leike70/RoboSister_Group2/docs/HARDWARE_TOPOLOGY.md

# 硬件拓扑与待确认表

本表只记录能从工程、配置、规则文档直接确认的内容。空着的不是“已确认”，而是**待确认**；不要用推理补成实物接线。

| 项目 | 工程车 | 炮台车 | 当前状态 / 备注 |
| --- | --- | --- | --- |
| 主控 C 板 | 1 块 STM32F407IGH6 | 1 块 STM32F407IGH6 | 代码/`.ioc` 确认；实际板卡未核验 |
| 电池 | 1 块 TB47/48（按规则） | 1 块 TB47/48（按规则） | 具体电池、接口、配电待确认 |
| 电源管理 | 待确认 | 待确认 | 炮台车测速管理模块/裁判主控接线待核验 |
| 底盘 | 左右履带，2×M3508（配置） | 左右履带，2×M3508（配置） | 轮距/轮径/减速比/方向待测 |
| 抬升 | 前/后 2×GM6020（配置） | 前/后 2×GM6020（配置） | 行程、同步、支撑/制动待确认 |
| 机械臂 | 2×达妙 4310（Yaw/Shoulder）、2×M3508（Elbow/Wrist）、1×M2006（Gripper） | 无 | 连杆、零位、限位、夹爪待确认 |
| 云台/发射 | 无 | GM6020 Yaw、达妙 6006 Pitch、2×M3508 摩擦、1×M2006 拨弹 | 限位、零位、摩擦/拨弹参数待确认 |
| CAN | CAN1/CAN2 | CAN1/CAN2 | 总线分配、设备 ID、报文 ID 待确认；0x31 来源总线未确认 |
| 功率/能量反馈 | 裁判 0x31（候选） | 裁判 0x31（候选） | 标准帧 DLC=4；实际接 CAN1/CAN2、周期、超时待确认 |
| 遥控 | USART3 + DMA/IDLE，DR16/DT7 DBUS | 同左 | 电平/反相、帧周期、S1/S2 映射待上板核验 |
| IMU | SPI1 BMI088 | 同左 | 安装方向、轴向、采样时序待标定 |
| 加热 | PF6 / TIM10_CH1 | 同左 | 加热器功率、热惯性、目标温度/PID/保护阈值待测 |
| 调试/烧录 | DAP-Link，`daplink_f4.cfg` | 同左 | 本轮未连接硬件，未执行烧录 |
| 规则限制 | 底盘 50 W / 500 J | 底盘 40 W / 400 J | 规则值已写入配置；规则版本仍有疑点，最终以赛务为准 |

## 接线原则

- 两车各一块 C 板，各自独立供电和控制；公共逻辑分别保存并同步维护。
- 底盘动力与机身/上层供电按规则分开，具体端口以最终接线图为准。
- 裁判系统主控模块单独列出，不等同于第二块 C 板。
- 任何未确认的 CAN 总线、ID、方向、减速比、零位、限位和 PID 继续保持未配置。
