leike70/RoboSister_Group2/docs/RULES_REQUIREMENTS.md

# 比赛规则对两车开发的要求

[此部分内容由AI生成]

阅读日期：2026-11-10。来源为 `资料文件/RoboSister_2026_比赛规则手册.pdf`，共 33 页。已通读全文提取文字，并查看版本页、功率/规格/物资表和裁判系统接线图。页码均为 PDF 实际页码。本文区分手册要求与开发建议，最终解释以赛务为准。

## 1. 版本疑点

封面写 V1.1，版本历史却已有日期空白的 V1.2，涉及考核、功率和缓冲能量。先按这份文件正文登记，不宣称已确认最终版。第 11 页称能量低于 0 J 断电，第 12 页步骤 e 写 `Z <= 0`；软件规划应避免触及 0 J，最终判定需核实赛务与实际模块。两车配置现已登记 50 W/500 J 与 40 W/400 J，仍需确认最终规则版本。

## 2. 两车硬约束

来源：第 12–13 页第 2 章、第 16–17 页 3.3.3。

| 项目 | 工程车 | 炮台车 |
| --- | --- | --- |
| 初始位置 | 启动区 1 | 启动区 2 |
| 底盘功率上限 | 50 W | 40 W |
| 缓冲能量上限 | 500 J | 400 J |
| 最大重量 | 15 kg，含裁判系统、不含 TB47/48 电池 | 12.5 kg，含裁判系统、不含 TB47/48 电池及 17 mm 弹丸 |
| 初始尺寸 | 450×450×450 mm | 400×400×400 mm |
| 伸展尺寸 | 700×700×700 mm | 600×600×600 mm |
| 初始弹丸 | 不得携带 17 mm 弹丸 | 基础 30 发，考核名次有调整，实际额度需核实 |
| 发射机构 | 无 | 1 个 17 mm 发射机构，初速度不大于 25 m/s |
| 操作手 | 1 名 | 1 名 |

尺寸约束覆盖地面投影和最高点，需要检查整车抬升、机械臂/云台运动的完整包络，不能只约束末端坐标。手册建议预留 100 g、5 mm 余量。相同底盘设计仍可使用，但两车的功率配置与整车包络不同。

## 3. 功率与供电：从占位预算转到真实规则

来源：第 11–12 页 1.5、第 14 页 3.2.2、第 29 页 7.1、第 32 页接线图。

水平行进、转向动力计入底盘功率；抬升车体等功能性越障动作不计入，具体机构归属由组委会判定。按现有方案，左右履带计入底盘侧，抬升与上层机构按机身侧规划并核验。`App/Power/` 已解析 0x31 并计算底盘策略；旧的全车归一化预算只供非底盘路径作代理量，电机最终限流尚未接入，不能据此证明满足 50 W/40 W 限制。

手册机制：初始能量 Z 设为本车上限 Q；裁判每 1 ms 按 `Z = Z - (Pr - Pl) * 0.001` 计算，限制在 -10 J 到 Q；触及断电条件后底盘断电 5 秒，期间继续计算能量。软件估计不能代替裁判真值。

### 已明确的电源模块反馈

| 字段 | 手册定义 |
| --- | --- |
| 帧类型、ID | 标准 CAN，`0x31` |
| 波特率、DLC | 1 Mbps，4 字节 |
| 数据 0–1 | 小端有符号 int16，底盘功率，0.1 W/单位 |
| 数据 2–3 | 小端有符号 int16，缓冲能量，0.1 J/单位 |

解析例子：`F4 01 88 13` 对应 50 W、500 J；`90 01 A0 0F` 对应 40 W、400 J；能量字节 `F6 FF` 对应 -1 J。需要检查帧类型、ID、DLC、时间戳和有效性，不能套用只面向 8 字节电机帧的解析。

尚未确认：实际接本车 CAN1 还是 CAN2、反馈发送周期与失联阈值。1000 Hz 是裁判能量结算频率，不等于 CAN 报文频率。开发需处理底盘被断电、机身仍供电的状态，恢复后不得直接重发旧行进请求。

电池接电源管理模块，炮台车测速管理模块另有直接电池供电支路；其余电池供电设备经电源管理模块输出。行进动力接底盘端口，其他接机身端口；底盘供电板不得又接机身电源。每车最多一块 TB47/48 电池，电池输出电流不大于 27 A，电池负极到任意点电压不超过 30 V；机械电源开关应便于快速接触。

## 4. C 板与裁判主控模块必须区分

来源：第 26 页物资表、第 29–32 页模块图与接线图。

- C 型开发板共提供 2 块，本项目每车 1 块，用于本车程序。
- 裁判系统另有 1 个“主控模块”，炮台车搭载，通过 MainCtrl 航空口连接测速管理模块；它不是第二块可编写整车控制程序的 C 板。
- 炮台车还需测速管理模块与 17 mm 测速模块。裁判主控安装须满足第 16 页外侧、平放及直径 70 mm 上半球净空要求。

所以“一辆车只有一个 C 板”的工程约定不变，但物资、接线图和说明书必须单列裁判模块。这次查看的是规则手册内接线图，不等于已核对此前共享附件《走线.pdf》的实物接线。

## 5. 任务与比赛流程对现有计划的影响

来源：第 7–11 页 1.2–1.4，第 18–23 页第 4 章。

| 内容 | 规则依据与开发含义 |
| --- | --- |
| 弹药补给 | 弹药箱约 150×150×50 mm，每箱 30 发；直接撒到地面会受罚。夹持、搬运和倾倒需控制姿态并对准弹仓 |
| 飞镖 | 场上共 2 个；对同一基地首次有效造成 600 点、之后 800 点伤害。不能假设两枚一定都能取得 |
| 能量单元 | 蓝、粉各 1 个，可分别屏蔽上、下装甲伤害 5 分钟。之前计划遗漏，应增加抓取/放置任务候选 |
| 兑换框左右格 | 飞镖放左格对应上装甲、右格对应下装甲。对应装甲已屏蔽时，飞镖解除屏蔽而不造成伤害；目标位置不能只写一个统一兑换点 |
| 基地接触 | 自身结构不能直接接触基地，兑换处例外；违规可罚下。需检查连杆、夹爪包络与操作路径 |
| 发射与增益 | 初速不大于 25 m/s 是限制；建议不高于 5 发/秒是识别频率建议。启动区 200%、二级台阶 300%攻击增益，生效/失效延迟不超过 5 秒，不应由程序自行认定已经生效 |
| 人工操控 | 各车 1 名操作手；优先验收手动抓取、搬运、倾倒和射击，再投入自动任务串联 |
| 考核训练 | 工程挑战 10 分钟，弹丸每颗 1 分、飞镖/能量单元各 100 分；射击挑战 7 分钟，3/5/8/10 m 各射 20 发。考核训练与正赛结算应分开 |

正赛准备阶段 2 分钟、比赛 10 分钟，结束后立即断电；维修和技术暂停有阶段限制。物理开关映射、使能、故障和停机状态应让操作手清晰掌握。新增任务未自动修改任务枚举、逆解或动作算法。

## 6. 电机物资与现有方案核对

来源：第 26 页 6.1.2。以下是计划用量，不代表实物已清点。

| 型号 | 提供数 | 当前两车合计 | 余量 |
| --- | --- | --- | --- |
| M3508 + C620 | 8 | 8 | 0 |
| GM6020 | 5 | 5 | 0 |
| M2006 + C610 | 3 | 2 | 1 |
| J4310 2EC V1.2 | 2 | 2 | 0 |
| J6006 2EC | 1 | 1 | 0 |

现有方案与物资数量匹配。物资表 3508 标为 19:1，但机构总减速比还包含外部传动，不能据此把全部 gear_ratio 统一设成 19。

## 7. 通信、日程与材料要求

- 第 14–15 页允许官方 DT7/DR16 或符合规则的自定义控制器；自定义控制器不联网，不与己方机器人之外的设备通信。无线调试器上场前移除。
- 第 21 页列 11 月 11 日完整形态考核、11 月 14 日预检录/训练、11 月 15 日决赛。该日程仅来自本文件，仍需核实赛务最新通知。
- 第 22 页要求考核分析中的 AI 内容明显标注 `[此部分内容由AI生成]`，并由队伍整理，不能大篇幅直接照搬；提交现有 AI 辅助材料时检查标注与来源。

## 8. 后续开发建议

先确认最终规则版本、实际物资和两车接线/CAN 分配；DR16 DBUS、BMI088/EKF 和 0x31 解析/履带策略已有软件实现，下一步上板核对接收电平、通道方向、IMU 安装方向与 0x31 实际来源。随后接通真实电机适配与最终限流，逐模块验收方向、零位、限位、手动操控及收纳姿态；再按剩余时间安排道具兑换、补给和不同距离射击训练。自动逆解与任务串联需在基础控制可靠后投入。
