leike70/RoboSister_Group2/docs/REFERENCE_LIBRARY.md

# 资料库索引：开发前到哪里找依据

本索引对应仓库根目录的 `资料文件/`。它帮助接手工程车、炮台车的成员和 agent 找到原始资料，并区分“资料写了什么”“项目已经实现什么”“实车核验了什么”。资料库是参考输入，不参与两车固件编译；资料中的示例工程、旧设计和厂商默认值不能直接当作本车接线或控制参数。

修改代码前先读[项目需求](PROJECT_REQUIREMENTS.md)、对应车辆及模块 README；涉及下表的协议、器件、规则或机构时，再打开相应原始资料核对。若资料与用户明确需求、当前工程配置或实物测量不一致，记录冲突并保留待确认状态，不自行覆盖。

| 开发任务 | 原始资料在哪里 | 当前整理/代码入口 | 使用边界 |
| --- | --- | --- | --- |
| 比赛限制、裁判系统、底盘功率/缓冲能量 | [RoboSister_2026_比赛规则手册.pdf](../资料文件/RoboSister_2026_比赛规则手册.pdf) | [规则摘录与版本疑点](RULES_REQUIREMENTS.md)、[硬件拓扑](HARDWARE_TOPOLOGY.md)、两车 `App/Power/` | 本地手册封面与版本历史有疑点；50 W/500 J、40 W/400 J 是本地手册值，最终版本以赛务确认为准。规则中的 0x31 格式不证明实际接在 CAN1 或 CAN2。 |
| 遥控 DBUS 帧、通道/开关/键鼠解析 | [遥控器控制协议V1.4.pdf](../资料文件/遥控器/遥控器控制协议V1.4.pdf)、[DT7&DR16遥控系统用户手册_中文.pdf](../资料文件/遥控器/DT7&DR16遥控系统用户手册_中文.pdf) | [遥控与任务说明](PERIPHERALS_AND_TASKS.md)、两车 `User_Driver/Remote/`、`Bsp/remote_uart.*`、`App/Remote/` | 协议格式可用于核对解析；实际电平/反相、帧周期、S1/S2 与控制方向仍须上板确认。中/上/下档的项目语义以当前需求为准，不能从参考工程推断。 |
| 大疆 M3508/M2006/GM6020 与 C610/C620 电调 | [大疆电机资料目录](../资料文件/电机资料/大疆电机/)：各电机使用说明、3508 保养手册、C610/C620 电调说明 | 两车 `User_Driver/Motor_Driver/DJI_motor_driver.*`、`Bsp/CAN_bsp.*`、`Config/app_config.*`、[硬件拓扑](HARDWARE_TOPOLOGY.md) | 用手册核对电调协议、反馈 DLC、控制报文和额定范围；具体 CAN 总线、设备 ID、方向、零位、传动比、限位仍要按本车实物确认。 |
| 达妙 DM-J4310-2EC、DM-J6006-2EC | [达妙电机资料目录](../资料文件/电机资料/达妙电机/)：两份电机说明书及[调试助手/控制协议 V1.3](../资料文件/电机资料/达妙电机/调试助手使用说明书（达妙驱动控制协议）V1.3.pdf) | [项目需求中的机构分配](PROJECT_REQUIREMENTS.md)、各车 `Config/` 和将来的达妙适配层 | 工程车用 4310，炮台车 Pitch 用 6006；协议版本、控制模式、CAN ID 和量程须核实。当前车辆工程尚无可用的达妙电机适配层。 |
| BMI088、SPI、四元数 EKF、温控移植 | [陀螺仪移植文件/README.md](../资料文件/陀螺仪移植文件/README.md)、`Components/Devices/BMI088driver.*`、`Components/Algorithm/QuaternionEKF.*`、`Components/kalman_filter.*`、`Application/ins_task.*`、`Src/spi.c` | 两车 `Bsp/imu_bsp.*`、`Bsp/imu_heater.*`、`User_Driver/IMU/`、`Task/imu_task.*`、[当前 IMU/温控说明](PERIPHERALS_AND_TASKS.md) | 这是独立的 C 板参考工程，包含它自己的 HAL、FreeRTOS、构建和调试文件。查算法/寄存器/流程时参考，不把整个参考工程复制进两车。当前代码已移植但轴向、加热器和实时性未上板核验。 |
| 机构构型、空间约束和历史方案 | [期中设计思路](../资料文件/2组期中考核/文档/设计思路.docx)、[期中答辩](../资料文件/2组期中考核/文档/期中答辩.pptx)、[工程机器人总装](../资料文件/2组期中考核/工程机器人总装/)、[炮塔机器人总装](../资料文件/2组期中考核/炮塔机器人总装/) | [项目需求](PROJECT_REQUIREMENTS.md)、[硬件拓扑](HARDWARE_TOPOLOGY.md)、两车各自机构模块 | 期中方案和 CAD 可帮助找装配、干涉、尺寸线索；不能据文件名或历史模型认定最终实物尺寸、传动、零位、限位和线束。最终装配与测量优先。 |

## 资料库中的几个易混淆点

- `资料文件/陀螺仪移植文件/` 是**参考工程**，其中的 `Drivers/`、`Middlewares/`、`MDK-ARM/`、`.ioc` 和编译产物不属于当前两车固件源码；当前实现应在各自 `project file/` 内查找。
- `资料文件/2组期中考核/` 保存两车装配及阶段文档，不能替代本车最新的电机映射表和实测参数。
- 规则手册提到的裁判系统“主控模块”与两辆车各自的 C 板是不同设备；0x31 功率帧的**协议定义**、**接线来源**和**已上板验证**是三件事。[规则摘录](RULES_REQUIREMENTS.md)记录了已知值与疑点。
- 资料库目前没有可直接确认本车 CAN1/CAN2 设备分配、全部电机 ID、实车安装方向、机构零位/限位、IMU 加热器参数的最终接线/标定表。相关配置继续保持待确认；拿到经核验的数据后，先更新[硬件拓扑](HARDWARE_TOPOLOGY.md)和对应车辆配置。

本索引按文件目录、资料标题和已有项目文档建立；它不表示已逐页复核每份厂商手册，也不表示资料中的示例已在实车验证。新增或替换资料时，同步更新本表的入口、版本与核验状态。
