leike70/RoboSister_Group2/资料文件/2组期中考核/文档/期中答辩.pptx

## 期中答辩

## 场地分析：

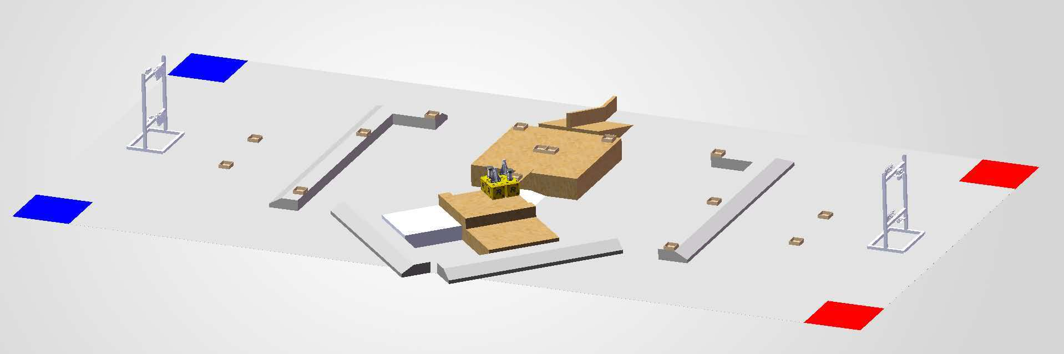
[picture p1: figure]
51cfad9a7a7458d218ad67e008c4f556

## 战术分析：

- 工程炮塔一起上台阶
- 工程拿飞镖去对面基地
- 炮塔吃300%增益

## 上台阶：

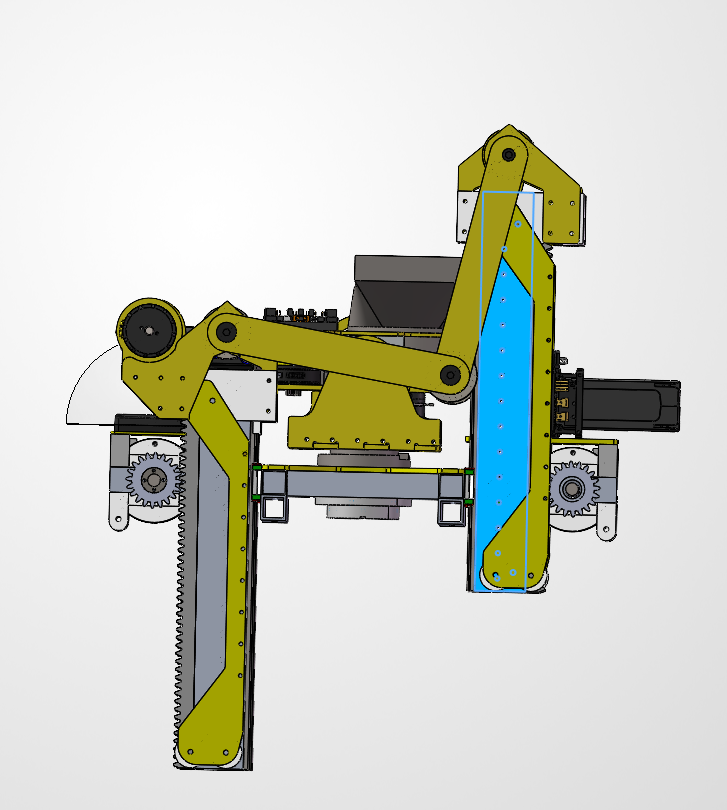
[picture p2: figure]
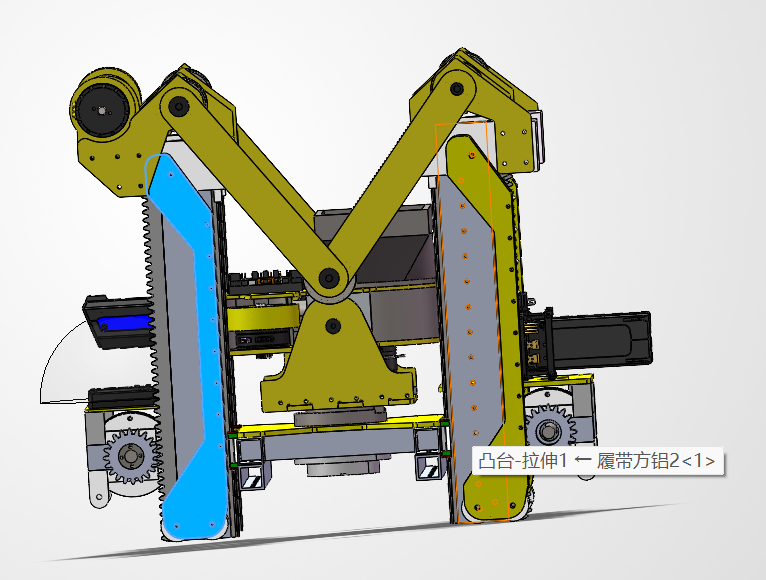
[picture p3: figure]
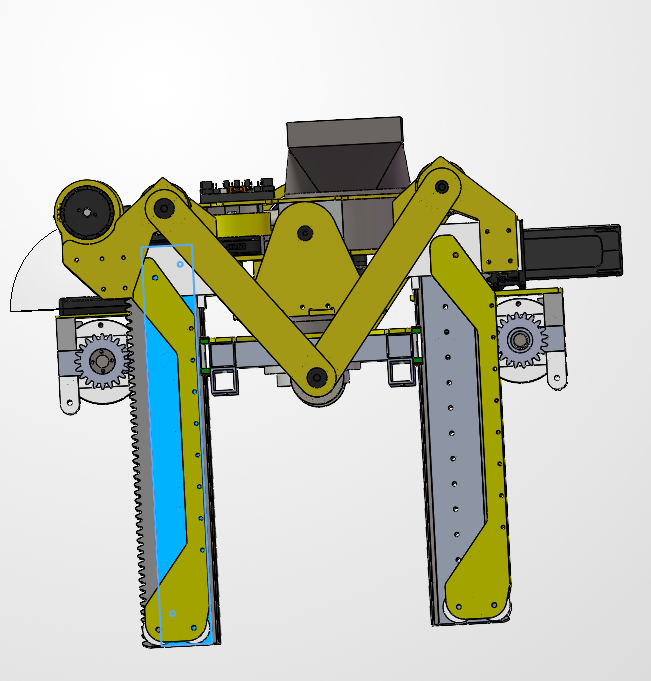
[picture p4: figure]

## 抓取：

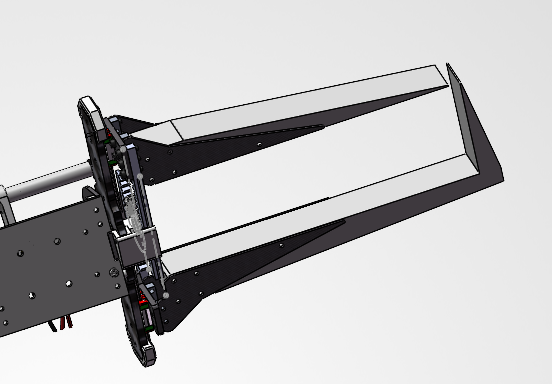
[picture p5: figure]

## 风险评估：

车架：稳定性（能否上台阶）
机械臂：重心问题
炮塔：视觉模块，瞄准

## Slide 7
