leike70/RoboSister_Group2/资料文件/2组期中考核/文档/设计思路.docx

轮组设计说明：

目标：旨在让工程和炮塔两台车都拥有上下台阶的能力

实现原理：大体思路参考杨瀚翔提出的设想，通过四个竖直放置可升降轮腿实现爬升。爬升动作：1四腿将整车抬起 2前进至辅助轮接触台阶 3上抬前轮组至辅助轮和台阶面高度 4前进至腹辅助轮接触台阶 5后轮组抬起至台阶面 6继续前进，已在台阶上

主要设计：首先，由于电机数量限制，最终分配到轮组的电机为每辆车两个3508，所以驱动模式参照坦克的同侧同转向实现基础移动功能。其次，因为单侧前后轮升降不同步，同一对应点之间距离存在变动，为了能在前后两个轮间传输动力，传统的同步带直连无法使用，参照初中学过的三角形，使用两段固定长度的同步带组合成两条边，以替代原来直连长度不可动的缺陷。最后，补齐基础功能所需架构，由6020驱动的升降结构和固定使用的滑轨滑块，其中滑轨放在内侧，车架受力更稳定。电机侧置，为尺寸限制留出更多空余。

腿型迭代：初版的腿方铝是直接在履带下的，这样会导致只有单根滑轨受力且履带有概率与方铝发生干磨，结合杨羡夫的方案，组成当前版本的方铝承压，玻纤板支撑履带带轮的结构。

小臂设计说明：

使用M3508作为roll小pitch的关节电机,扭力较大 小roll与爪部采用M5D10的铝柱连接,电机外包一个滚针轴承作为支撑,轴承用一个打印 件抱紧。 roll 和小臂通过玻纤板连接,板材之间采用榫卯+铝排的连接方式 小 pitch 通过M8的杯头螺栓限位,转角大概100度左右 小臂的两块板材使用铜柱支撑

小 pitch一端电机连接打印件,另一端通过打印件固定一个推力球轴承,轴承内圈用于固定 的打印件与大臂相连,靠两块大臂板材压紧。

大臂设计说明：

介于此次比赛采用的战术 工程车的任务是 1.在一级台阶下完成弹仓的拾取并将其举起抬升给在一级台阶上的炮塔车装弹 2.登上二级台阶并拾取飞镖道具 一个放入储存框一个夹持在手部 故全车轮组车架采用和炮塔车相同的履带可抬升版车架 且使用五轴机械臂完成动作

一 大yaw轴 电机采用DM 4310直驱 在底部打印件垫块与板材间做了限位使之可以完成180°转向并且不能转超过270°

炮塔设计说明：

炮塔采用上供弹，简便高效。采用3508作为摩擦轮，射速大。Pitch轴采用6020，扭矩大，适合大重量炮塔。Yaw轴采用J6006，扭矩极大，稳定性极强，便于精确快速瞄准。漏斗做的很大，便于倒弹。
