leike70/RoboSister_Group2/docs/archive/README.md

# 历史记录

这里保存已完成阶段的检查、提示词和交付记录。当前开发从 [文档目录](../README.md) 开始，接口与遥控状态以 [当前说明](../PERIPHERALS_AND_TASKS.md) 为准。

| 记录 | 用途 |
| --- | --- |
| [基础工程检查](BASELINE_REVIEW.md) | 原始工程基线、驱动问题及最初构建结果 |
| [首轮框架提示词](DEEPSEEK_PROMPT.md) | 当时交给DeepSeek的任务原文，仅作历史留存 |
| [首轮框架交付](FRAMEWORK.md) | 首轮模块、启动与调度、构建和待办 |
| [首轮框架复核](FRAMEWORK_REVIEW.md) | 当时发现的四项逻辑问题 |
| [四项修复与验证](FRAMEWORK_FIXES.md) | 模式隔离、故障恢复、快照与姿态有效性修复 |
| [后续交付与遥控整改](DEEPSEEK_HANDOFF_RESULT.md) | 三档整理、接收接入、到达时间与原始快照修复记录 |

文中代码位置和构建目录通常从项目根起算；提到的旧模式、未接入状态、内存占用和测试范围应结合当时阶段理解。“根README第几节”的旧结构已移入 [项目约定](../PROJECT_REQUIREMENTS.md)。
