leike70/RoboSister_Group2/资料文件/2组期中考核/工程机器人总装/联轴打印.SLDPRT

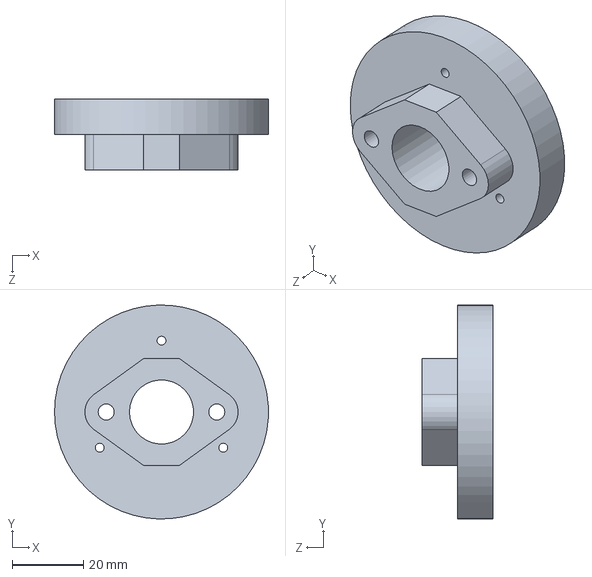
[picture p15: CAD file, 2026-11-10]
资料文件/2组期中考核/工程机器人总装/联轴打印.SLDPRT
60.0 x 60.0 x 20.0 mm
