leike70/RoboSister_Group2/资料文件/2组期中考核/炮塔机器人总装/同步带连接臂_外.SLDPRT

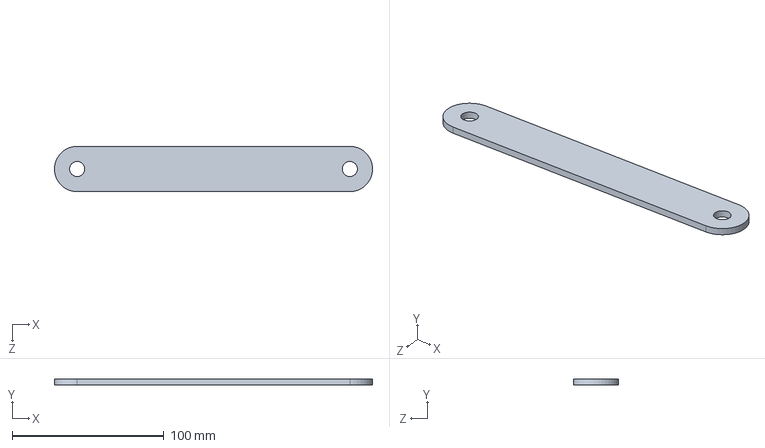
[picture p16: CAD file, 2026-11-10]
资料文件/2组期中考核/炮塔机器人总装/同步带连接臂_外.SLDPRT
209.9 x 4.00 x 30.0 mm
