leike70/RoboSister_Group2/资料文件/2组期中考核/工程机器人总装/推力球轴承45-65-14.SLDPRT

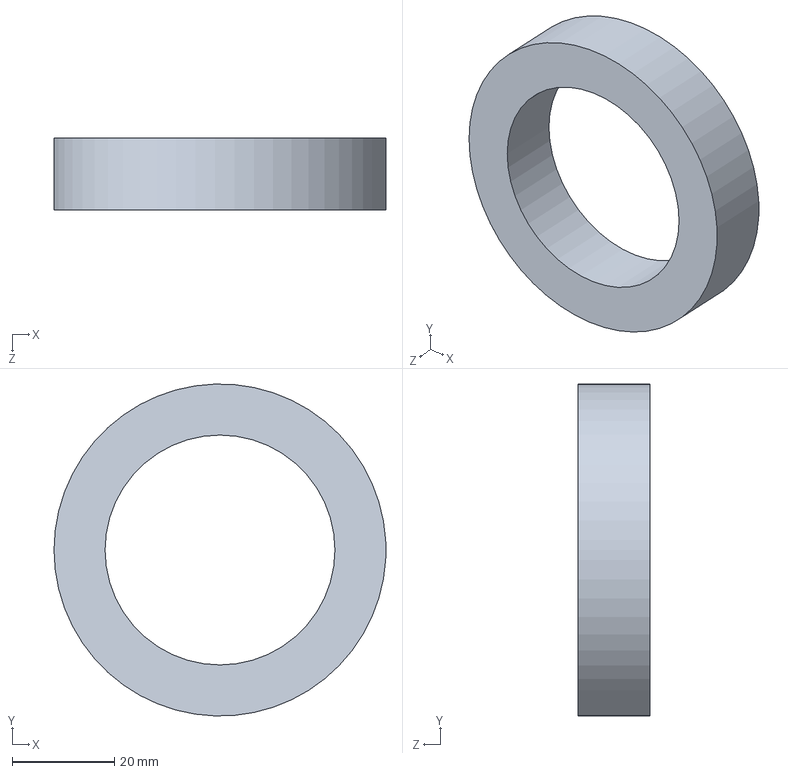
[picture p17: CAD file, 2026-11-10]
资料文件/2组期中考核/工程机器人总装/推力球轴承45-65-14.SLDPRT
65.0 x 65.0 x 14.0 mm
