leike70/RoboSister_Group2/资料文件/2组期中考核/炮塔机器人总装/法兰轴承10-19-7-21-1.SLDPRT

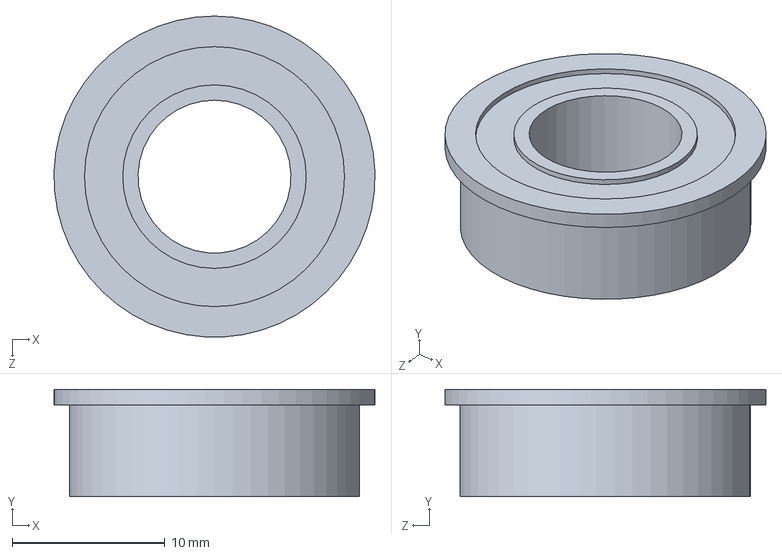
[picture p19: CAD file, 2026-11-10]
资料文件/2组期中考核/炮塔机器人总装/法兰轴承10-19-7-21-1.SLDPRT
21.0 x 7.00 x 21.0 mm
