leike70/RoboSister_Group2/资料文件/2组期中考核/工程机器人总装/同步带同步轮-关节.SLDPRT

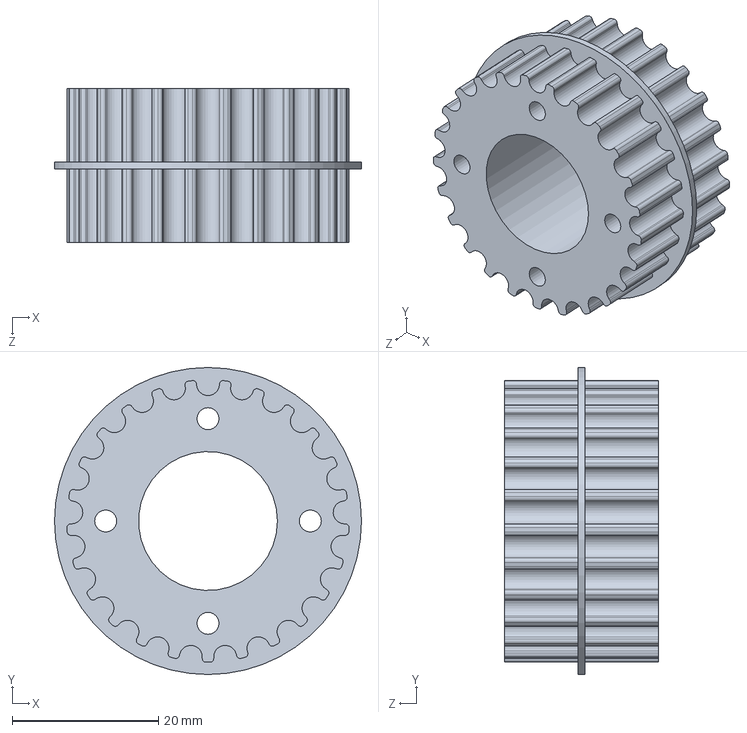
[picture p20: CAD file, 2026-11-10]
资料文件/2组期中考核/工程机器人总装/同步带同步轮-关节.SLDPRT
42.0 x 42.0 x 21.0 mm
