leike70/RoboSister_Group2/资料文件/2组期中考核/炮塔机器人总装/M3508直流无刷减速电机.SLDPRT

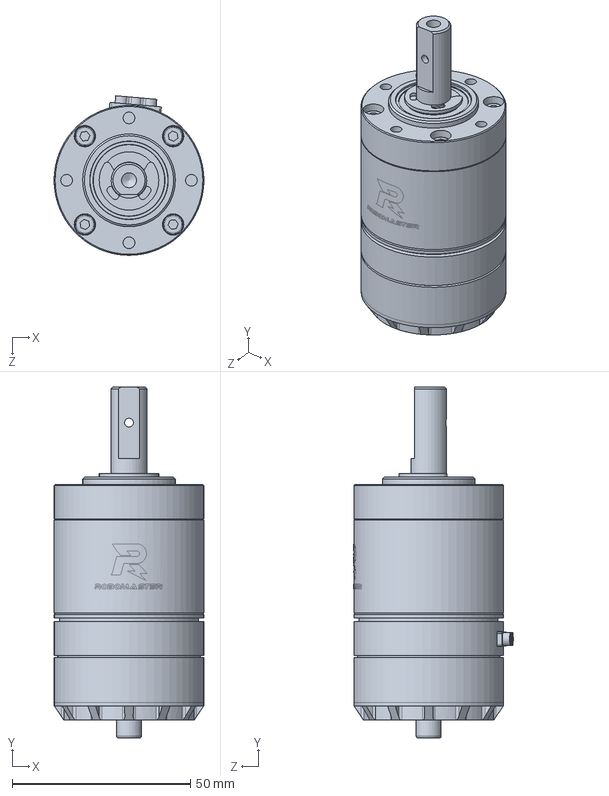
[picture p21: CAD file, 2026-11-10]
资料文件/2组期中考核/炮塔机器人总装/M3508直流无刷减速电机.SLDPRT
42.0 x 98.4 x 44.7 mm
