leike70/RoboSister_Group2/资料文件/2组期中考核/炮塔机器人总装/垫片M10-14-1.SLDPRT

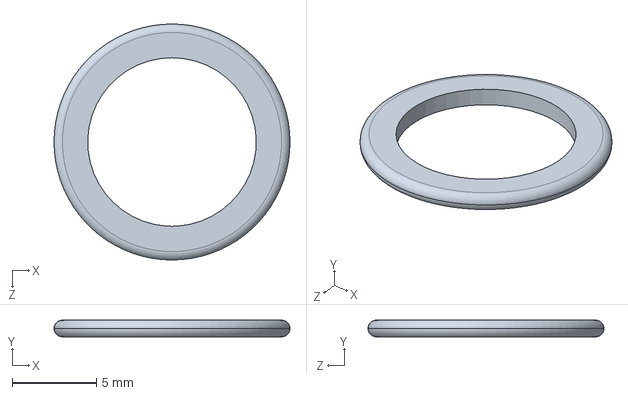
[picture p22: CAD file, 2026-11-10]
资料文件/2组期中考核/炮塔机器人总装/垫片M10-14-1.SLDPRT
14.0 x 1.00 x 14.0 mm
