leike70/RoboSister_Group2/资料文件/2组期中考核/炮塔机器人总装/履带碳板.SLDPRT

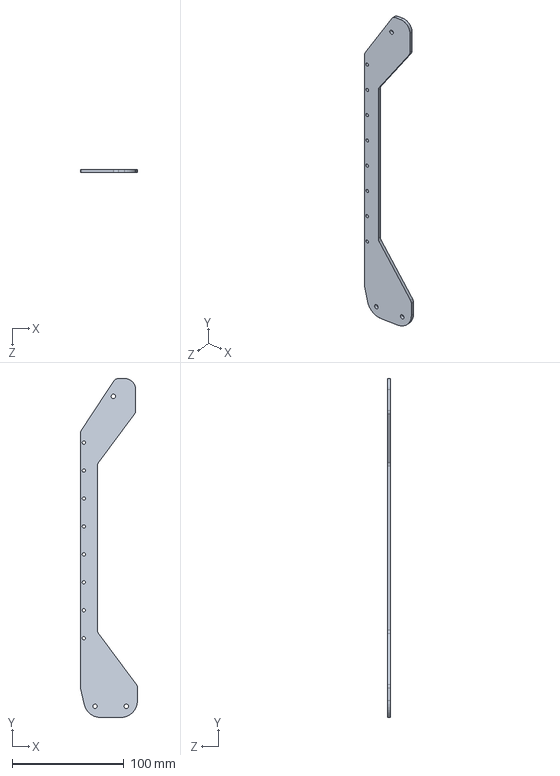
[picture p23: CAD file, 2026-11-10]
资料文件/2组期中考核/炮塔机器人总装/履带碳板.SLDPRT
51.0 x 303.4 x 3.00 mm
