leike70/RoboSister_Group2/资料文件/2组期中考核/工程机器人总装/同步带履带同步轮组合-从动轮盖片.SLDPRT

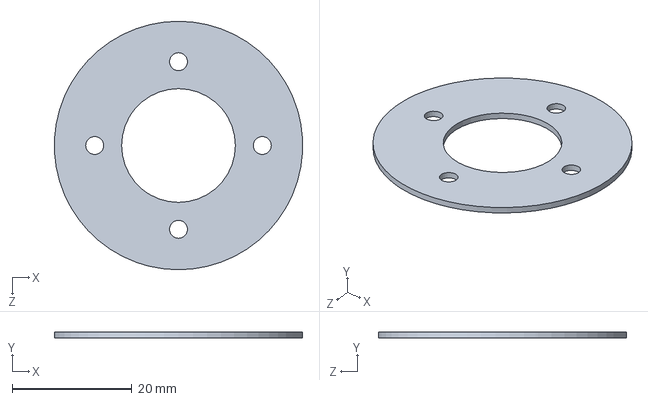
[picture p24: CAD file, 2026-11-10]
资料文件/2组期中考核/工程机器人总装/同步带履带同步轮组合-从动轮盖片.SLDPRT
41.4 x 1.00 x 41.5 mm
