leike70/RoboSister_Group2/资料文件/2组期中考核/炮塔机器人总装/M2006 P36直流无刷减速电机.SLDPRT

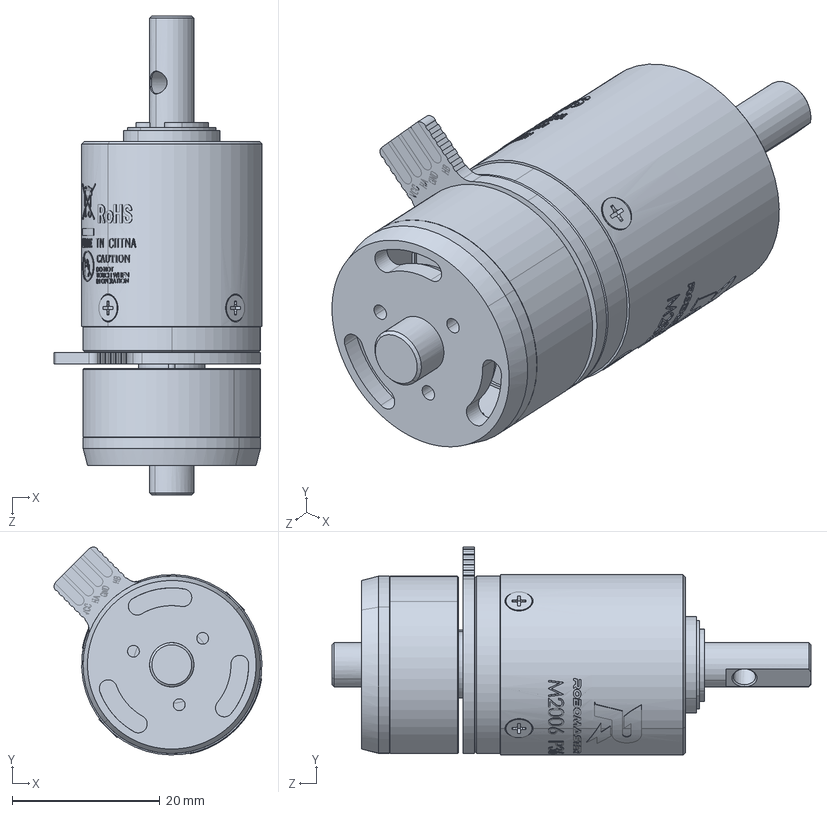
[picture p25: CAD file, 2026-11-10]
资料文件/2组期中考核/炮塔机器人总装/M2006 P36直流无刷减速电机.SLDPRT
28.1 x 28.1 x 64.8 mm
