leike70/RoboSister_Group2/资料文件/2组期中考核/工程机器人总装/台湾上银MGN9C滑块.SLDPRT

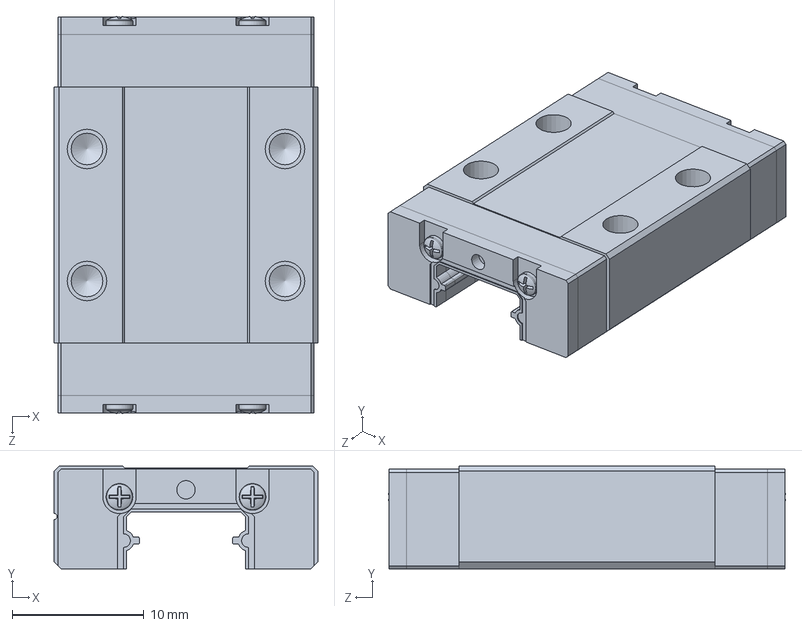
[picture p26: CAD file, 2026-11-10]
资料文件/2组期中考核/工程机器人总装/台湾上银MGN9C滑块.SLDPRT
20.0 x 7.80 x 30.1 mm
