leike70/RoboSister_Group2/资料文件/2组期中考核/炮塔机器人总装/天轮打印1号.SLDPRT

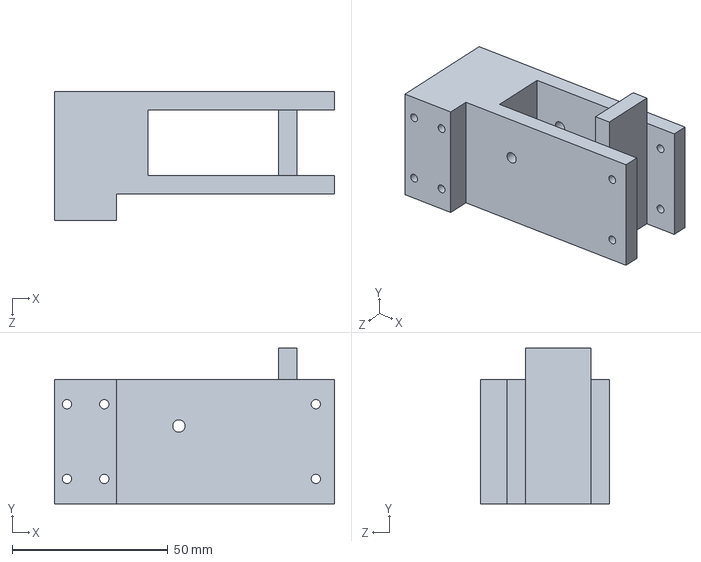
[picture p27: CAD file, 2026-11-10]
资料文件/2组期中考核/炮塔机器人总装/天轮打印1号.SLDPRT
90.0 x 50.0 x 41.5 mm
