leike70/RoboSister_Group2/资料文件/2组期中考核/工程机器人总装/天轮支撑板_C.SLDPRT

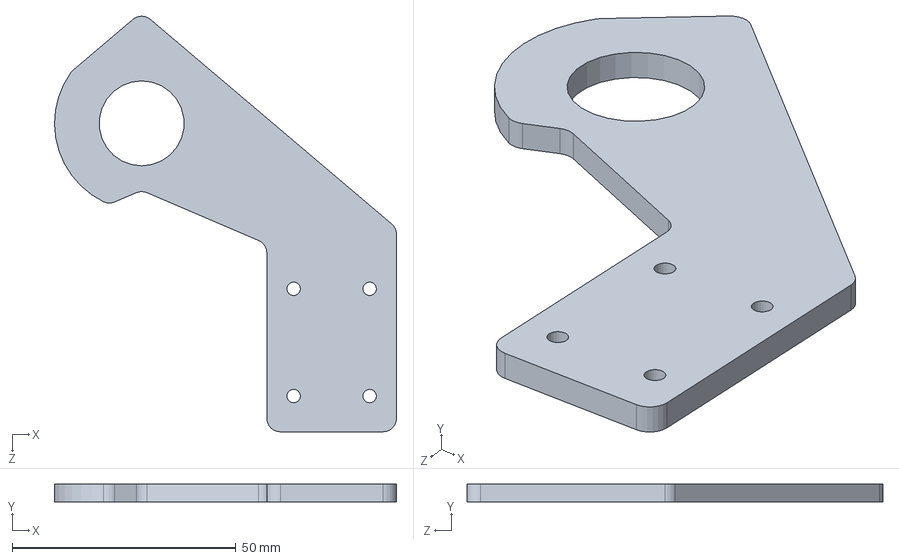
[picture p28: CAD file, 2026-11-10]
资料文件/2组期中考核/工程机器人总装/天轮支撑板_C.SLDPRT
76.5 x 4.00 x 93.0 mm
