leike70/RoboSister_Group2/资料文件/2组期中考核/炮塔机器人总装/支撑板1.SLDPRT

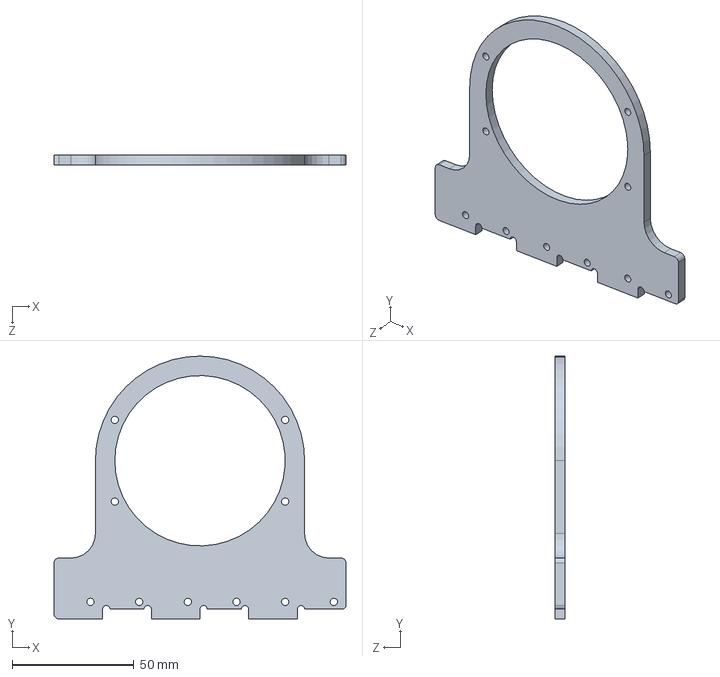
[picture p29: CAD file, 2026-11-10]
资料文件/2组期中考核/炮塔机器人总装/支撑板1.SLDPRT
120.0 x 108.0 x 4.00 mm
