leike70/RoboSister_Group2/资料文件/2组期中考核/工程机器人总装/齿条固定件.SLDPRT

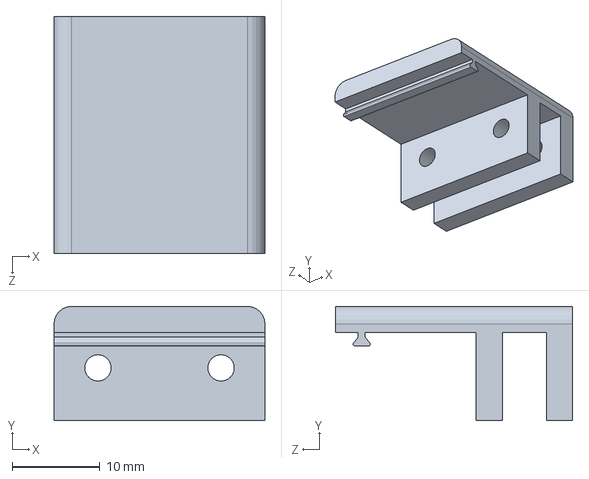
[picture p30: CAD file, 2026-11-10]
资料文件/2组期中考核/工程机器人总装/齿条固定件.SLDPRT
24.0 x 13.0 x 27.0 mm
