leike70/RoboSister_Group2/资料文件/2组期中考核/炮塔机器人总装/RoboMaster GM6020.SLDPRT

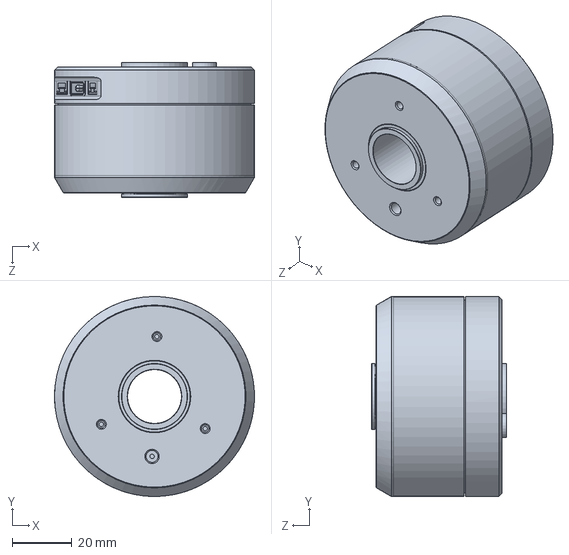
[picture p31: CAD file, 2026-11-10]
资料文件/2组期中考核/炮塔机器人总装/RoboMaster GM6020.SLDPRT
66.7 x 66.7 x 45.0 mm
