leike70/RoboSister_Group2/资料文件/2组期中考核/工程机器人总装/机械臂连接处轴承内圈上.SLDPRT

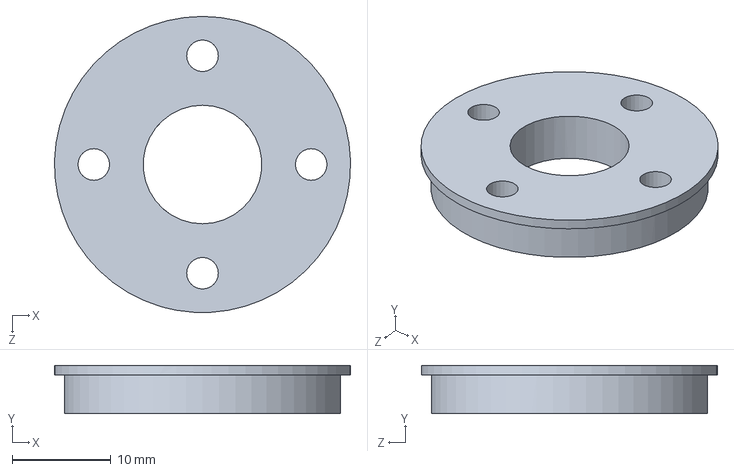
[picture p32: CAD file, 2026-11-10]
资料文件/2组期中考核/工程机器人总装/机械臂连接处轴承内圈上.SLDPRT
29.9 x 4.90 x 30.0 mm
