leike70/RoboSister_Group2/资料文件/2组期中考核/炮塔机器人总装/轴铝方管.SLDPRT

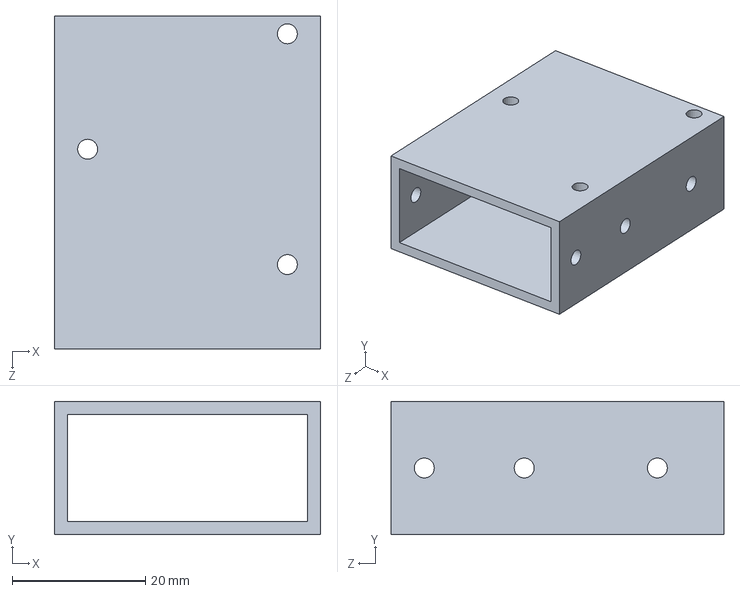
[picture p33: CAD file, 2026-11-10]
资料文件/2组期中考核/炮塔机器人总装/轴铝方管.SLDPRT
40.0 x 20.0 x 50.0 mm
