leike70/RoboSister_Group2/资料文件/2组期中考核/工程机器人总装/防松螺母M8.SLDPRT

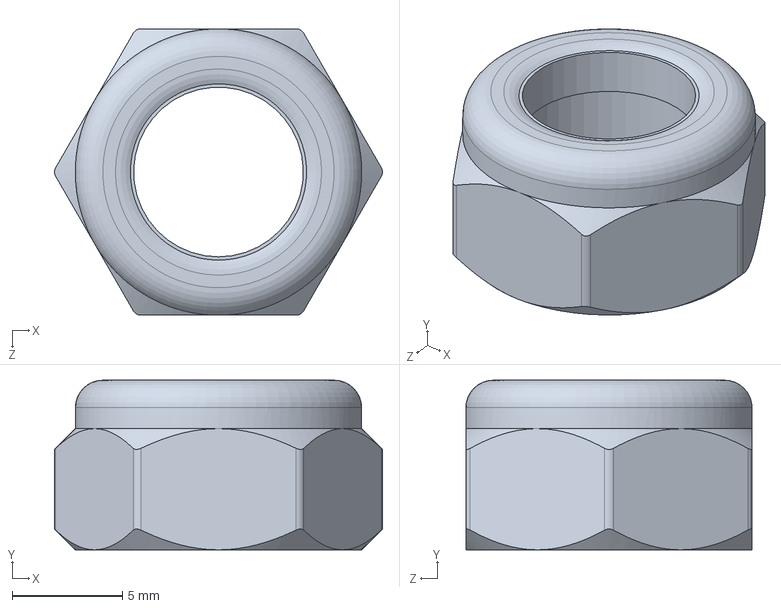
[picture p34: CAD file, 2026-11-10]
资料文件/2组期中考核/工程机器人总装/防松螺母M8.SLDPRT
14.9 x 7.70 x 13.0 mm
