leike70/RoboSister_Group2/资料文件/2组期中考核/炮塔机器人总装/主控支持打印件.SLDPRT

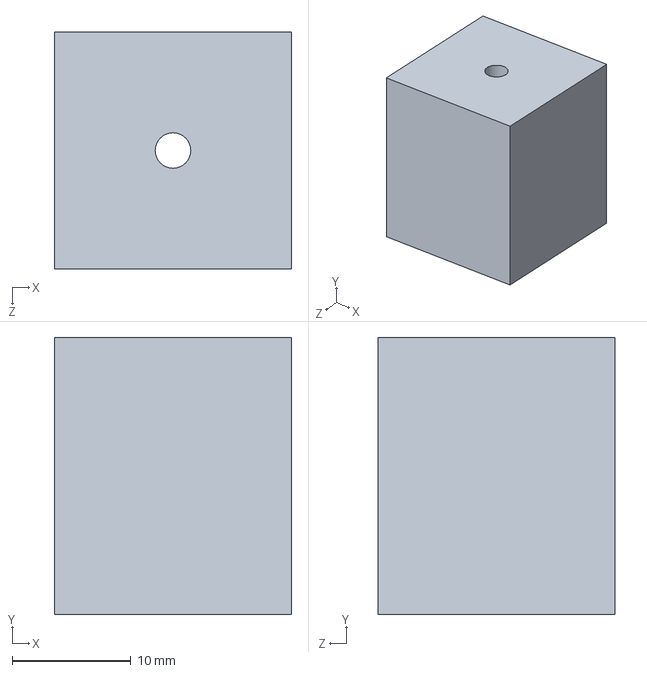
[picture p35: CAD file, 2026-11-10]
资料文件/2组期中考核/炮塔机器人总装/主控支持打印件.SLDPRT
20.0 x 23.4 x 20.0 mm
