leike70/RoboSister_Group2/资料文件/2组期中考核/工程机器人总装/杯头螺栓M8-12.SLDPRT

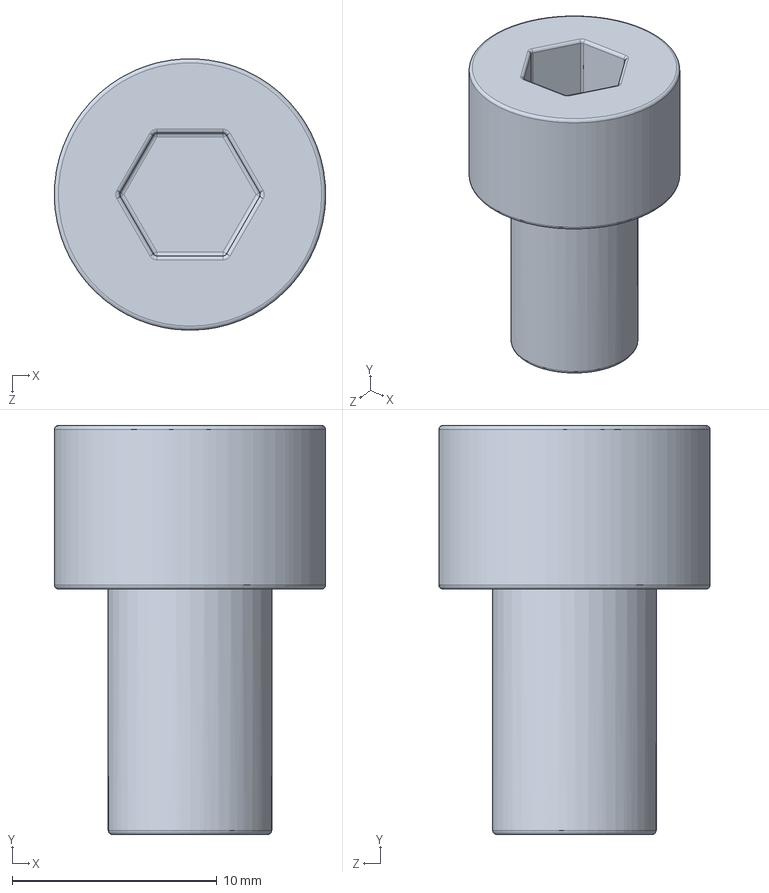
[picture p36: CAD file, 2026-11-10]
资料文件/2组期中考核/工程机器人总装/杯头螺栓M8-12.SLDPRT
13.3 x 20.0 x 13.3 mm
