leike70/RoboSister_Group2/资料文件/2组期中考核/炮塔机器人总装/同步带同步轮-电机.SLDPRT

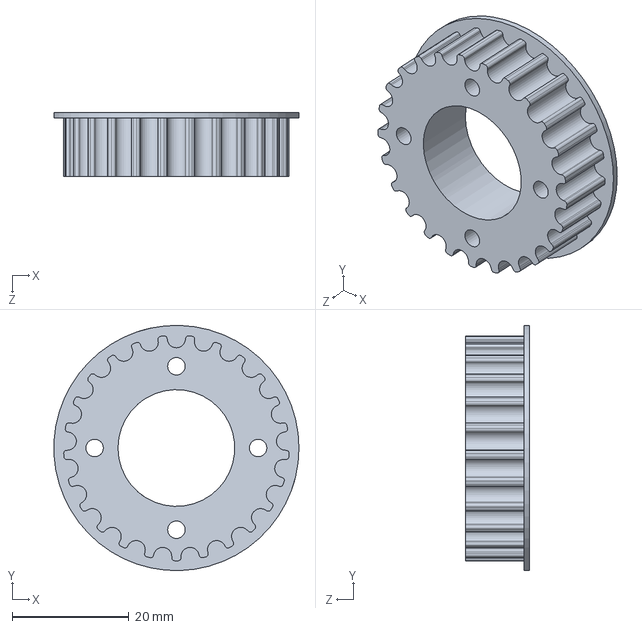
[picture p37: CAD file, 2026-11-10]
资料文件/2组期中考核/炮塔机器人总装/同步带同步轮-电机.SLDPRT
42.0 x 42.0 x 11.0 mm
