leike70/RoboSister_Group2/资料文件/2组期中考核/炮塔机器人总装/pitch轴固定铝柱.SLDPRT

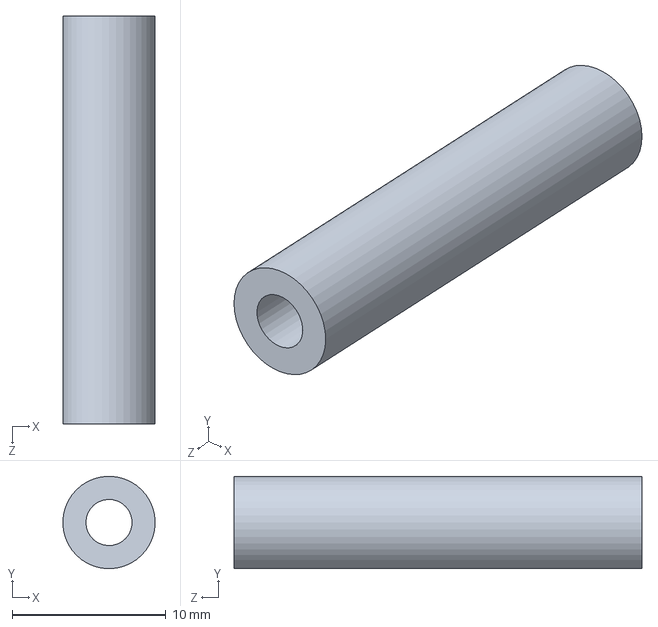
[picture p38: CAD file, 2026-11-10]
资料文件/2组期中考核/炮塔机器人总装/pitch轴固定铝柱.SLDPRT
6.00 x 6.00 x 26.5 mm
