leike70/RoboSister_Group2/资料文件/2组期中考核/炮塔机器人总装/天轮打印2号.SLDPRT

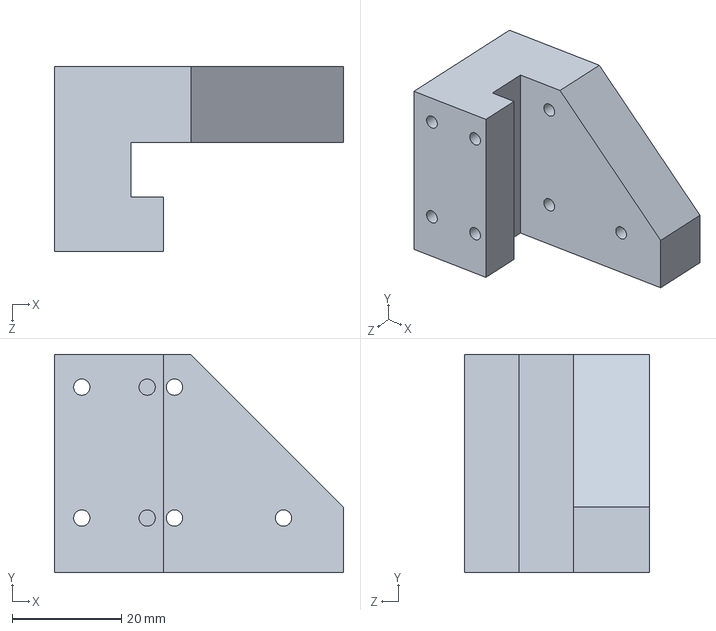
[picture p40: CAD file, 2026-11-10]
资料文件/2组期中考核/炮塔机器人总装/天轮打印2号.SLDPRT
53.0 x 40.0 x 34.0 mm
