leike70/RoboSister_Group2/资料文件/2组期中考核/工程机器人总装/深沟球轴承外圈.SLDPRT

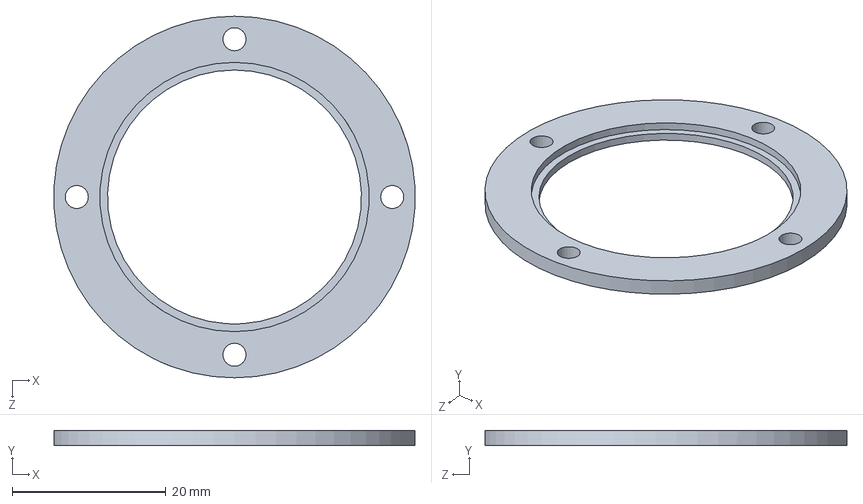
[picture p41: CAD file, 2026-11-10]
资料文件/2组期中考核/工程机器人总装/深沟球轴承外圈.SLDPRT
46.9 x 2.00 x 47.0 mm
