leike70/RoboSister_Group2/资料文件/2组期中考核/炮塔机器人总装/pitch轴小轴承.SLDPRT

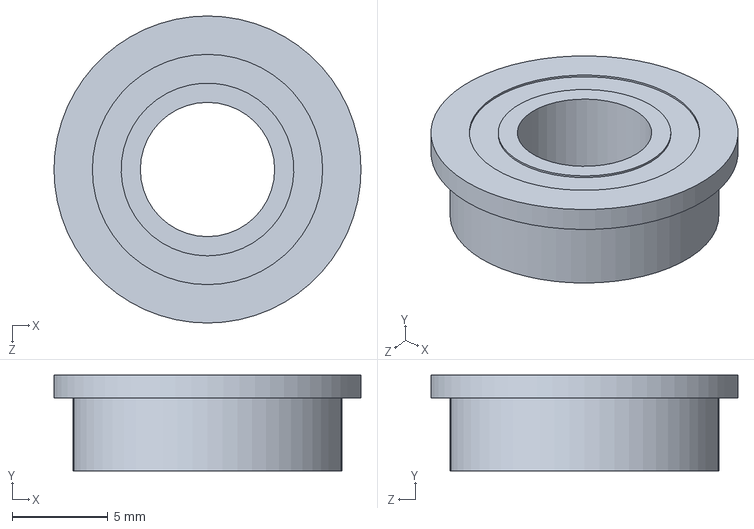
[picture p42: CAD file, 2026-11-10]
资料文件/2组期中考核/炮塔机器人总装/pitch轴小轴承.SLDPRT
16.0 x 5.00 x 16.0 mm
