leike70/RoboSister_Group2/资料文件/2组期中考核/工程机器人总装/滑轨保护件.SLDPRT

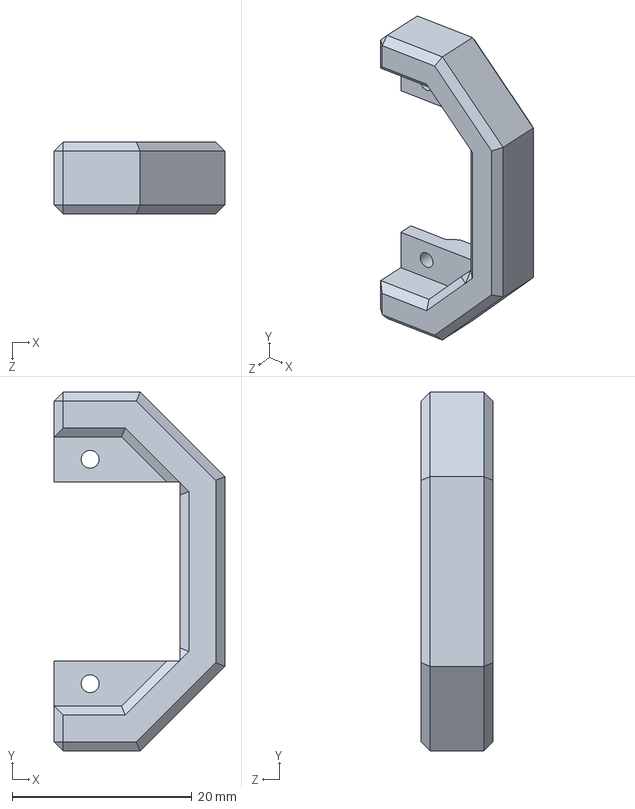
[picture p43: CAD file, 2026-11-10]
资料文件/2组期中考核/工程机器人总装/滑轨保护件.SLDPRT
19.0 x 40.0 x 8.00 mm
