leike70/RoboSister_Group2/资料文件/2组期中考核/炮塔机器人总装/官方元件-RoboMaster 主控板A板_奇点李想.SLDPRT

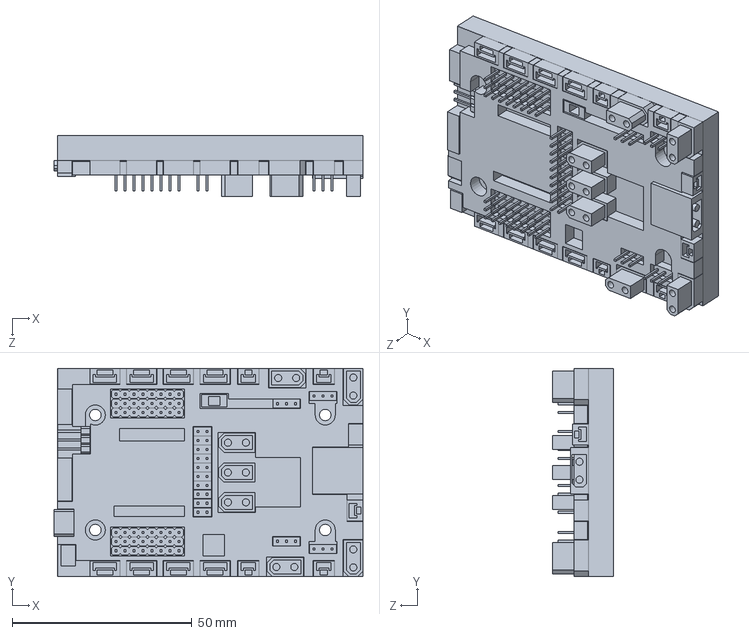
[picture p44: CAD file, 2026-11-10]
资料文件/2组期中考核/炮塔机器人总装/官方元件-RoboMaster 主控板A板_奇点李想.SLDPRT
86.0 x 58.0 x 17.0 mm
