leike70/RoboSister_Group2/资料文件/2组期中考核/工程机器人总装/塞打螺栓10-M8-100.SLDPRT

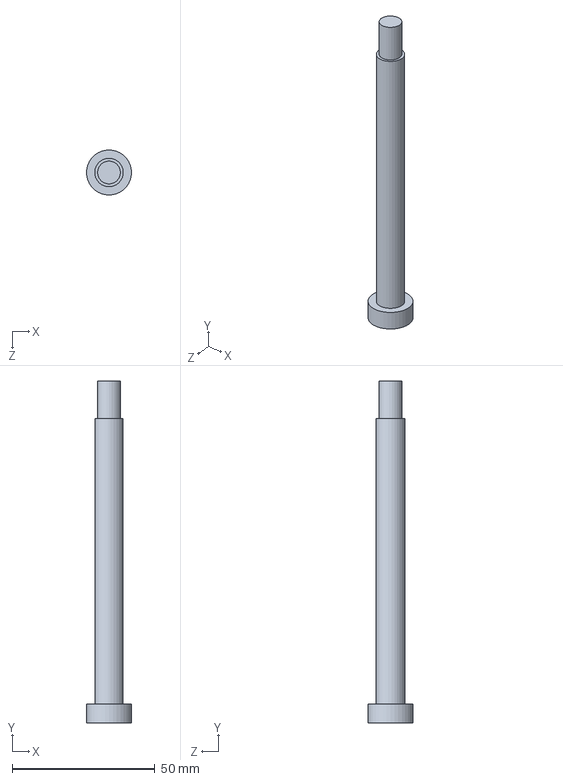
[picture p45: CAD file, 2026-11-10]
资料文件/2组期中考核/工程机器人总装/塞打螺栓10-M8-100.SLDPRT
15.8 x 119.9 x 15.8 mm
