leike70/RoboSister_Group2/资料文件/2组期中考核/炮塔机器人总装/支撑轮打印.SLDPRT

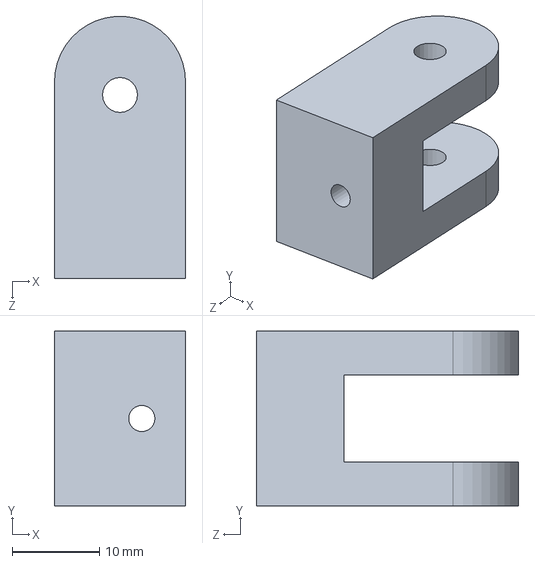
[picture p46: CAD file, 2026-11-10]
资料文件/2组期中考核/炮塔机器人总装/支撑轮打印.SLDPRT
15.0 x 20.0 x 30.0 mm
