leike70/RoboSister_Group2/资料文件/2组期中考核/工程机器人总装/大pitch底座电机固定板1.SLDPRT

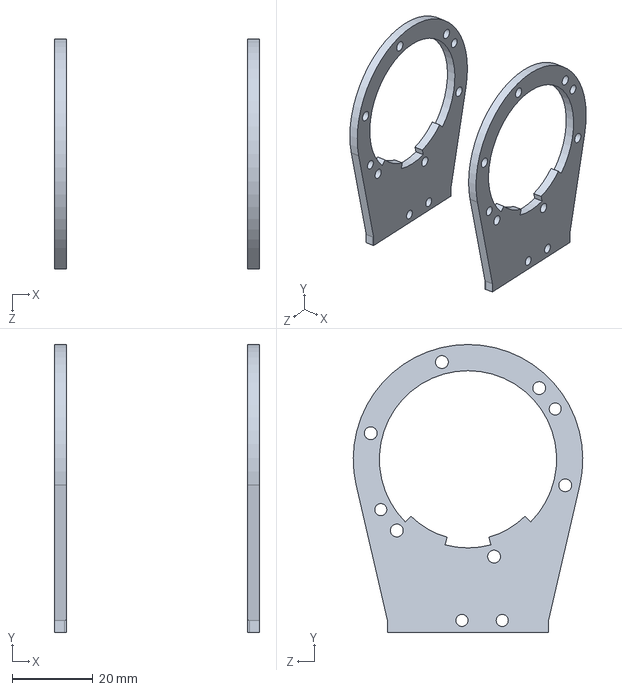
[picture p47: CAD file, 2026-11-10]
资料文件/2组期中考核/工程机器人总装/大pitch底座电机固定板1.SLDPRT
51.0 x 71.5 x 57.0 mm
