leike70/RoboSister_Group2/资料文件/2组期中考核/炮塔机器人总装/摩擦轮.SLDPRT

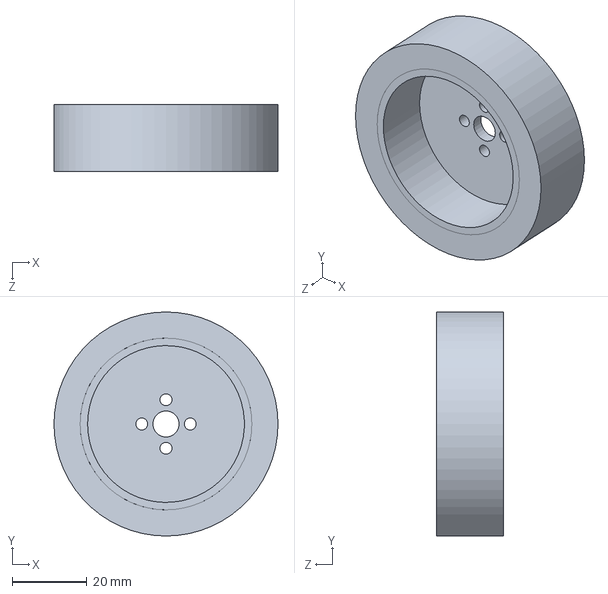
[picture p48: CAD file, 2026-11-10]
资料文件/2组期中考核/炮塔机器人总装/摩擦轮.SLDPRT
60.0 x 60.0 x 18.0 mm
