leike70/RoboSister_Group2/资料文件/2组期中考核/工程机器人总装/TB47S电池模组prt.SLDPRT

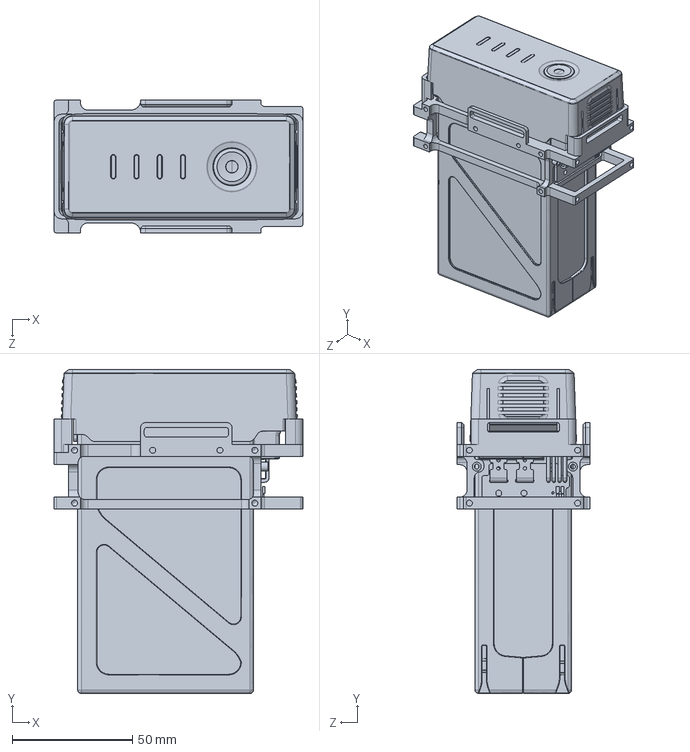
[picture p49: CAD file, 2026-11-10]
资料文件/2组期中考核/工程机器人总装/TB47S电池模组prt.SLDPRT
103.5 x 134.8 x 55.4 mm
