leike70/RoboSister_Group2/资料文件/2组期中考核/炮塔机器人总装/杯头螺栓M3-65.SLDPRT

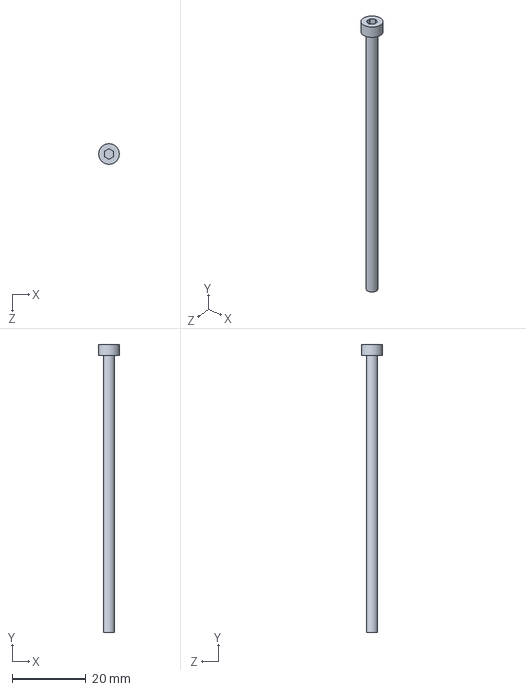
[picture p50: CAD file, 2026-11-10]
资料文件/2组期中考核/炮塔机器人总装/杯头螺栓M3-65.SLDPRT
5.60 x 78.0 x 5.60 mm
