leike70/RoboSister_Group2/资料文件/2组期中考核/工程机器人总装/台湾上银MGN7C线性滑轨.SLDPRT

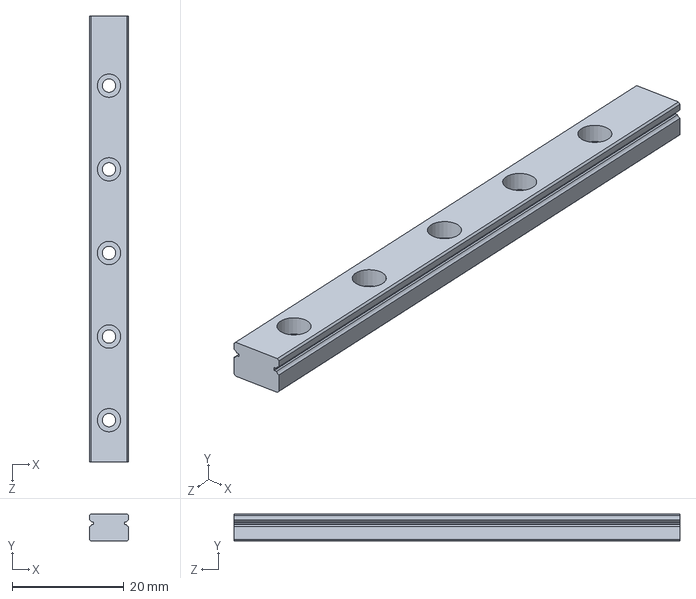
[picture p51: CAD file, 2026-11-10]
资料文件/2组期中考核/工程机器人总装/台湾上银MGN7C线性滑轨.SLDPRT
7.00 x 4.80 x 80.0 mm
