leike70/RoboSister_Group2/资料文件/2组期中考核/工程机器人总装/yaw电机固定板4310直驱版.SLDPRT

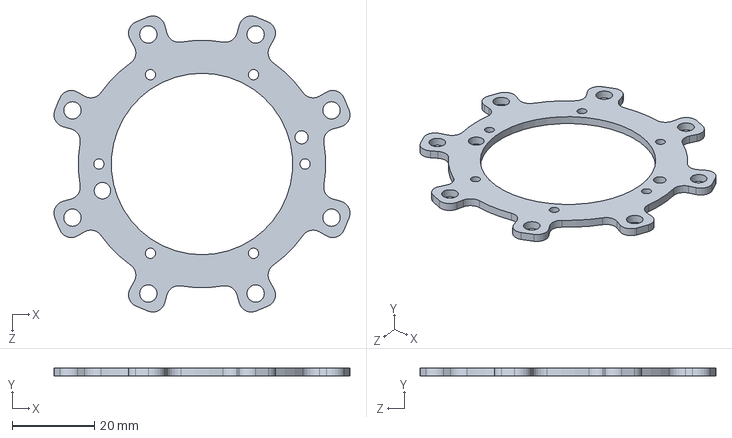
[picture p52: CAD file, 2026-11-10]
资料文件/2组期中考核/工程机器人总装/yaw电机固定板4310直驱版.SLDPRT
71.8 x 2.00 x 71.8 mm
