leike70/RoboSister_Group2/资料文件/2组期中考核/炮塔机器人总装/炮塔与底座过渡板.SLDPRT

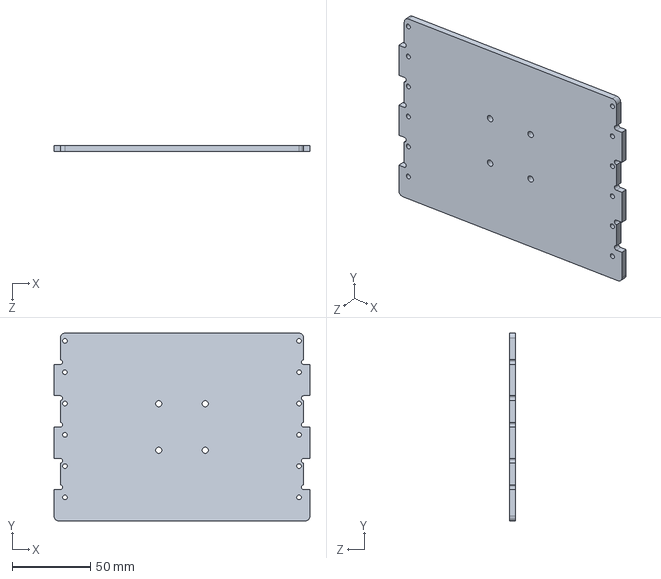
[picture p53: CAD file, 2026-11-10]
资料文件/2组期中考核/炮塔机器人总装/炮塔与底座过渡板.SLDPRT
163.6 x 120.0 x 4.00 mm
