leike70/RoboSister_Group2/资料文件/2组期中考核/工程机器人总装/主控支持打印件 小.SLDPRT

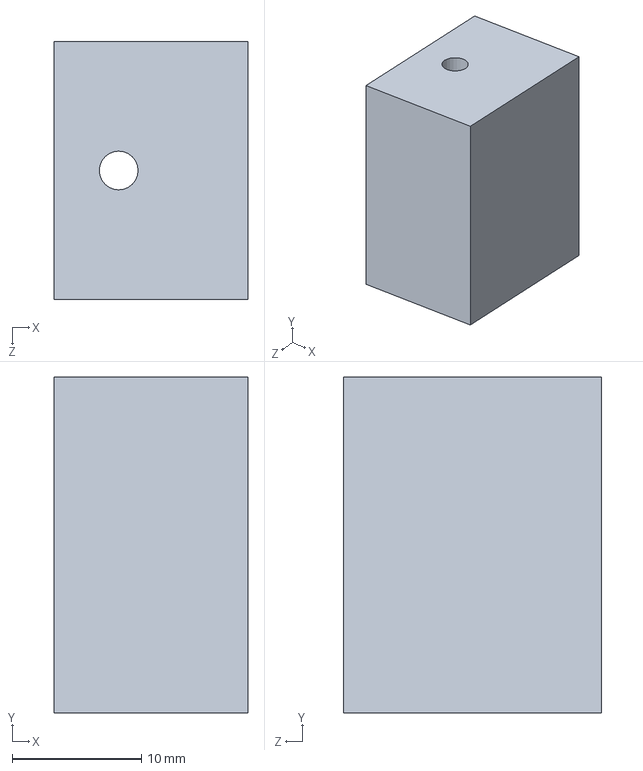
[picture p54: CAD file, 2026-11-10]
资料文件/2组期中考核/工程机器人总装/主控支持打印件 小.SLDPRT
15.0 x 26.0 x 20.0 mm
