leike70/RoboSister_Group2/资料文件/2组期中考核/炮塔机器人总装/辅助轮固定板.SLDPRT

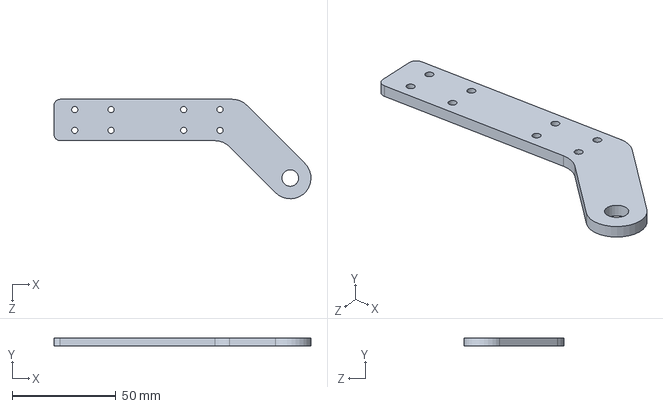
[picture p55: CAD file, 2026-11-10]
资料文件/2组期中考核/炮塔机器人总装/辅助轮固定板.SLDPRT
123.8 x 4.00 x 48.0 mm
