leike70/RoboSister_Group2/资料文件/2组期中考核/工程机器人总装/爪部电机固定件.SLDPRT

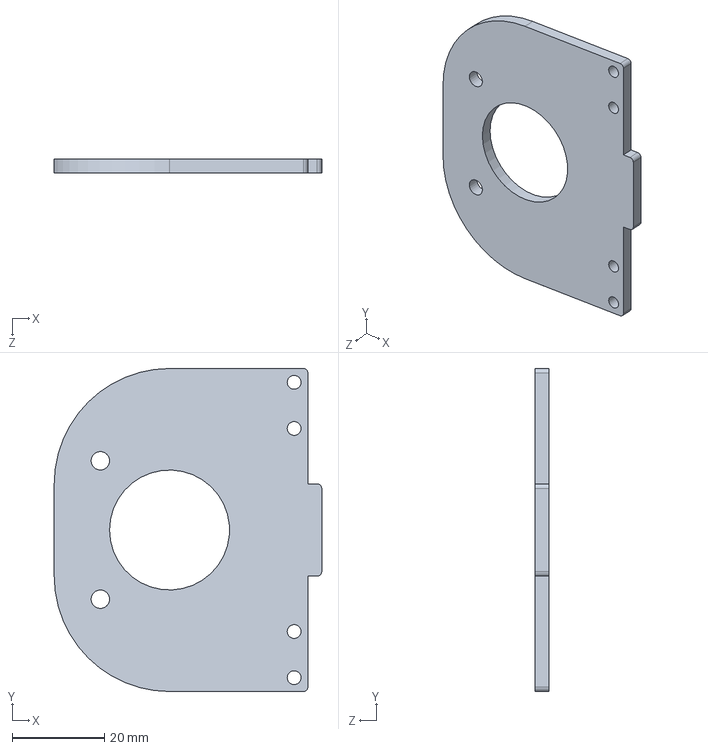
[picture p56: CAD file, 2026-11-10]
资料文件/2组期中考核/工程机器人总装/爪部电机固定件.SLDPRT
58.0 x 70.0 x 3.00 mm
