leike70/RoboSister_Group2/资料文件/2组期中考核/工程机器人总装/roll传动杆1.SLDPRT

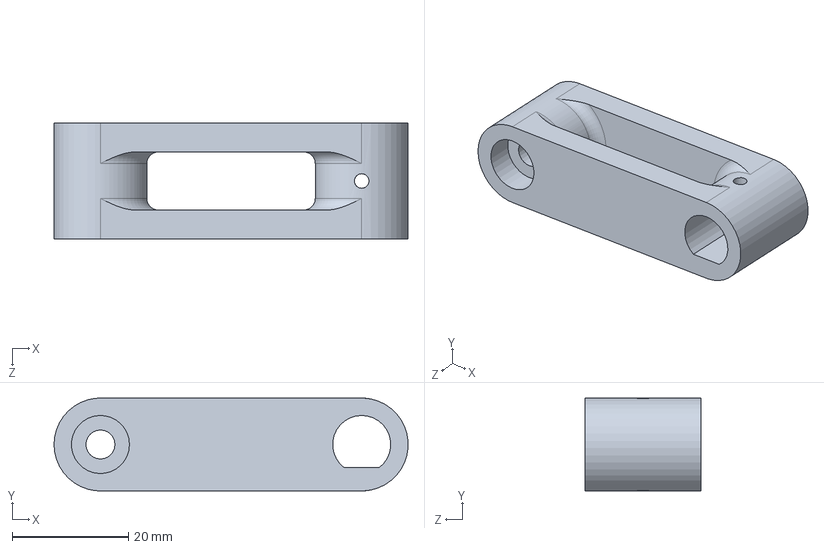
[picture p57: CAD file, 2026-11-10]
资料文件/2组期中考核/工程机器人总装/roll传动杆1.SLDPRT
61.0 x 16.0 x 20.0 mm
