leike70/RoboSister_Group2/资料文件/2组期中考核/炮塔机器人总装/yaw轴深沟球轴承.SLDPRT

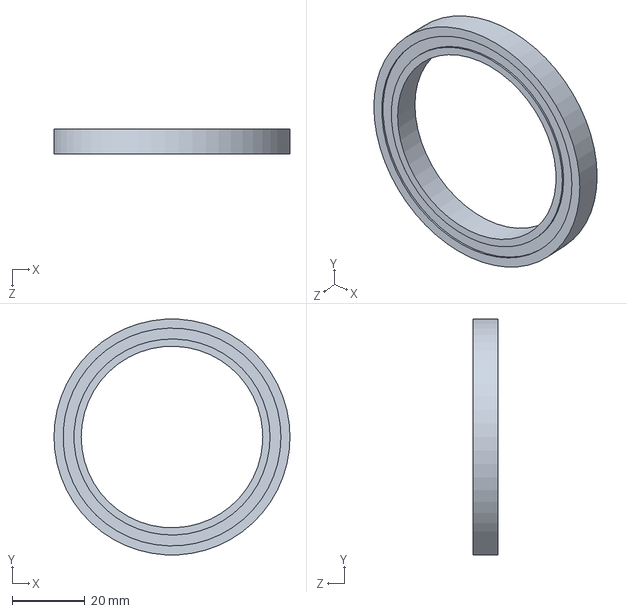
[picture p58: CAD file, 2026-11-10]
资料文件/2组期中考核/炮塔机器人总装/yaw轴深沟球轴承.SLDPRT
65.0 x 64.9 x 7.00 mm
