leike70/RoboSister_Group2/资料文件/2组期中考核/工程机器人总装/胀紧套Z21.SLDPRT

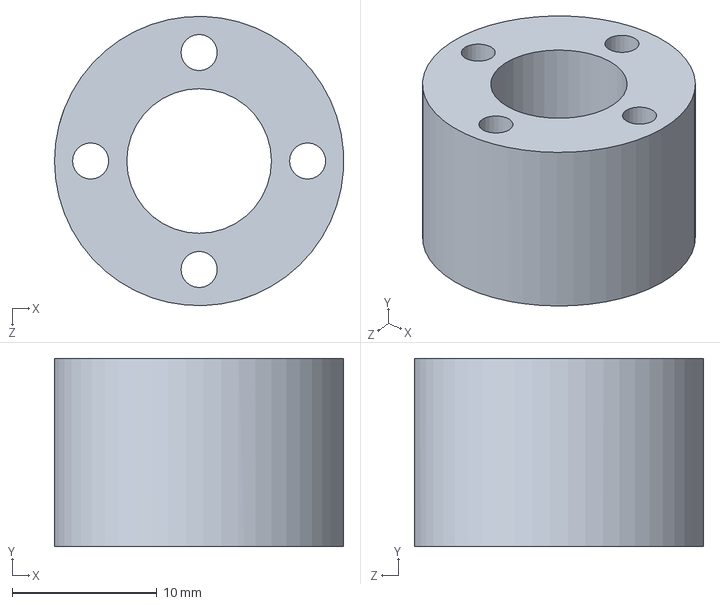
[picture p59: CAD file, 2026-11-10]
资料文件/2组期中考核/工程机器人总装/胀紧套Z21.SLDPRT
20.0 x 13.0 x 20.0 mm
