leike70/RoboSister_Group2/资料文件/2组期中考核/炮塔机器人总装/方铝-滑块固定.SLDPRT

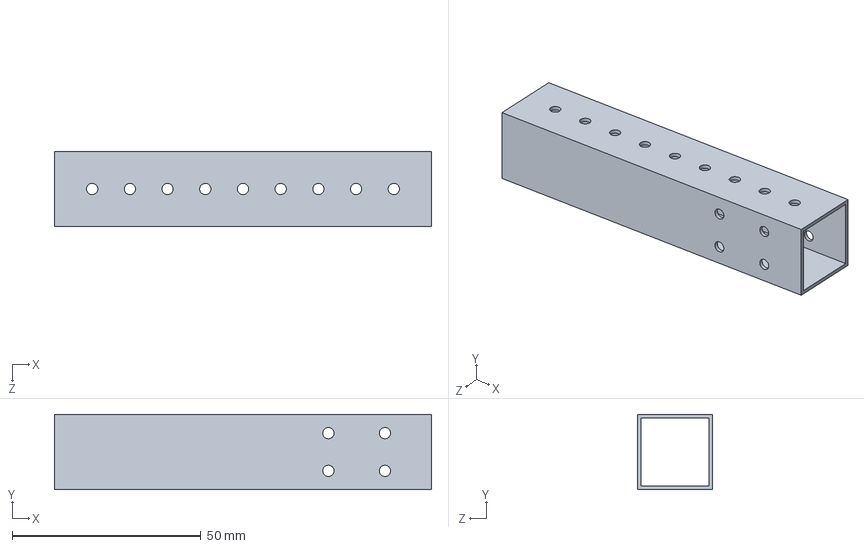
[picture p60: CAD file, 2026-11-10]
资料文件/2组期中考核/炮塔机器人总装/方铝-滑块固定.SLDPRT
100.0 x 20.0 x 20.0 mm
