leike70/RoboSister_Group2/资料文件/2组期中考核/炮塔机器人总装/上板.SLDPRT

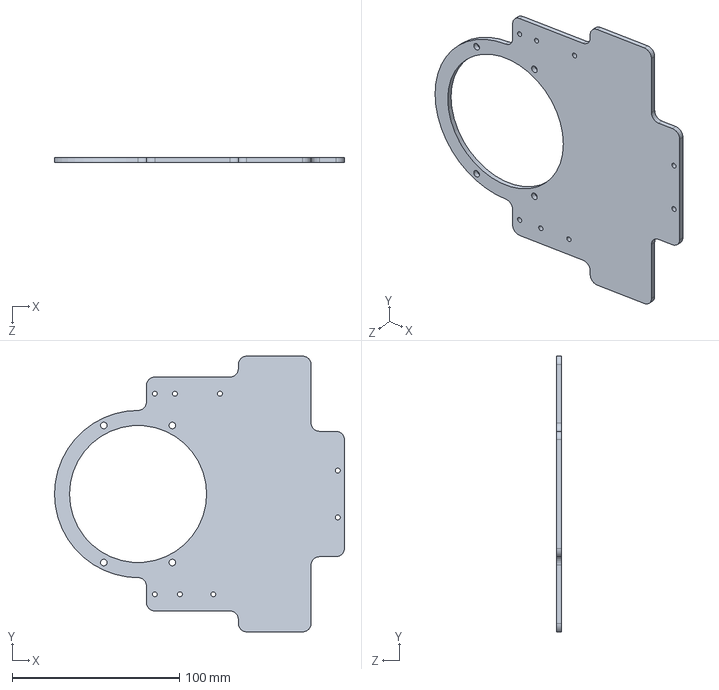
[picture p61: CAD file, 2026-11-10]
资料文件/2组期中考核/炮塔机器人总装/上板.SLDPRT
173.5 x 165.0 x 3.00 mm
