leike70/RoboSister_Group2/资料文件/2组期中考核/工程机器人总装/DM-J4310-2EC.SLDPRT

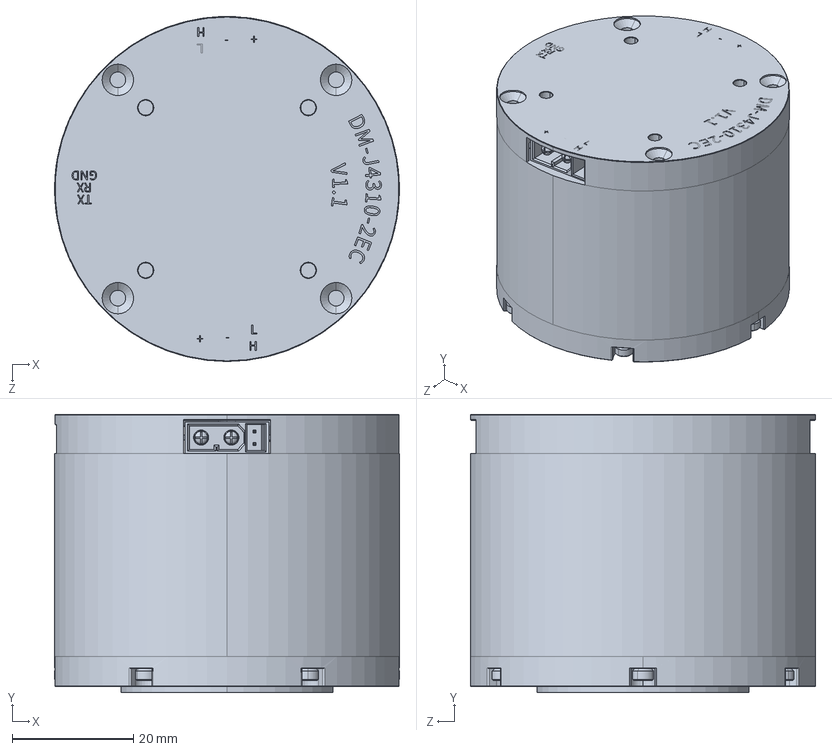
[picture p62: CAD file, 2026-11-10]
资料文件/2组期中考核/工程机器人总装/DM-J4310-2EC.SLDPRT
57.0 x 46.0 x 57.0 mm
