leike70/RoboSister_Group2/资料文件/2组期中考核/炮塔机器人总装/传送.SLDPRT

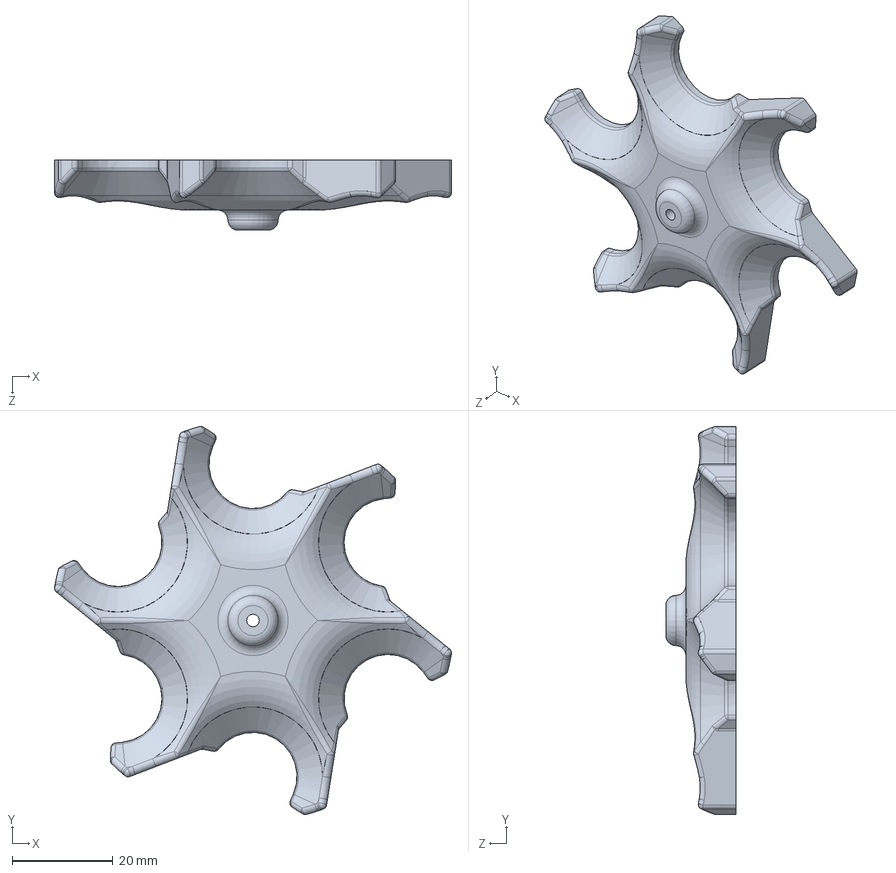
[picture p63: CAD file, 2026-11-10]
资料文件/2组期中考核/炮塔机器人总装/传送.SLDPRT
78.9 x 77.2 x 14.0 mm
