leike70/RoboSister_Group2/资料文件/2组期中考核/炮塔机器人总装/GB-平垫圈-SJTU.SLDPRT

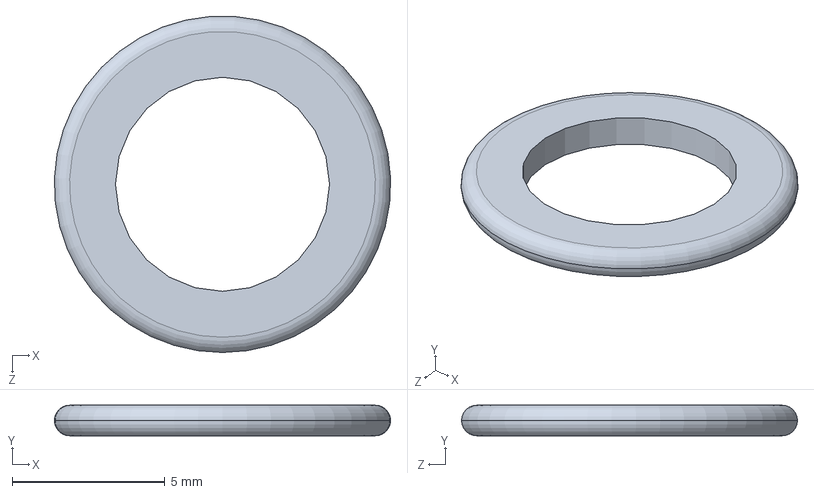
[picture p64: CAD file, 2026-11-10]
资料文件/2组期中考核/炮塔机器人总装/GB-平垫圈-SJTU.SLDPRT
11.0 x 1.00 x 11.0 mm
