leike70/RoboSister_Group2/资料文件/2组期中考核/工程机器人总装/圆柱齿轮25×1.5.SLDPRT

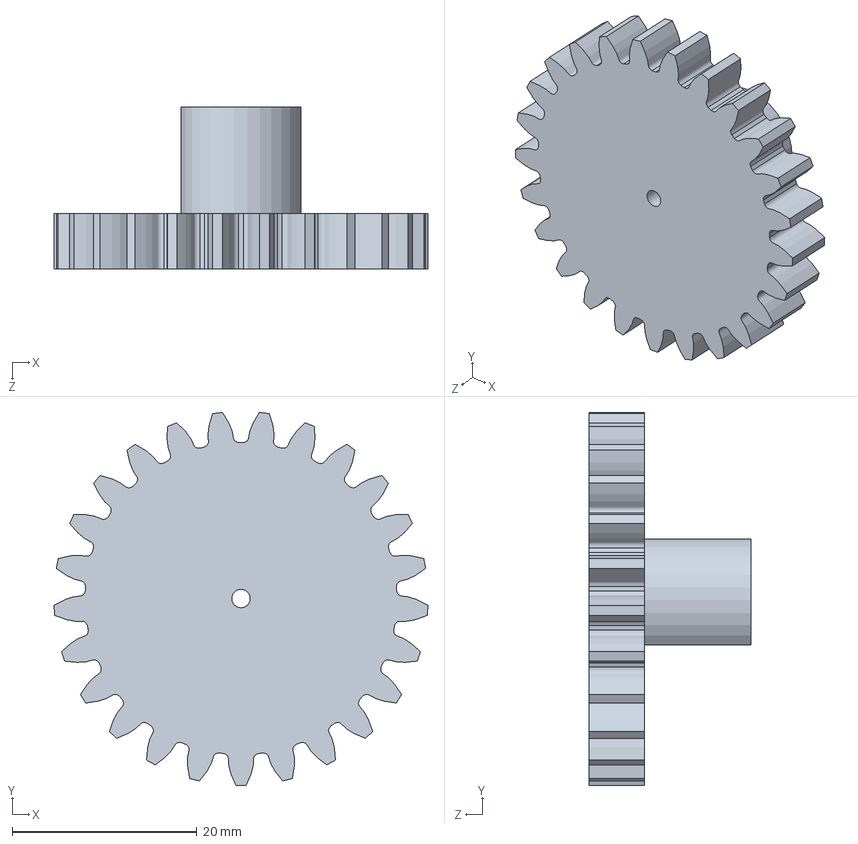
[picture p65: CAD file, 2026-11-10]
资料文件/2组期中考核/工程机器人总装/圆柱齿轮25×1.5.SLDPRT
40.5 x 40.4 x 17.5 mm
