leike70/RoboSister_Group2/资料文件/2组期中考核/炮塔机器人总装/履带方铝2.SLDPRT

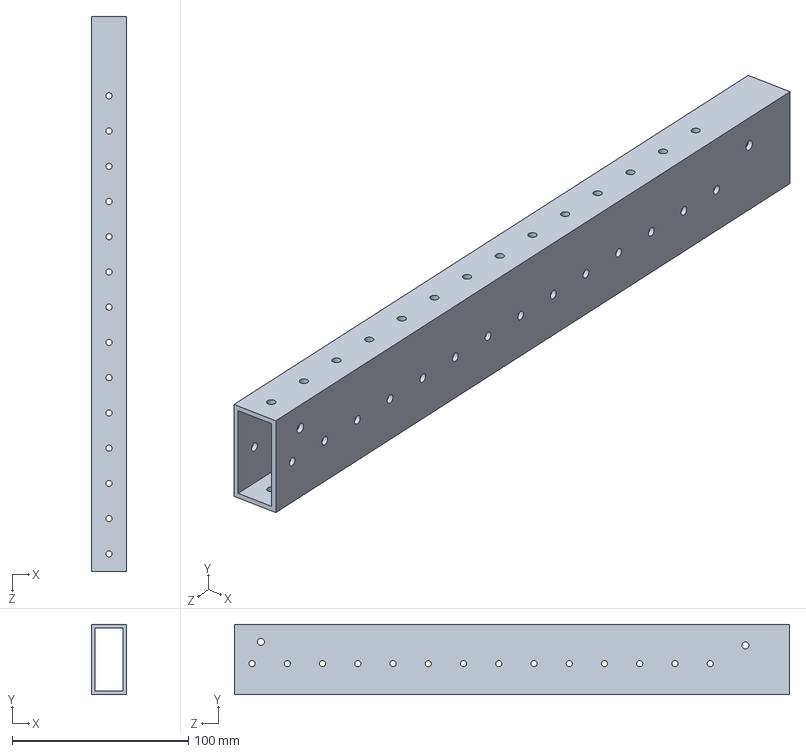
[picture p66: CAD file, 2026-11-10]
资料文件/2组期中考核/炮塔机器人总装/履带方铝2.SLDPRT
20.0 x 40.0 x 315.0 mm
