leike70/RoboSister_Group2/资料文件/2组期中考核/工程机器人总装/履带地轮.SLDPRT

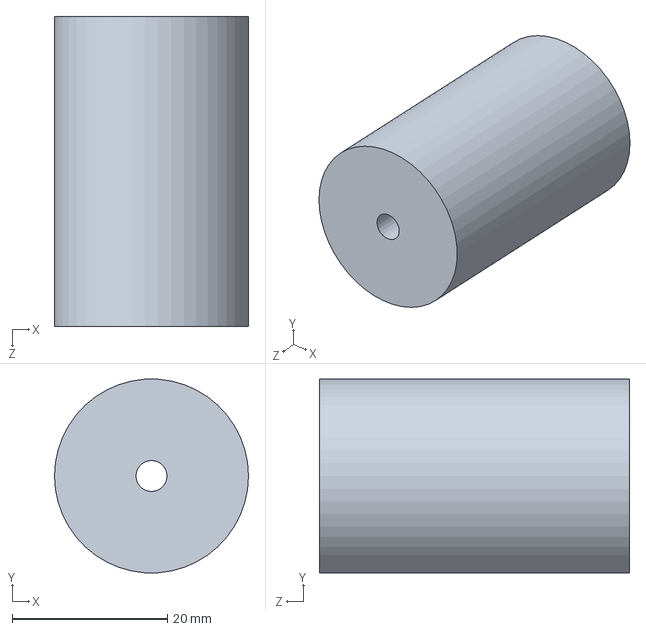
[picture p67: CAD file, 2026-11-10]
资料文件/2组期中考核/工程机器人总装/履带地轮.SLDPRT
25.0 x 24.9 x 40.0 mm
