leike70/RoboSister_Group2/资料文件/2组期中考核/工程机器人总装/铝排2.SLDPRT

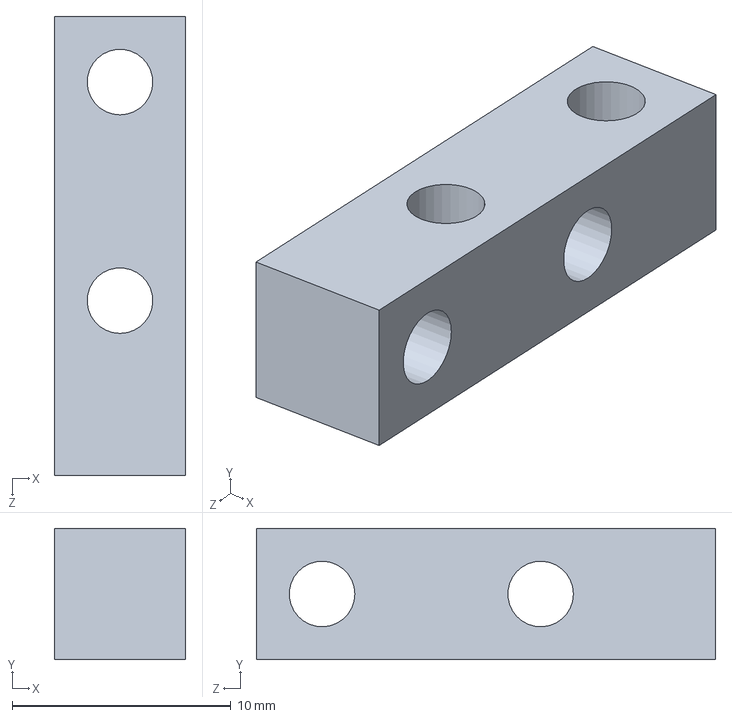
[picture p68: CAD file, 2026-11-10]
资料文件/2组期中考核/工程机器人总装/铝排2.SLDPRT
6.00 x 6.00 x 21.0 mm
