leike70/RoboSister_Group2/资料文件/2组期中考核/炮塔机器人总装/主控底板.SLDPRT

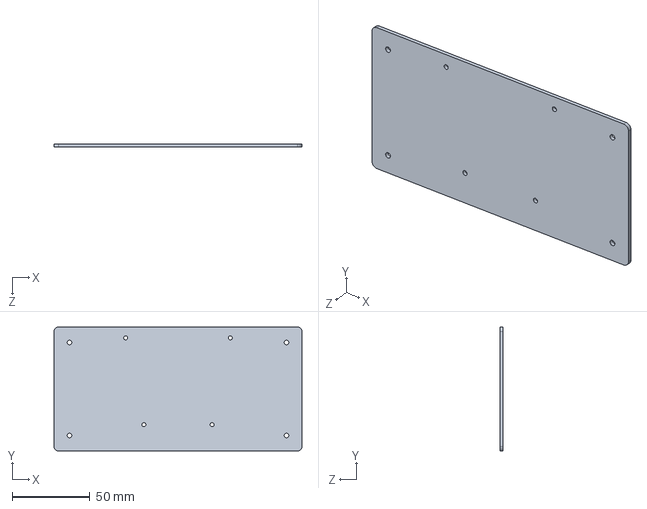
[picture p69: CAD file, 2026-11-10]
资料文件/2组期中考核/炮塔机器人总装/主控底板.SLDPRT
160.0 x 80.0 x 2.00 mm
