leike70/RoboSister_Group2/资料文件/2组期中考核/炮塔机器人总装/同步带同步轮-电机盖片.SLDPRT

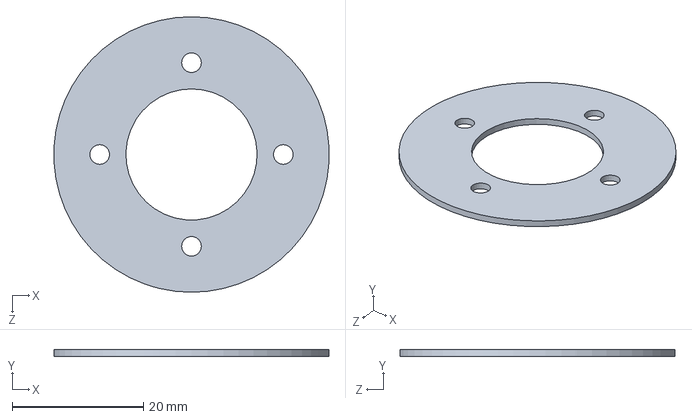
[picture p70: CAD file, 2026-11-10]
资料文件/2组期中考核/炮塔机器人总装/同步带同步轮-电机盖片.SLDPRT
41.9 x 1.00 x 42.0 mm
