leike70/RoboSister_Group2/资料文件/2组期中考核/炮塔机器人总装/yaw轴过渡板.SLDPRT

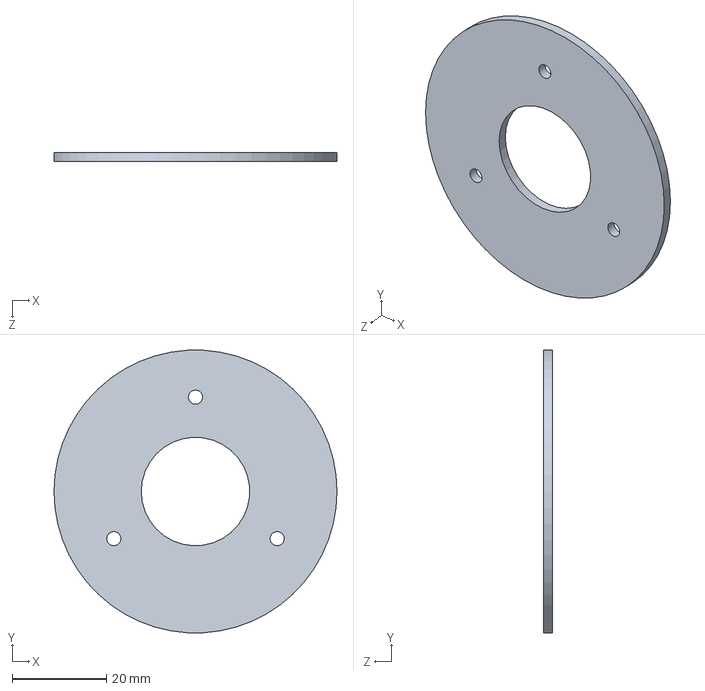
[picture p71: CAD file, 2026-11-10]
资料文件/2组期中考核/炮塔机器人总装/yaw轴过渡板.SLDPRT
60.0 x 59.9 x 2.00 mm
