leike70/RoboSister_Group2/资料文件/2组期中考核/工程机器人总装/六角铜柱M5-60.SLDPRT

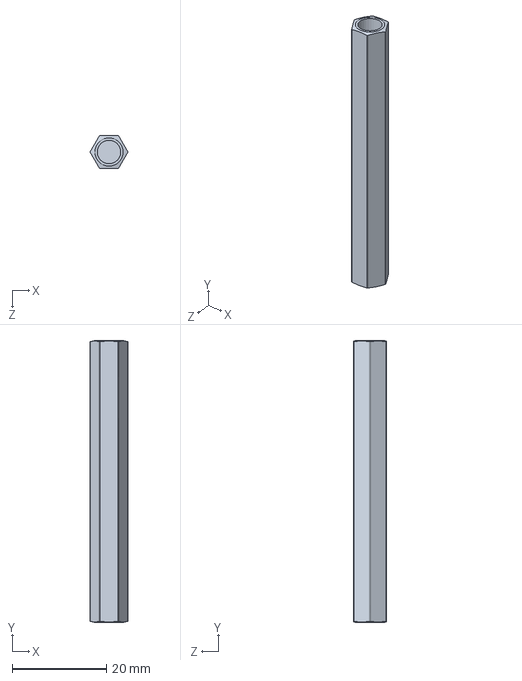
[picture p72: CAD file, 2026-11-10]
资料文件/2组期中考核/工程机器人总装/六角铜柱M5-60.SLDPRT
8.02 x 60.0 x 7.00 mm
