leike70/RoboSister_Group2/资料文件/2组期中考核/炮塔机器人总装/台湾上银MGN9C线性滑轨.SLDPRT

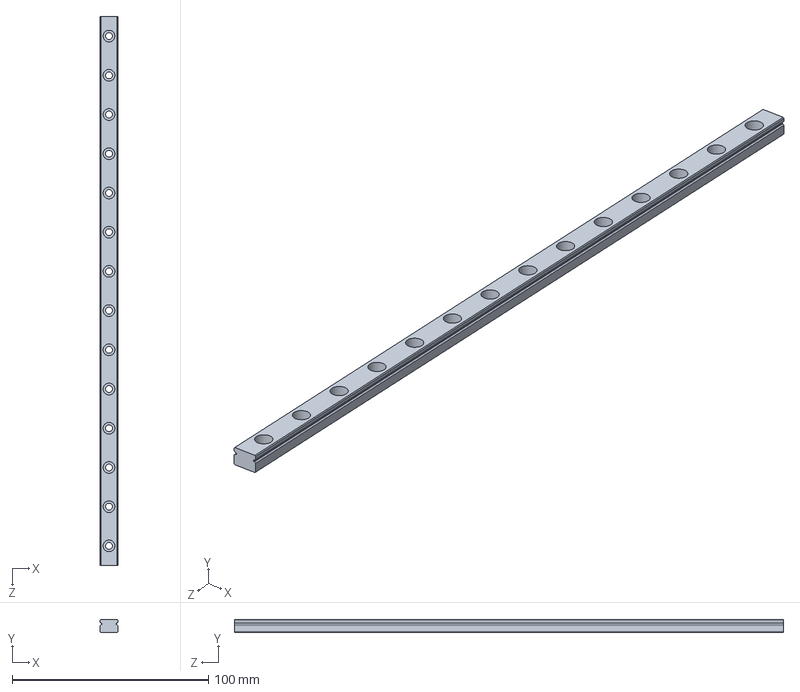
[picture p73: CAD file, 2026-11-10]
资料文件/2组期中考核/炮塔机器人总装/台湾上银MGN9C线性滑轨.SLDPRT
9.00 x 6.50 x 280.0 mm
