leike70/RoboSister_Group2/资料文件/2组期中考核/炮塔机器人总装/pitch轴电机固定板.SLDPRT

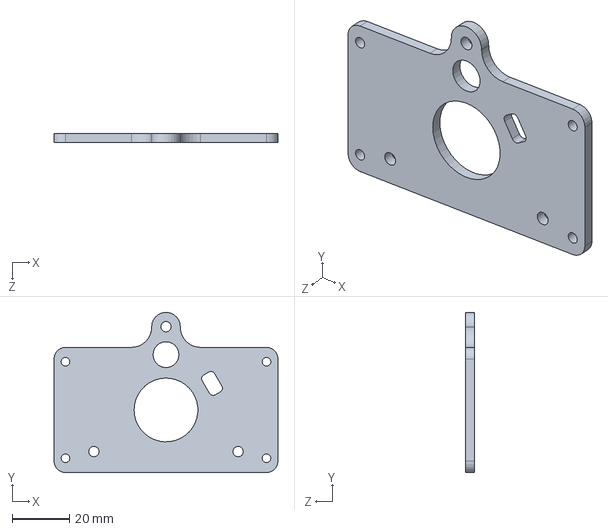
[picture p74: CAD file, 2026-11-10]
资料文件/2组期中考核/炮塔机器人总装/pitch轴电机固定板.SLDPRT
78.0 x 55.8 x 3.00 mm
