leike70/RoboSister_Group2/资料文件/2组期中考核/工程机器人总装/机械臂连接处轴承内圈下.SLDPRT

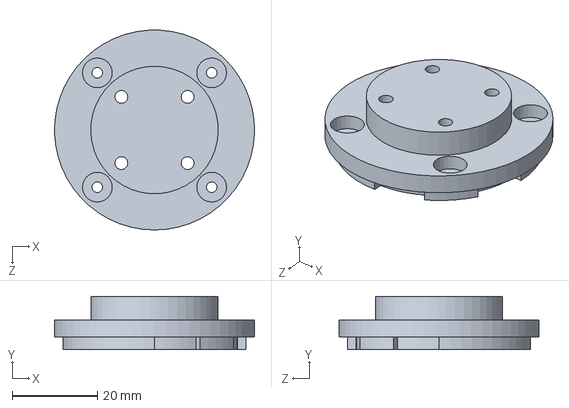
[picture p75: CAD file, 2026-11-10]
资料文件/2组期中考核/工程机器人总装/机械臂连接处轴承内圈下.SLDPRT
47.0 x 12.5 x 47.0 mm
