leike70/RoboSister_Group2/资料文件/2组期中考核/炮塔机器人总装/发射器.SLDPRT

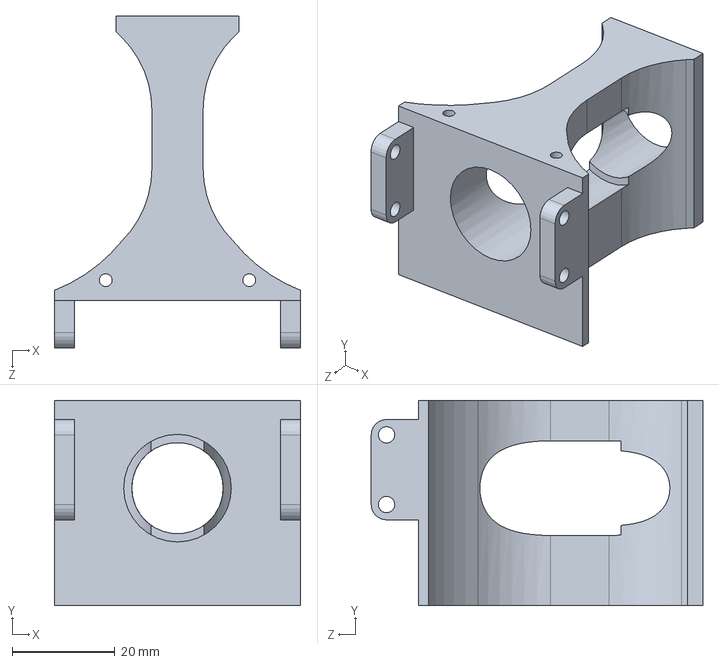
[picture p76: CAD file, 2026-11-10]
资料文件/2组期中考核/炮塔机器人总装/发射器.SLDPRT
48.0 x 40.0 x 64.7 mm
