leike70/RoboSister_Group2/资料文件/2组期中考核/炮塔机器人总装/天轮电机支撑板_A.SLDPRT

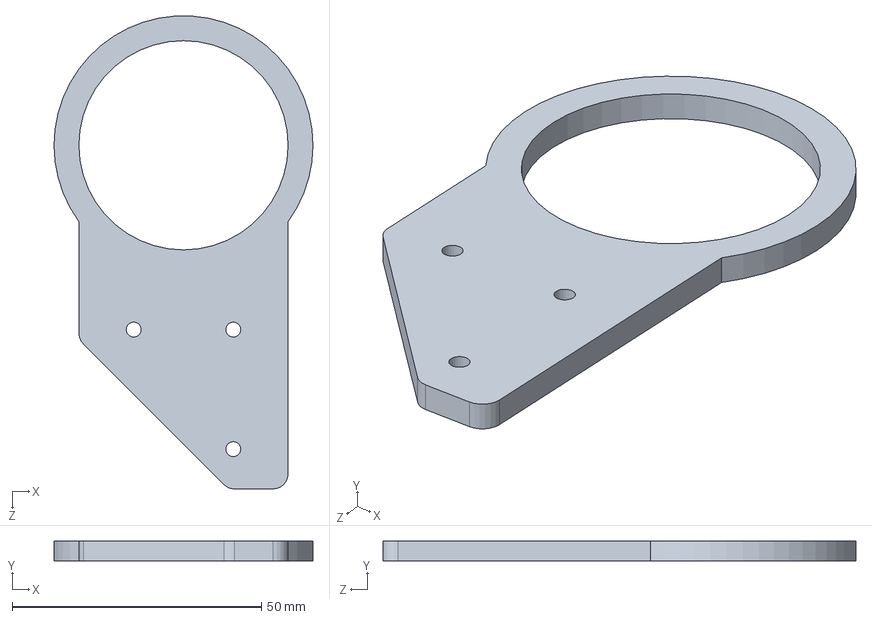
[picture p77: CAD file, 2026-11-10]
资料文件/2组期中考核/炮塔机器人总装/天轮电机支撑板_A.SLDPRT
52.0 x 4.00 x 94.9 mm
