leike70/RoboSister_Group2/资料文件/2组期中考核/工程机器人总装/小pitch连接件1.SLDPRT

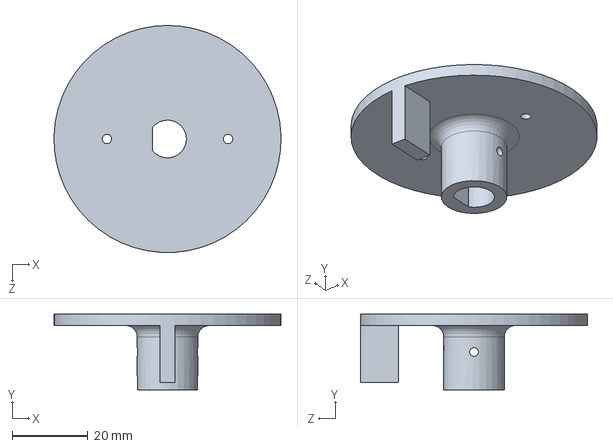
[picture p78: CAD file, 2026-11-10]
资料文件/2组期中考核/工程机器人总装/小pitch连接件1.SLDPRT
60.0 x 20.0 x 60.0 mm
