leike70/RoboSister_Group2/资料文件/2组期中考核/炮塔机器人总装/GB-杯头塞打螺栓-SJTU.SLDPRT

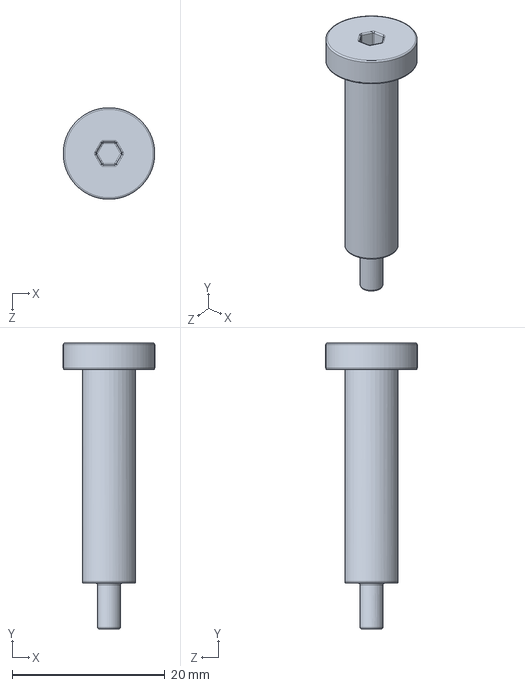
[picture p79: CAD file, 2026-11-10]
资料文件/2组期中考核/炮塔机器人总装/GB-杯头塞打螺栓-SJTU.SLDPRT
12.0 x 37.5 x 12.0 mm
