leike70/RoboSister_Group2/资料文件/2组期中考核/工程机器人总装/GB-六角铜柱-双内螺纹-SJTU.SLDPRT

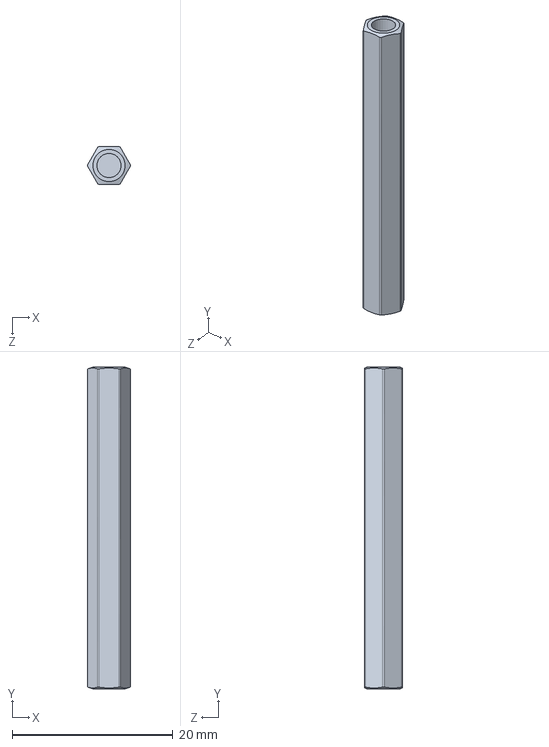
[picture p80: CAD file, 2026-11-10]
资料文件/2组期中考核/工程机器人总装/GB-六角铜柱-双内螺纹-SJTU.SLDPRT
5.37 x 40.0 x 4.70 mm
