leike70/RoboSister_Group2/资料文件/2组期中考核/炮塔机器人总装/天轮支撑板.SLDPRT

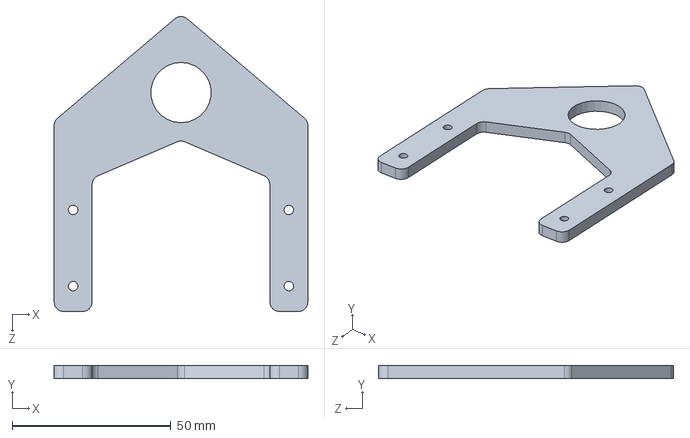
[picture p81: CAD file, 2026-11-10]
资料文件/2组期中考核/炮塔机器人总装/天轮支撑板.SLDPRT
80.0 x 4.00 x 93.0 mm
