leike70/RoboSister_Group2/资料文件/2组期中考核/工程机器人总装/RM2019裁判系统主控模块MC02.SLDPRT

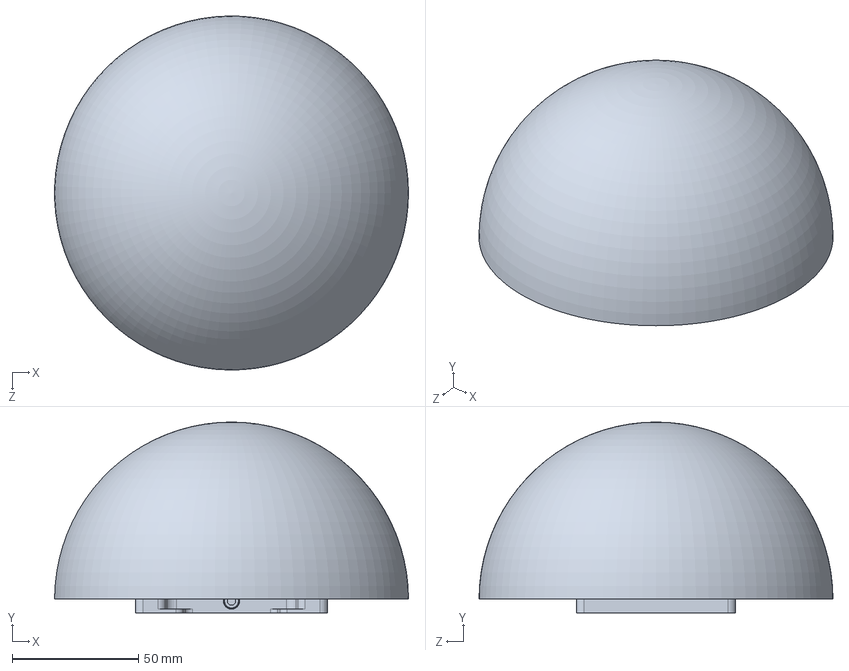
[picture p82: CAD file, 2026-11-10]
资料文件/2组期中考核/工程机器人总装/RM2019裁判系统主控模块MC02.SLDPRT
140.0 x 75.5 x 140.0 mm
