leike70/RoboSister_Group2/资料文件/2组期中考核/炮塔机器人总装/yaw轴轴承底座.SLDPRT

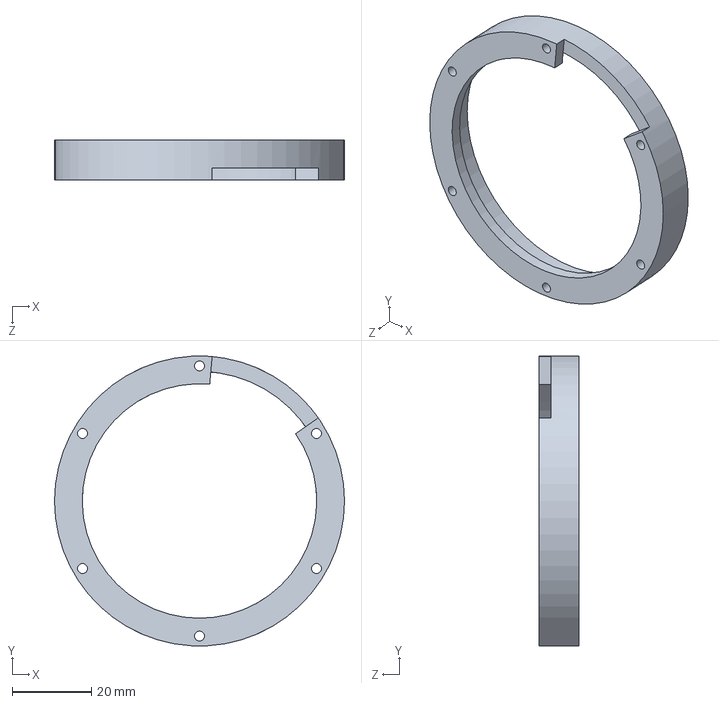
[picture p83: CAD file, 2026-11-10]
资料文件/2组期中考核/炮塔机器人总装/yaw轴轴承底座.SLDPRT
73.0 x 72.9 x 10.0 mm
