leike70/RoboSister_Group2/资料文件/2组期中考核/工程机器人总装/加长爪1.SLDPRT

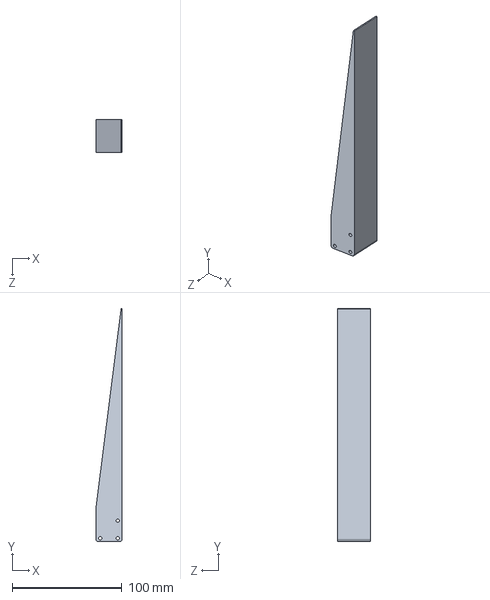
[picture p84: CAD file, 2026-11-10]
资料文件/2组期中考核/工程机器人总装/加长爪1.SLDPRT
24.0 x 212.6 x 30.0 mm
