leike70/RoboSister_Group2/资料文件/2组期中考核/炮塔机器人总装/天轮打印3号.SLDPRT

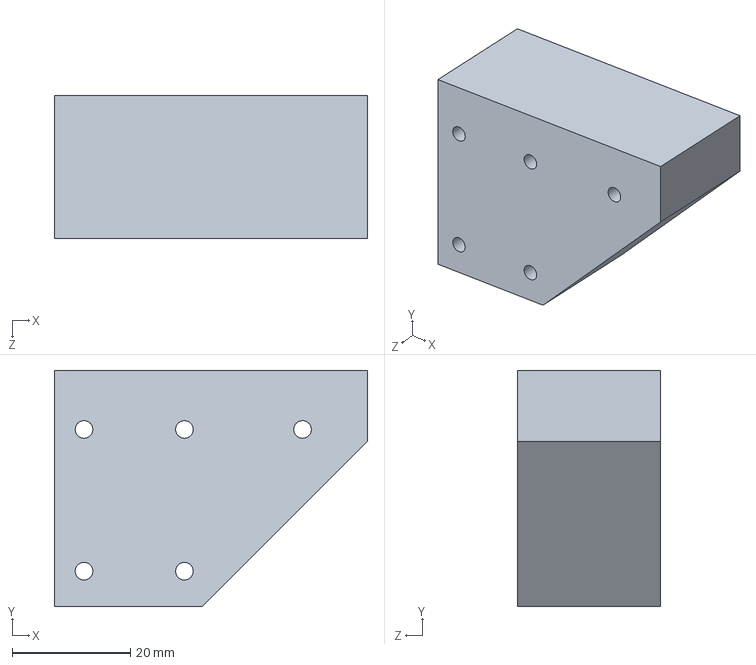
[picture p85: CAD file, 2026-11-10]
资料文件/2组期中考核/炮塔机器人总装/天轮打印3号.SLDPRT
53.0 x 40.0 x 24.2 mm
