leike70/RoboSister_Group2/资料文件/2组期中考核/工程机器人总装/roll固定板材1.SLDPRT

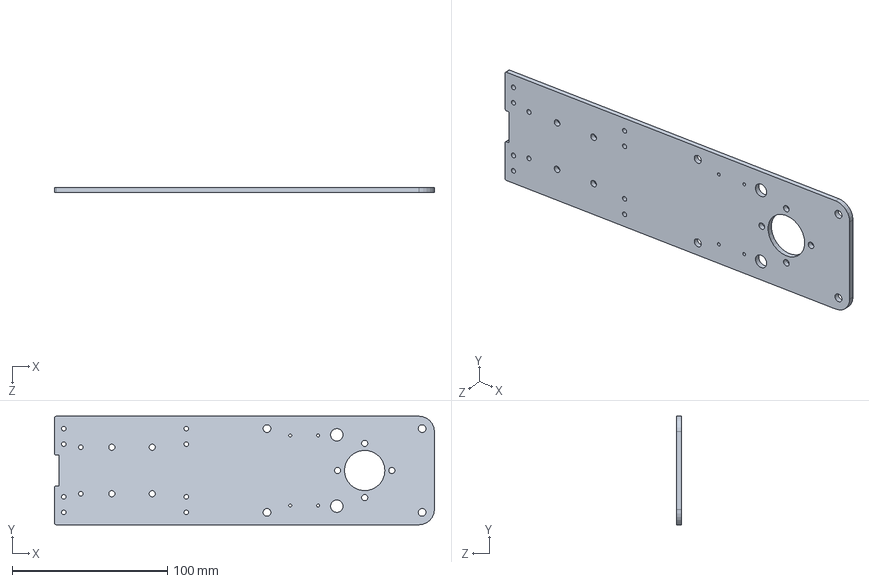
[picture p87: CAD file, 2026-11-10]
资料文件/2组期中考核/工程机器人总装/roll固定板材1.SLDPRT
245.0 x 70.0 x 3.00 mm
