leike70/RoboSister_Group2/资料文件/2组期中考核/炮塔机器人总装/弹仓.SLDPRT

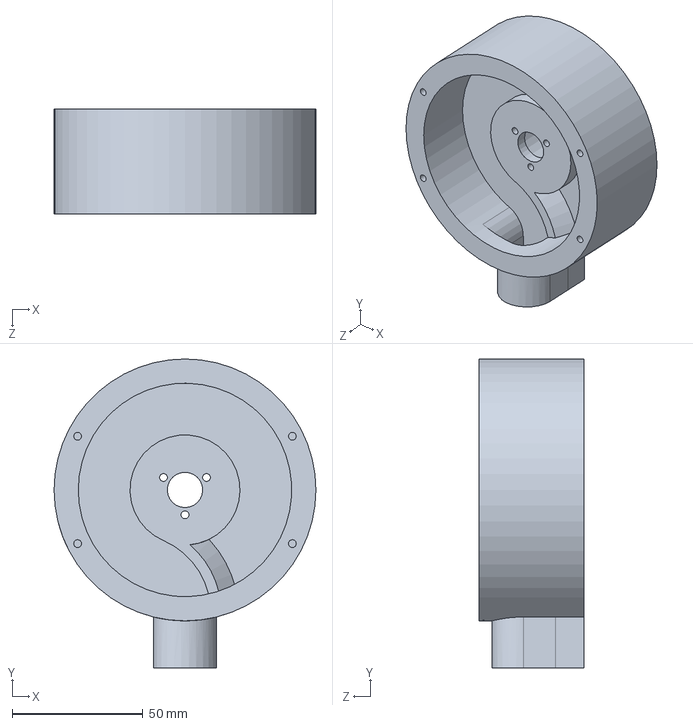
[picture p88: CAD file, 2026-11-10]
资料文件/2组期中考核/炮塔机器人总装/弹仓.SLDPRT
100.0 x 118.0 x 40.0 mm
