leike70/RoboSister_Group2/资料文件/2组期中考核/工程机器人总装/铝柱M5D10-60.SLDPRT

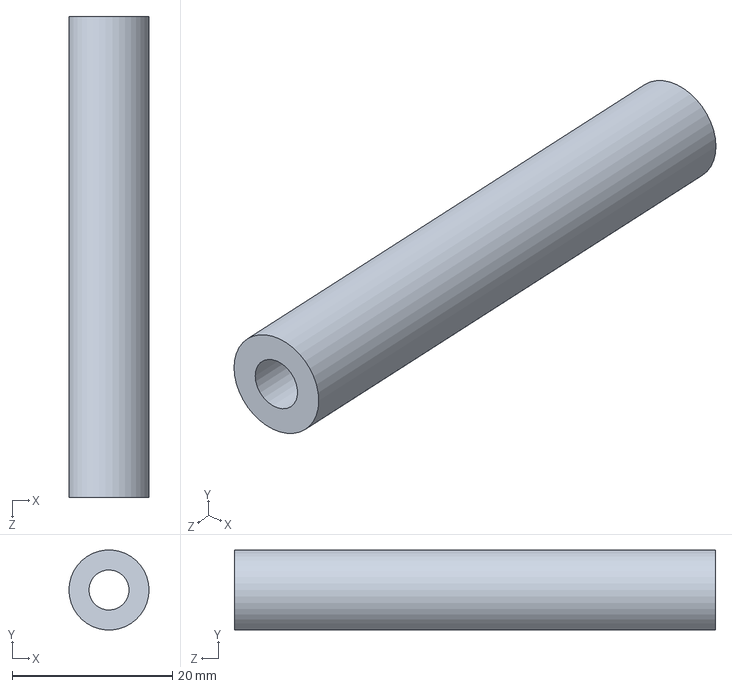
[picture p89: CAD file, 2026-11-10]
资料文件/2组期中考核/工程机器人总装/铝柱M5D10-60.SLDPRT
10.0 x 9.97 x 60.0 mm
