leike70/RoboSister_Group2/资料文件/2组期中考核/炮塔机器人总装/深沟球轴承10-19-7.SLDPRT

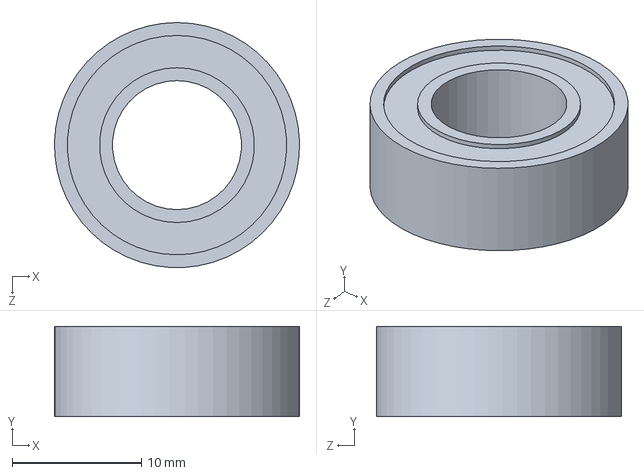
[picture p90: CAD file, 2026-11-10]
资料文件/2组期中考核/炮塔机器人总装/深沟球轴承10-19-7.SLDPRT
19.0 x 7.00 x 19.0 mm
