leike70/RoboSister_Group2/资料文件/2组期中考核/工程机器人总装/同步带履带同步轮组合-主动轮.SLDPRT

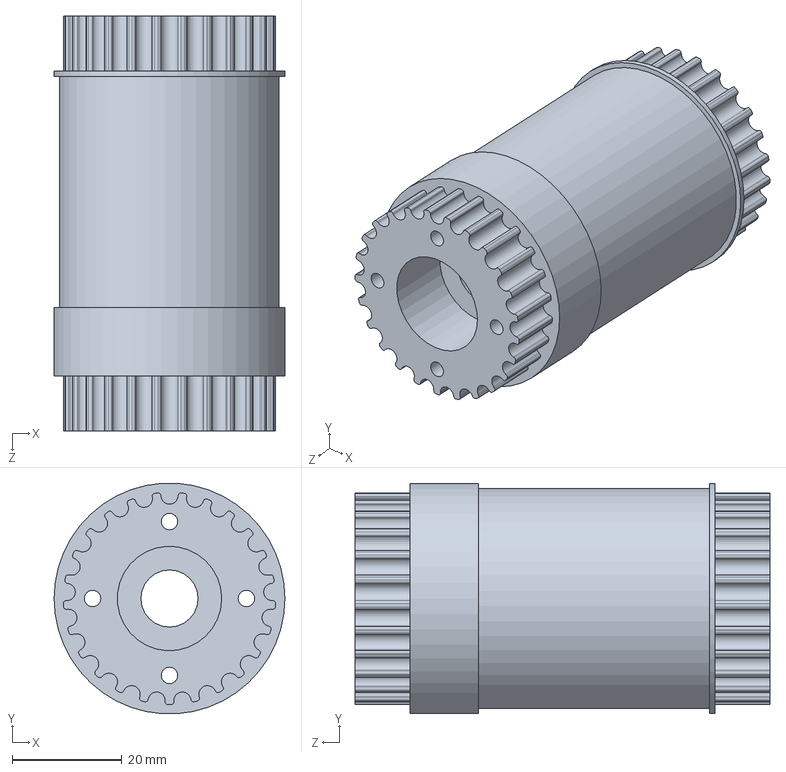
[picture p91: CAD file, 2026-11-10]
资料文件/2组期中考核/工程机器人总装/同步带履带同步轮组合-主动轮.SLDPRT
42.0 x 41.9 x 75.5 mm
