leike70/RoboSister_Group2/资料文件/2组期中考核/炮塔机器人总装/yaw轴尼龙尼龙垫柱.SLDPRT

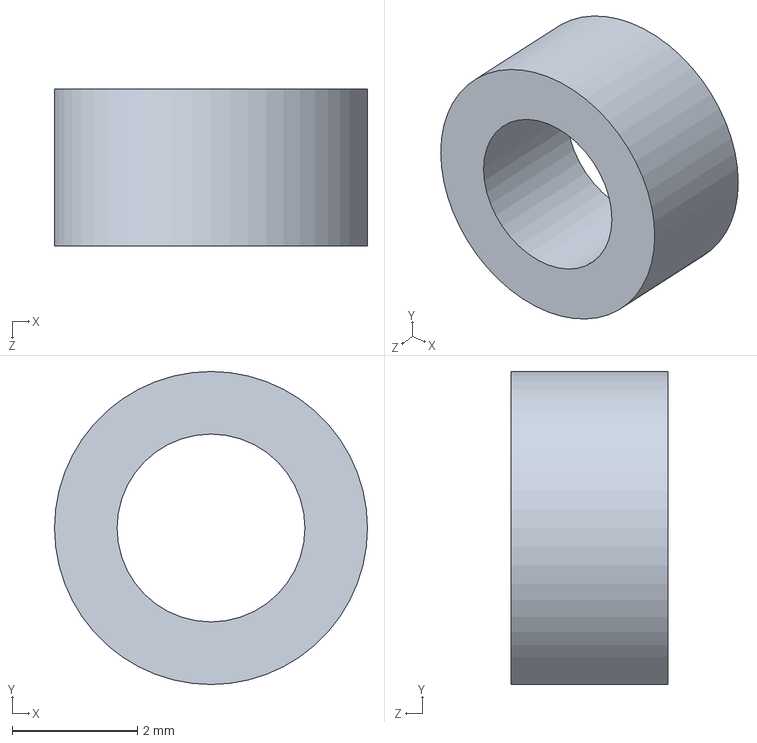
[picture p92: CAD file, 2026-11-10]
资料文件/2组期中考核/炮塔机器人总装/yaw轴尼龙尼龙垫柱.SLDPRT
5.00 x 5.00 x 2.50 mm
