leike70/RoboSister_Group2/资料文件/2组期中考核/炮塔机器人总装/装弹漏斗.SLDPRT

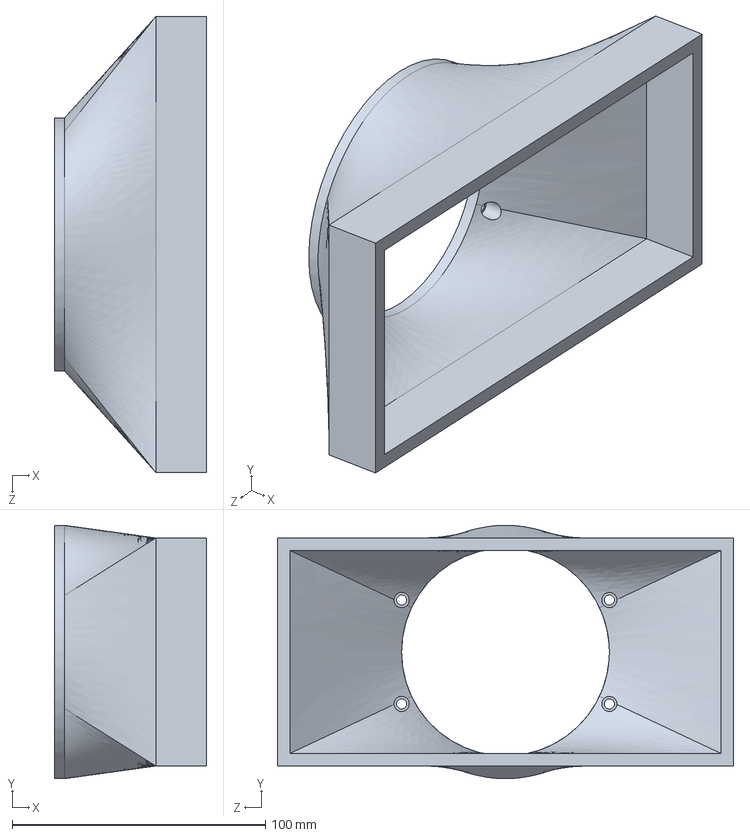
[picture p93: CAD file, 2026-11-10]
资料文件/2组期中考核/炮塔机器人总装/装弹漏斗.SLDPRT
60.0 x 100.0 x 180.0 mm
