leike70/RoboSister_Group2/资料文件/2组期中考核/工程机器人总装/尼龙垫柱10-16-4.SLDPRT

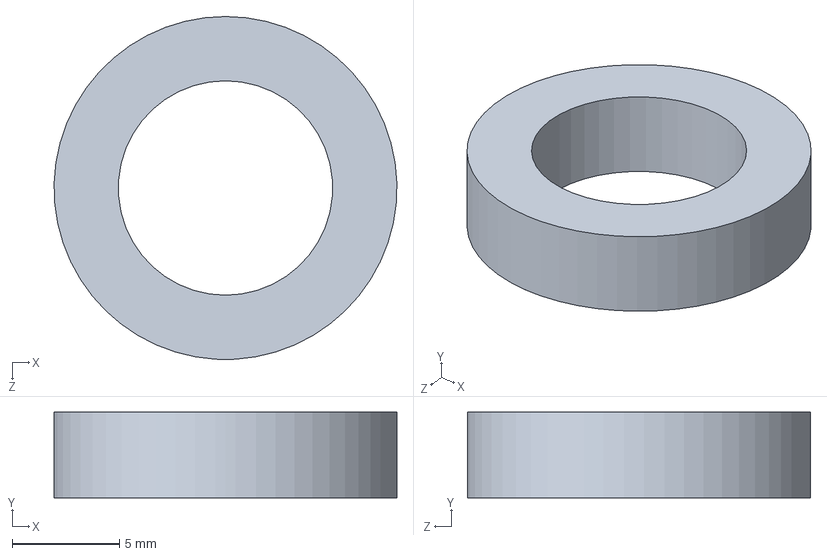
[picture p94: CAD file, 2026-11-10]
资料文件/2组期中考核/工程机器人总装/尼龙垫柱10-16-4.SLDPRT
16.0 x 4.00 x 16.0 mm
