leike70/RoboSister_Group2/资料文件/2组期中考核/工程机器人总装/铝排.SLDPRT

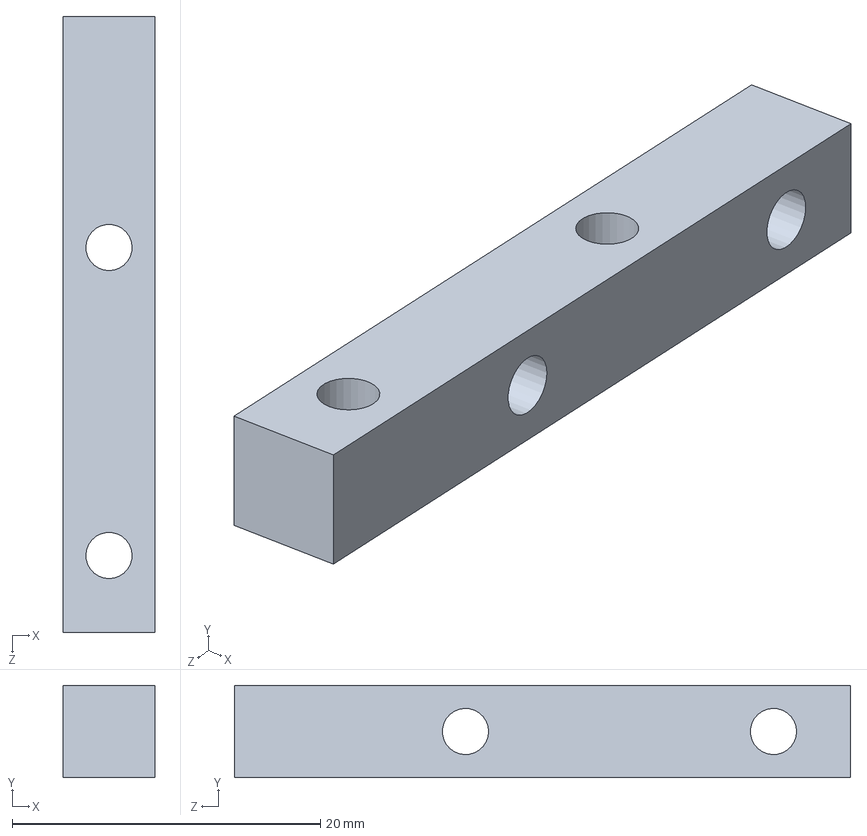
[picture p95: CAD file, 2026-11-10]
资料文件/2组期中考核/工程机器人总装/铝排.SLDPRT
6.00 x 6.00 x 40.0 mm
