leike70/RoboSister_Group2/资料文件/2组期中考核/工程机器人总装/深沟球轴承1.SLDPRT

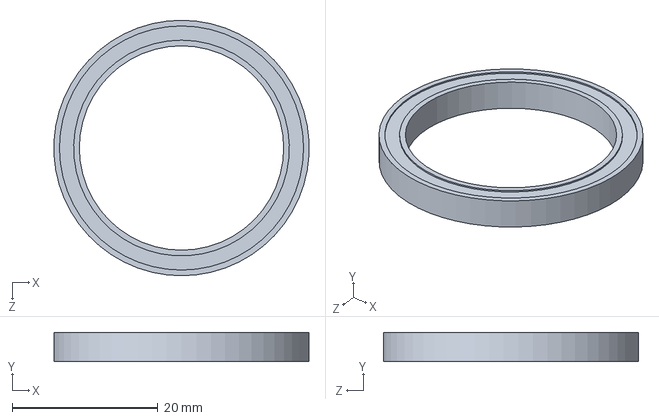
[picture p96: CAD file, 2026-11-10]
资料文件/2组期中考核/工程机器人总装/深沟球轴承1.SLDPRT
34.9 x 4.00 x 35.0 mm
