leike70/RoboSister_Group2/资料文件/2组期中考核/工程机器人总装/天轮打印4号.SLDPRT

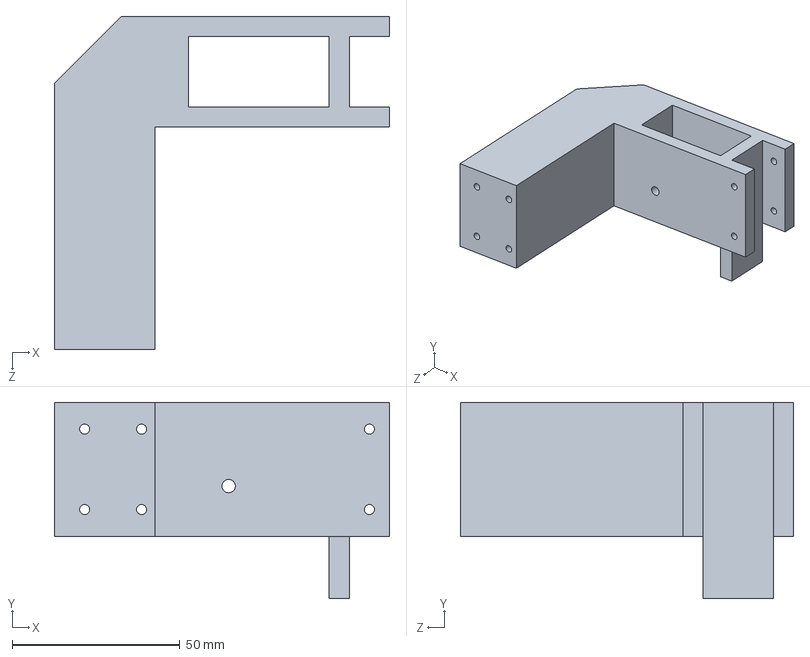
[picture p97: CAD file, 2026-11-10]
资料文件/2组期中考核/工程机器人总装/天轮打印4号.SLDPRT
100.0 x 58.6 x 99.5 mm
