leike70/RoboSister_Group2/资料文件/2组期中考核/炮塔机器人总装/履带支撑打印.SLDPRT

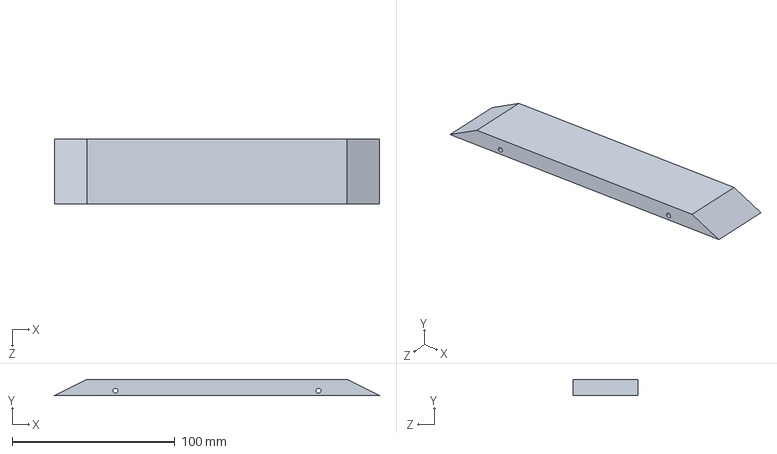
[picture p98: CAD file, 2026-11-10]
资料文件/2组期中考核/炮塔机器人总装/履带支撑打印.SLDPRT
200.0 x 10.0 x 40.0 mm
