leike70/RoboSister_Group2/资料文件/2组期中考核/工程机器人总装/GB-杯头螺栓-SJTU.SLDPRT

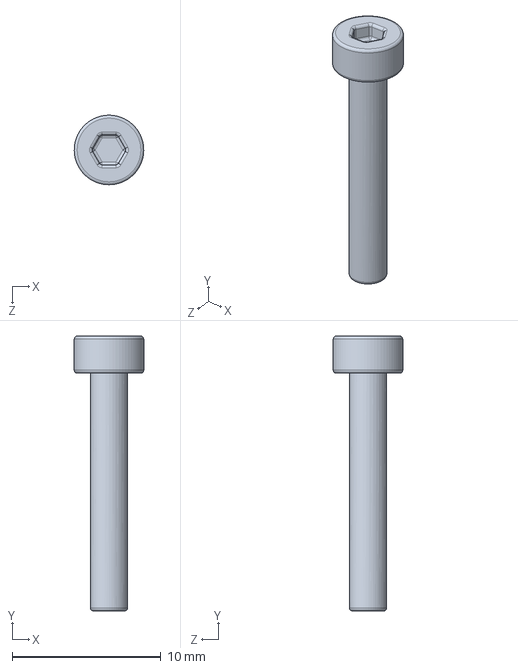
[picture p99: CAD file, 2026-11-10]
资料文件/2组期中考核/工程机器人总装/GB-杯头螺栓-SJTU.SLDPRT
4.68 x 18.5 x 4.68 mm
