leike70/RoboSister_Group2/资料文件/2组期中考核/炮塔机器人总装/M3508_WithGear(Simplified).SLDPRT

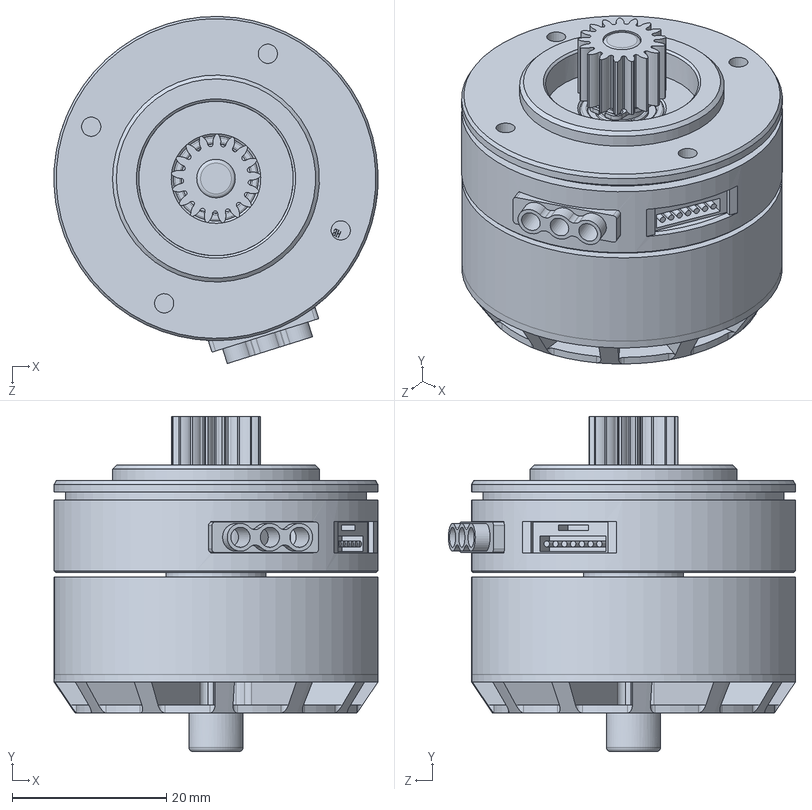
[picture p100: CAD file, 2026-11-10]
资料文件/2组期中考核/炮塔机器人总装/M3508_WithGear(Simplified).SLDPRT
42.0 x 43.4 x 45.0 mm
