leike70/RoboSister_Group2/资料文件/2组期中考核/工程机器人总装/齿轮-升降机齿轮.SLDPRT

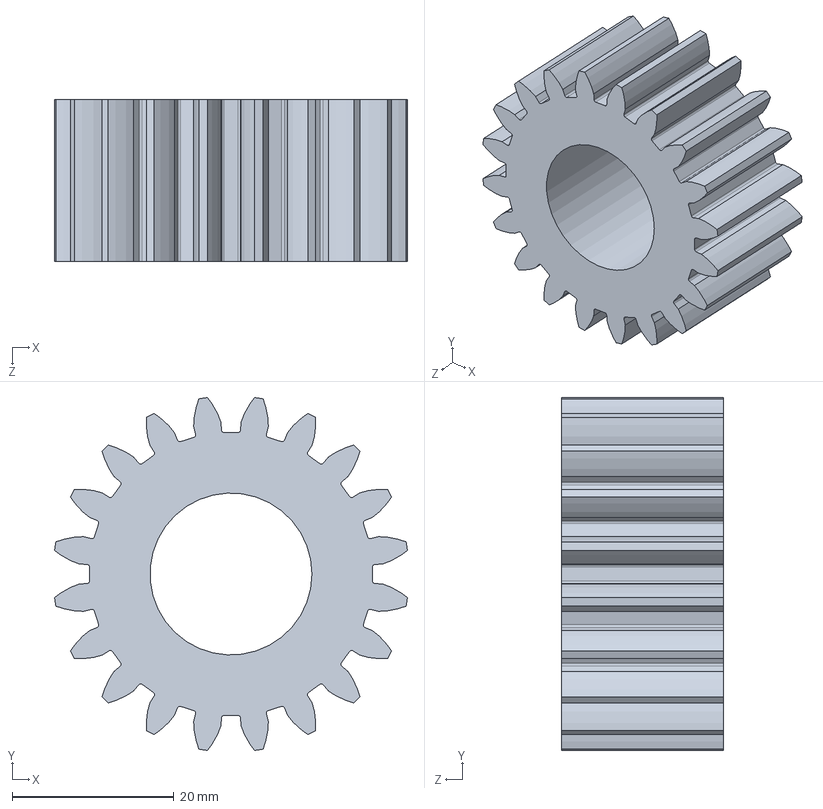
[picture p101: CAD file, 2026-11-10]
资料文件/2组期中考核/工程机器人总装/齿轮-升降机齿轮.SLDPRT
43.6 x 43.6 x 20.0 mm
