leike70/RoboSister_Group2/资料文件/2组期中考核/工程机器人总装/炮塔车架方铝.SLDPRT

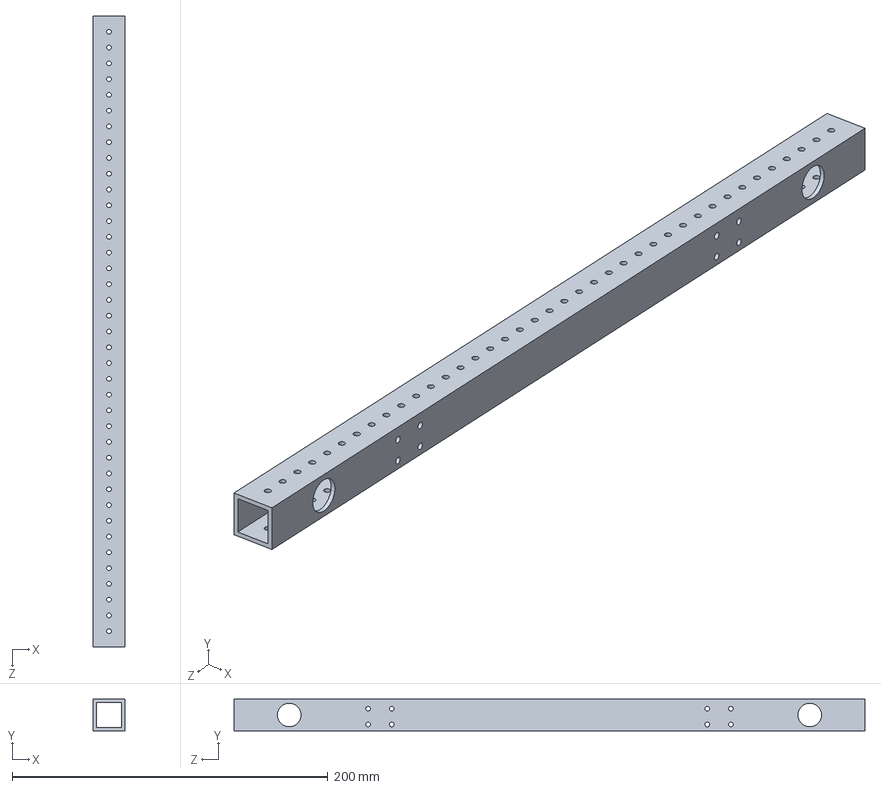
[picture p102: CAD file, 2026-11-10]
资料文件/2组期中考核/工程机器人总装/炮塔车架方铝.SLDPRT
20.0 x 20.0 x 400.0 mm
