leike70/RoboSister_Group2/资料文件/2组期中考核/炮塔机器人总装/电机板下.SLDPRT

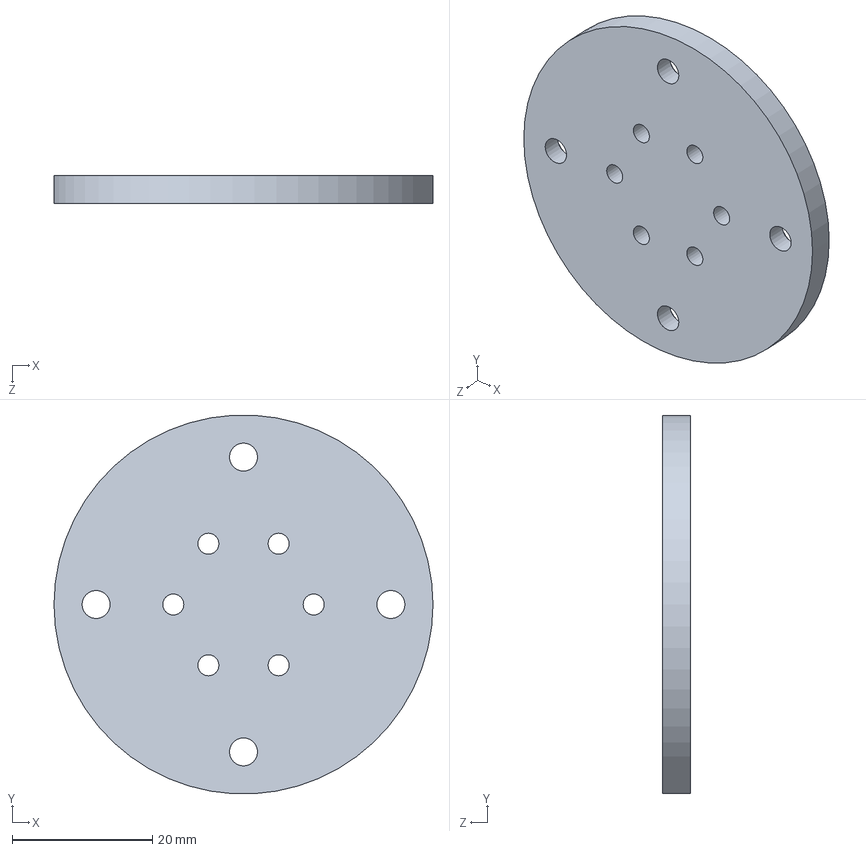
[picture p103: CAD file, 2026-11-10]
资料文件/2组期中考核/炮塔机器人总装/电机板下.SLDPRT
54.0 x 53.9 x 4.00 mm
