leike70/RoboSister_Group2/资料文件/2组期中考核/工程机器人总装/连接板.SLDPRT

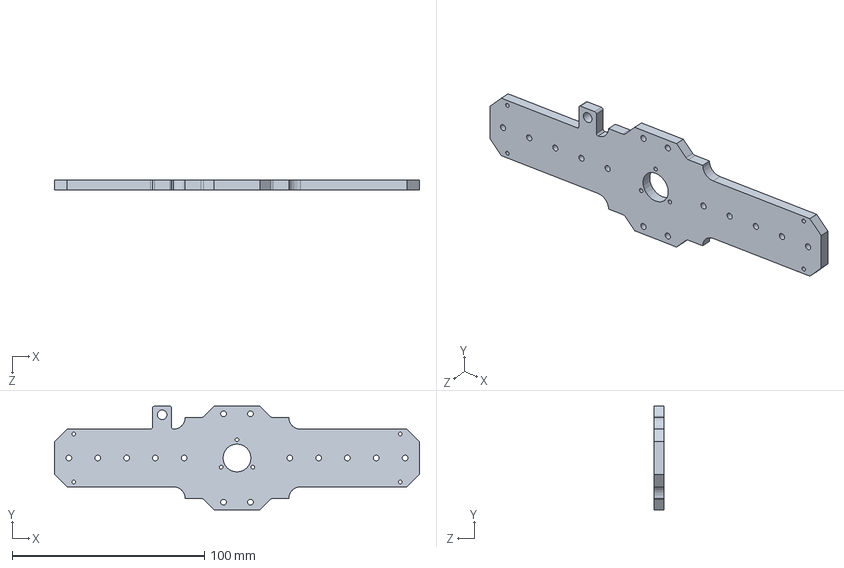
[picture p104: CAD file, 2026-11-10]
资料文件/2组期中考核/工程机器人总装/连接板.SLDPRT
190.0 x 54.0 x 5.00 mm
