leike70/RoboSister_Group2/资料文件/2组期中考核/炮塔机器人总装/天轮电机支撑板_B.SLDPRT

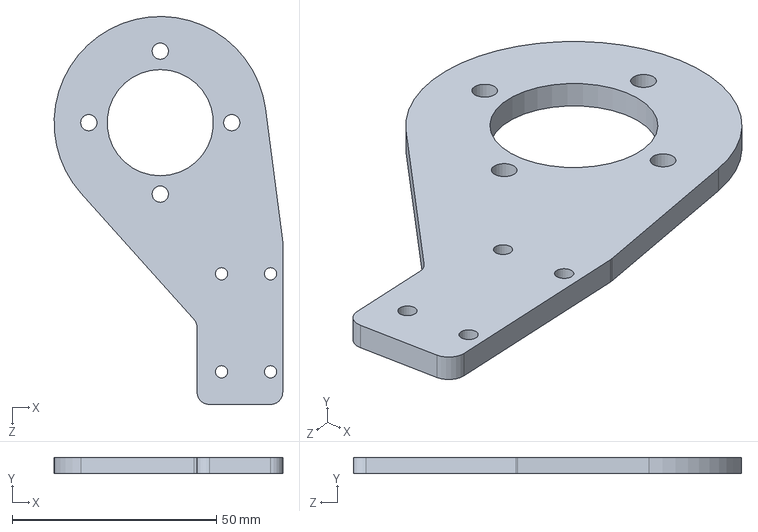
[picture p105: CAD file, 2026-11-10]
资料文件/2组期中考核/炮塔机器人总装/天轮电机支撑板_B.SLDPRT
56.0 x 4.00 x 95.0 mm
