leike70/RoboSister_Group2/资料文件/2组期中考核/炮塔机器人总装/支撑板2.SLDPRT

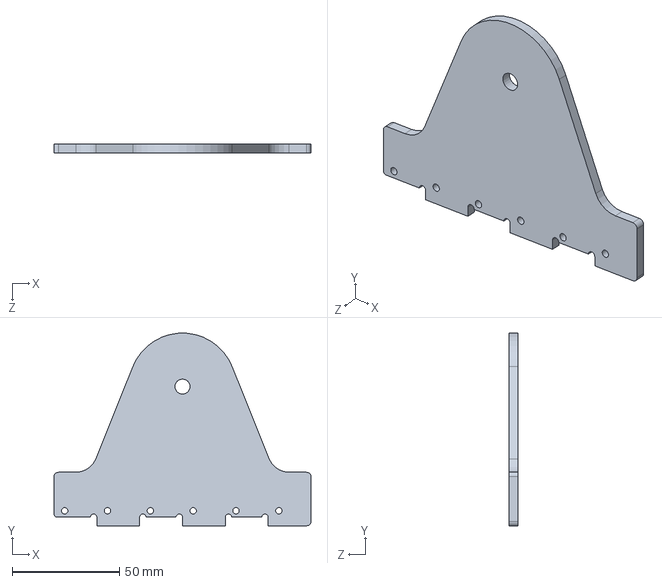
[picture p106: CAD file, 2026-11-10]
资料文件/2组期中考核/炮塔机器人总装/支撑板2.SLDPRT
120.0 x 89.9 x 4.00 mm
