leike70/RoboSister_Group2/资料文件/2组期中考核/工程机器人总装/6020打印件.SLDPRT

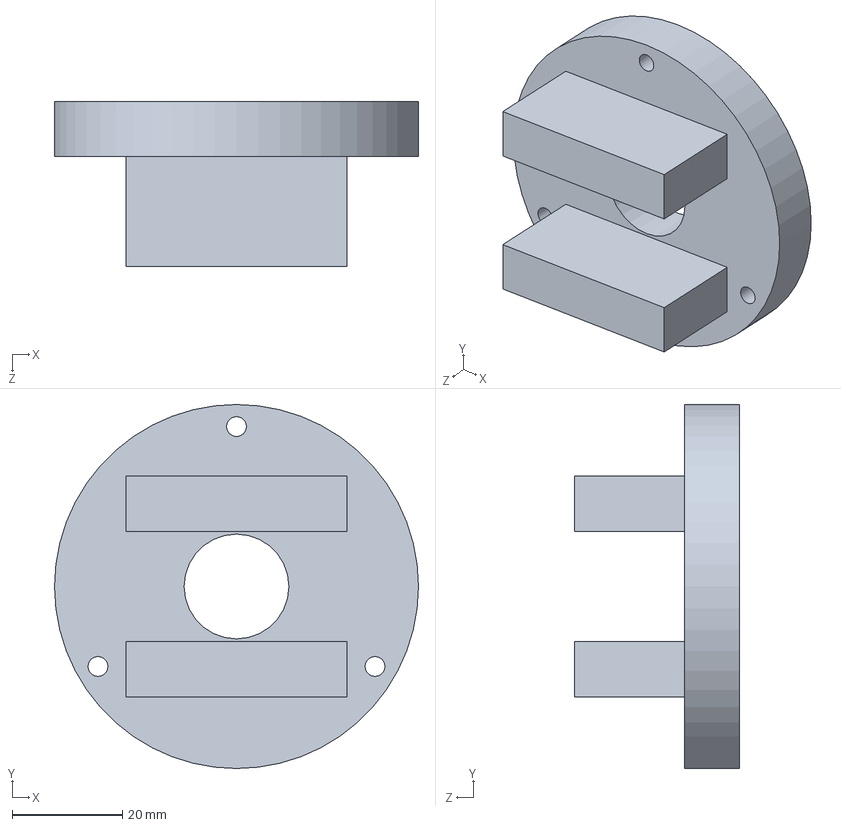
[picture p109: CAD file, 2026-11-10]
资料文件/2组期中考核/工程机器人总装/6020打印件.SLDPRT
66.0 x 66.0 x 30.0 mm
