leike70/RoboSister_Group2/资料文件/2组期中考核/炮塔机器人总装/机加件-传动杆.SLDPRT

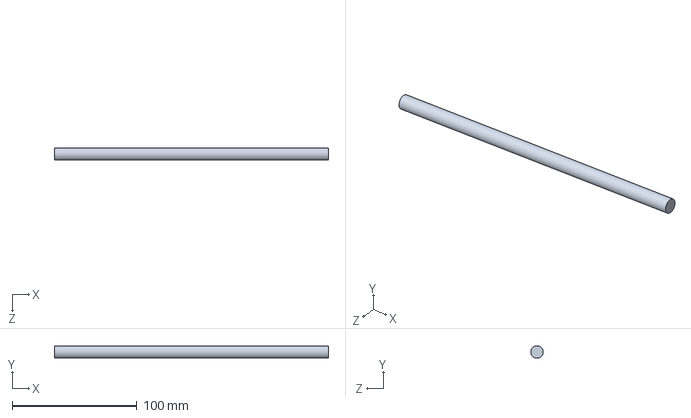
[picture p110: CAD file, 2026-11-10]
资料文件/2组期中考核/炮塔机器人总装/机加件-传动杆.SLDPRT
220.0 x 9.99 x 9.97 mm
