leike70/RoboSister_Group2/资料文件/2组期中考核/炮塔机器人总装/底板.SLDPRT

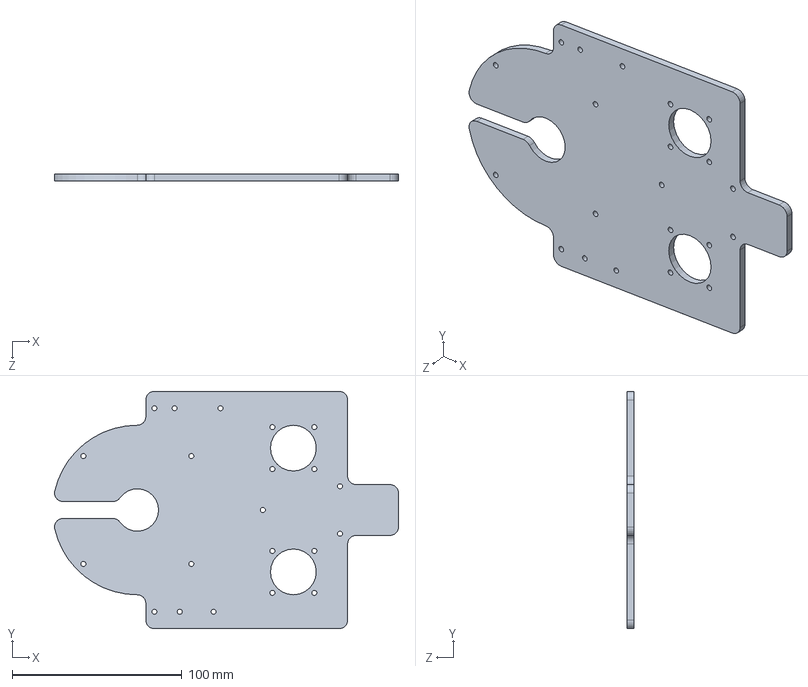
[picture p111: CAD file, 2026-11-10]
资料文件/2组期中考核/炮塔机器人总装/底板.SLDPRT
202.9 x 140.0 x 4.00 mm
