leike70/RoboSister_Group2/资料文件/2组期中考核/炮塔机器人总装/轮组传动部分.SLDASM

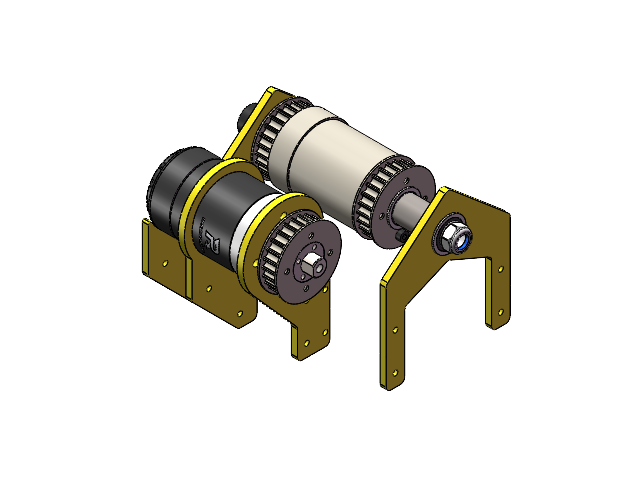
[picture p112: CAD file, 2026-11-10]
资料文件/2组期中考核/炮塔机器人总装/轮组传动部分.SLDASM
胀紧套Z21
深沟球轴承10-19-7 x 2
法兰轴承10-19-7-21-1 x 2
杯头螺栓M3-65
法兰轴承10-19-5-21-1 x 2
塞打螺栓10-M8-100
GB-防松螺母-SJTU x 2
同步带同步轮-电机
天轮支撑板
同步带履带同步轮组合-主动轮
同步带履带同步轮组合-主动轮盖片 x 2
同步带同步轮-电机盖片
天轮支撑板_B
天轮电机支撑板_A
天轮电机支撑板_B
垫片M10-14-1 x 2
尼龙垫柱10-16-4
M3508直流无刷减速电机
尼龙垫柱10-16-4 - 副本
