leike70/RoboSister_Group2/资料文件/2组期中考核/工程机器人总装/轮组传动2号镜像.SLDASM

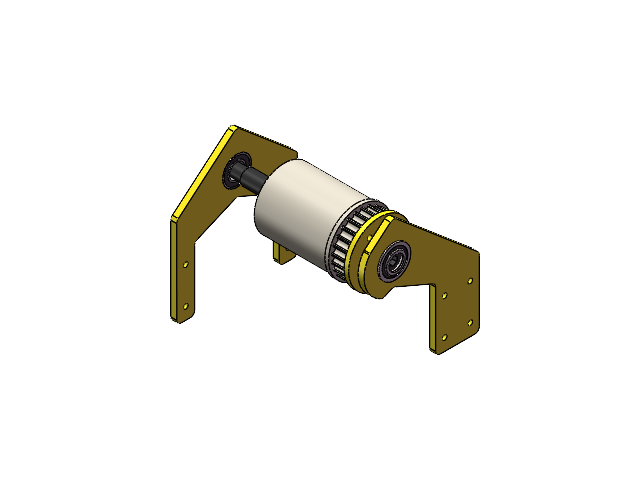
[picture p113: CAD file, 2026-11-10]
资料文件/2组期中考核/工程机器人总装/轮组传动2号镜像.SLDASM
天轮支撑板
天轮支撑板_C
塞打螺栓10-M8-90
GB-防松螺母-SJTU
法兰轴承10-19-5-21-1 x 4
同步带履带同步轮组合-从动轮
深沟球轴承10-19-7 x 2
同步带履带同步轮组合-从动轮盖片
垫片M10-14-1
尼龙垫柱10-16-4
