leike70/RoboSister_Group2/资料文件/2组期中考核/工程机器人总装/机械臂总装 (1).SLDASM

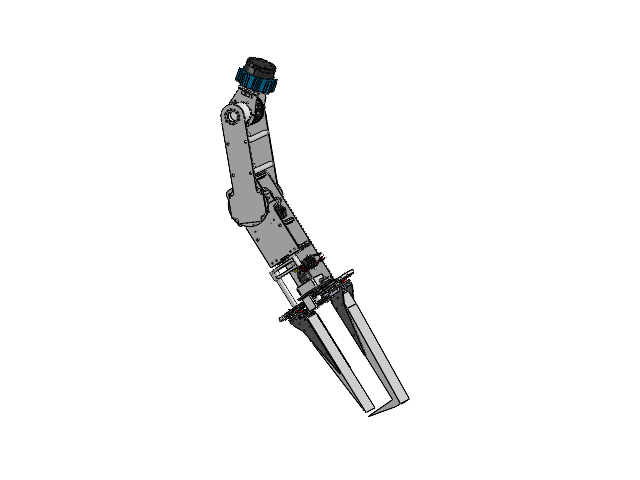
[picture p114: CAD file, 2026-11-10]
资料文件/2组期中考核/工程机器人总装/机械臂总装 (1).SLDASM
yaw底座固定4310直驱版 打印件
yaw电机固定板4310直驱版
DM-J4310-2EC x 2
yaw电机输入件
大pitch底座电机固定板1
yaw轴电机输出板
GB-杯头螺栓-SJTU x 33
深沟球轴承1
深沟球轴承外圈2
机械臂大pitch连接件1
机械臂连接处轴承内圈下
机械臂连接处轴承内圈上
机械臂大小臂连接限位垫块
深沟球轴承外圈
GB-防松螺母-SJTU x 8
铝柱M5D10-100 x 4
铝排2 x 8
爪部电机固定件
roll固定板材1
roll电机固定件
M3508直流无刷减速电机 x 2
roll传动杆1
杯头螺栓M3-14 x 2
防松螺母M3 x 2
roll固定板材2
C620无刷电机调速器 x 2
滚针轴承25-33-16
roll轴承固定件2
铝柱M5D10-60
C610无刷电机调速器
六角铜柱M5-60 x 4
杯头螺栓M8-12 x 2
防松螺母M8 x 2
小pitch连接件1
推力球轴承45-65-14
小pitch轴承固定件1
小pitch轴承固定件2
杯头螺栓M5-25
连接板
台湾上银MGN7C滑块 x 2
台湾上银MGN7C线性滑轨 x 2
爪固定 x 4
铝排 x 4
1.5齿条 x 2
滑轨保护件 x 2
圆柱齿轮25×1.5
滑块-爪连接件 x 2
齿条固定件 x 2
M2006 P36直流无刷减速电机
加长爪2
加长爪1
