leike70/RoboSister_Group2/资料文件/2组期中考核/工程机器人总装/RS工程机械臂底座直驱版.SLDASM

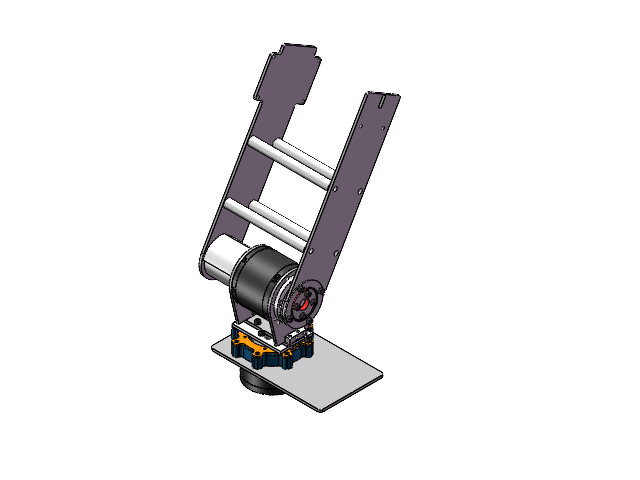
[picture p116: CAD file, 2026-11-10]
资料文件/2组期中考核/工程机器人总装/RS工程机械臂底座直驱版.SLDASM
yaw底座固定4310直驱版 打印件
yaw电机固定板4310直驱版
DM-J4310-2EC x 2
yaw电机输入件
大pitch底座电机固定板1
yaw轴电机输出板
GB-杯头螺栓-SJTU x 24
深沟球轴承1
深沟球轴承外圈2
机械臂大pitch连接件1
机械臂连接处轴承内圈下
机械臂连接处轴承内圈上
机械臂大小臂连接限位垫块
深沟球轴承外圈
GB-防松螺母-SJTU x 8
铝柱M5D10-100 x 4
铝排2 x 2
