leike70/RoboSister_Group2/资料文件/2组期中考核/炮塔机器人总装/轮组传动2号.SLDASM

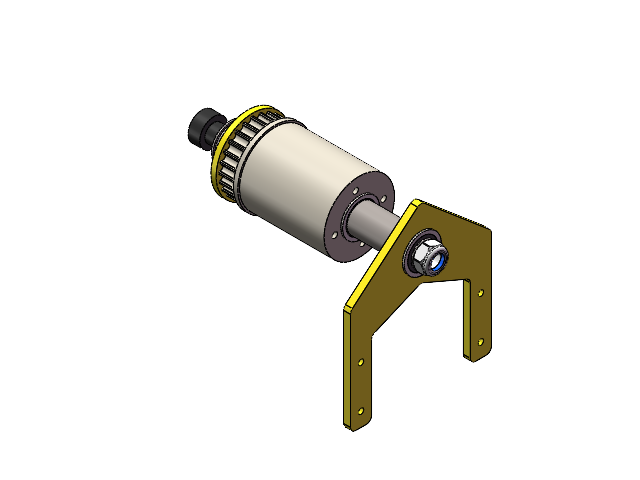
[picture p117: CAD file, 2026-11-10]
资料文件/2组期中考核/炮塔机器人总装/轮组传动2号.SLDASM
法兰轴承10-19-5-21-1 x 4
同步带履带同步轮组合-从动轮
同步带履带同步轮组合-从动轮盖片
深沟球轴承10-19-7 x 2
天轮支撑板
GB-防松螺母-SJTU
垫片M10-14-1 x 2
尼龙垫柱10-16-4
塞打螺栓10-M8-90
尼龙垫柱10-16-4 - 副本 - 副本
