leike70/RoboSister_Group2/资料文件/2组期中考核/工程机器人总装/AAA机械臂总装V3.SLDASM

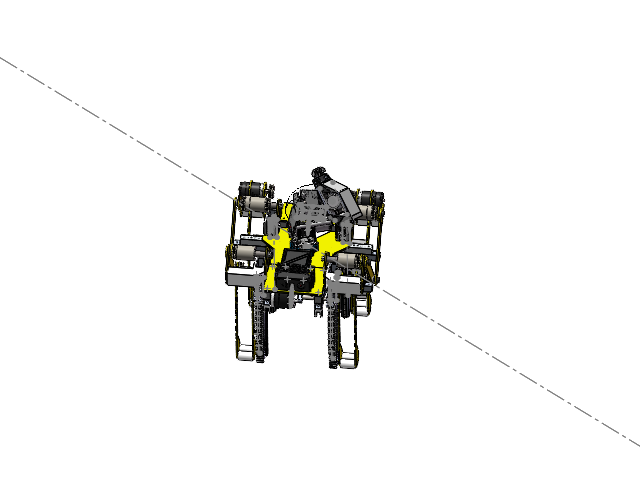
[picture p118: CAD file, 2026-11-10]
资料文件/2组期中考核/工程机器人总装/AAA机械臂总装V3.SLDASM
炮塔车架方铝 x 2
RoboMaster GM6020 x 2
机加件-传动杆 x 2
打印件-齿条 x 5
齿轮-升降机齿轮 x 4
胀紧套Z21 x 4
履带碳板 x 8
炮塔车架方铝 2号- x 2
履带地轮 x 8
零件1 x 2
6020打印件 x 2
方铝-滑块固定 x 4
深沟球轴承10-19-7 x 8
法兰轴承10-19-7-21-1 x 4
杯头螺栓M3-65
法兰轴承10-19-5-21-1 x 19
塞打螺栓10-M8-100 x 2
GB-防松螺母-SJTU x 15
同步带同步轮-电机 x 2
天轮支撑板 x 4
同步带履带同步轮组合-主动轮 x 2
同步带履带同步轮组合-主动轮盖片 x 8
同步带同步轮-电机盖片
天轮支撑板_B x 2
天轮电机支撑板_A x 2
天轮电机支撑板_B x 2
垫片M10-14-1 x 11
尼龙垫柱10-16-4 x 6
M3508直流无刷减速电机 x 4
尼龙垫柱10-16-4 - 副本 x 2
同步带履带同步轮组合-从动轮 x 2
同步带履带同步轮组合-从动轮盖片 x 2
塞打螺栓10-M8-90 x 2
尼龙垫柱10-16-4 - 副本 - 副本 x 2
同步带同步轮-关节 x 2
塞打螺栓10-M8-40 x 2
大板
天轮支撑板_C x 2
台湾上银MGN9C线性滑轨 x 8
台湾上银MGN9C滑块 x 8
天轮打印1号
天轮打印2号
天轮打印3号
同步带连接臂_内 x 2
同步带连接臂_外 x 2
联轴打印 x 2
联轴件 x 2
履带方铝2 x 2
天轮打印1号 - 副本
天轮打印4号 - 副本
天轮打印2号 - 副本
天轮打印3号 - 副本
天轮打印4号
履带支撑打印
电池架底板
TB47S电池模组prt
RM2019裁判系统主控模块MC02
主控支持打印件 x 6
主控支持打印件 小 x 2
主控底板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
