leike70/RoboSister_Group2/资料文件/2组期中考核/炮塔机器人总装/轮组传动连接部分镜像.SLDASM

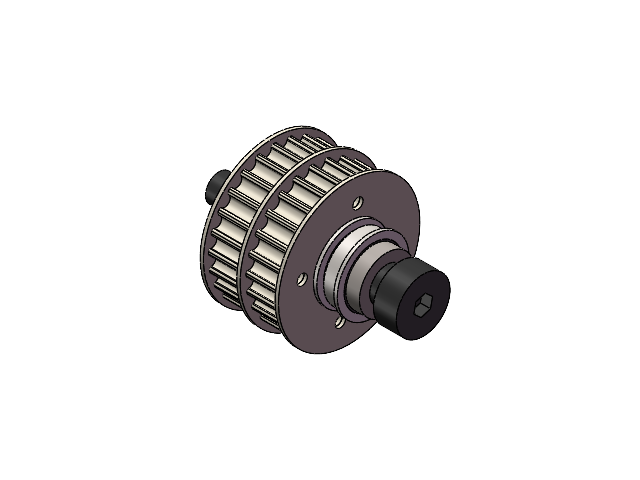
[picture p119: CAD file, 2026-11-10]
资料文件/2组期中考核/炮塔机器人总装/轮组传动连接部分镜像.SLDASM
塞打螺栓10-M8-40
法兰轴承10-19-5-21-1 x 3
同步带同步轮-关节
同步带履带同步轮组合-主动轮盖片 x 2
GB-防松螺母-SJTU
垫片M10-14-1 x 2
尼龙垫柱10-16-4
