leike70/RoboSister_Group2/资料文件/2组期中考核/炮塔机器人总装/DM-J6006-2EC_20240822_1.SLDASM

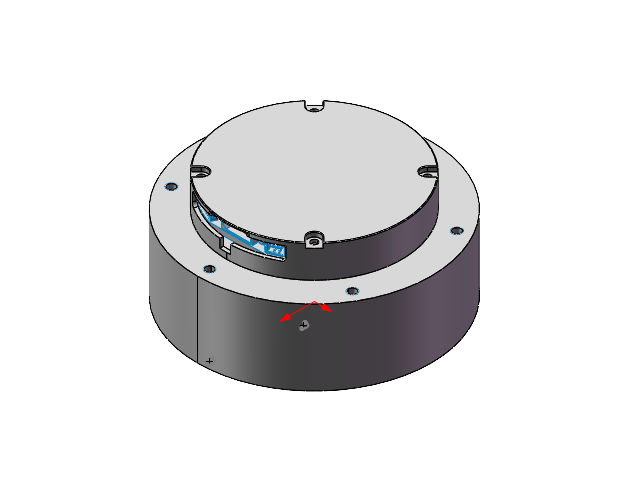
[picture p121: CAD file, 2026-11-10]
资料文件/2组期中考核/炮塔机器人总装/DM-J6006-2EC_20240822_1.SLDASM
6210_0001.stp
DM_6210_3D.stp
DM-6010-V2_1_1-221020A.stp
