leike70/RoboSister_Group2/资料文件/2组期中考核/炮塔机器人总装/装配体2.SLDASM

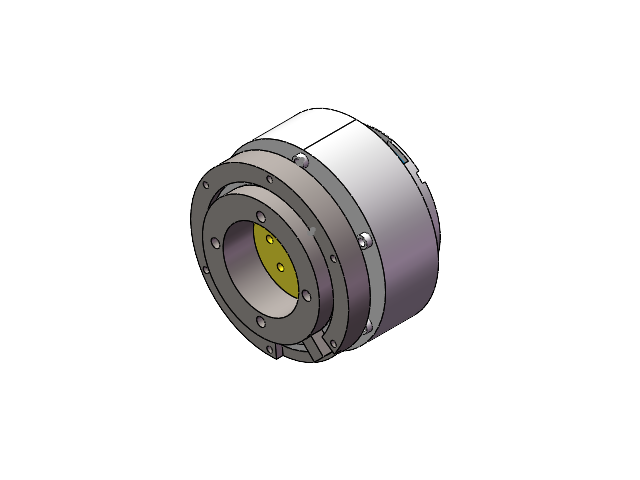
[picture p122: CAD file, 2026-11-10]
资料文件/2组期中考核/炮塔机器人总装/装配体2.SLDASM
电机板下
yaw轴深沟球轴承
yaw轴承法兰
yaw轴轴承底座
6210_0001.stp
DM_6210_3D.stp
DM-6010-V2_1_1-221020A.stp
yaw轴尼龙尼龙垫柱 x 6
