leike70/RoboSister_Group2/资料文件/2组期中考核/炮塔机器人总装/电池.SLDASM

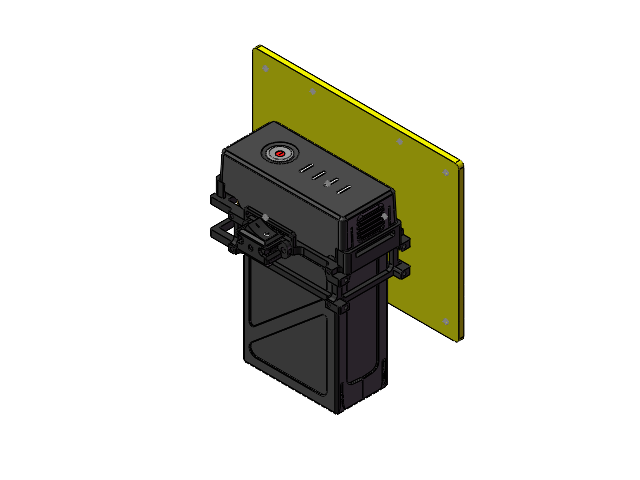
[picture p126: CAD file, 2026-11-10]
资料文件/2组期中考核/炮塔机器人总装/电池.SLDASM
电池架底板
TB47S电池模组prt
