leike70/RoboSister_Group2/资料文件/2组期中考核/炮塔机器人总装/装配体1.SLDASM

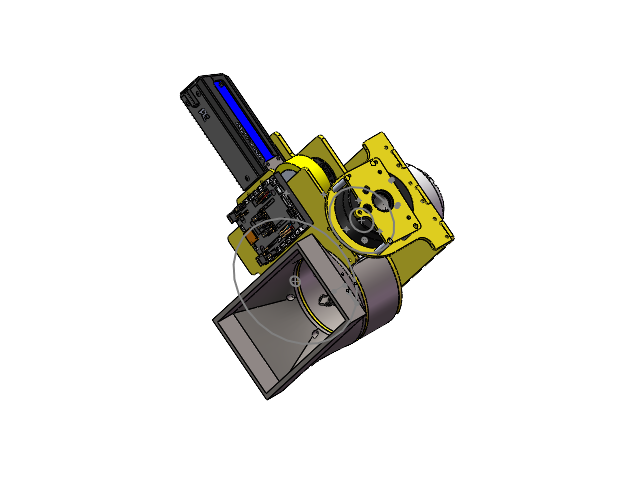
[picture p127: CAD file, 2026-11-10]
资料文件/2组期中考核/炮塔机器人总装/装配体1.SLDASM
传送
弹仓
M2006 P36直流无刷减速电机
装弹漏斗
底板
M3508_WithGear(Simplified) x 2
摩擦轮 x 2
RoboMaster 测速模块（17mm） SM01 2020_奇点李想
发射器
上板
官方元件-RoboMaster 主控板A板_奇点李想
轴铝方管
RoboMaster GM6020
支撑板1
pitch轴电机固定板
pitch轴固定铝柱 x 4
pitch轴小轴承 x 2
轴铝方管 2
GB-平垫圈-SJTU x 2
支撑板2
炮塔与底座过渡板
铝排 x 6
电机板下
yaw轴深沟球轴承
yaw轴承法兰
yaw轴轴承底座
6210_0001.stp
DM_6210_3D.stp
DM-6010-V2_1_1-221020A.stp
yaw轴尼龙尼龙垫柱 x 6
GB-杯头塞打螺栓-SJTU
GB-防松螺母-SJTU
yaw轴过渡板
