leike70/RoboSister_Group2/资料文件/2组期中考核/工程机器人总装/roll连接.SLDASM

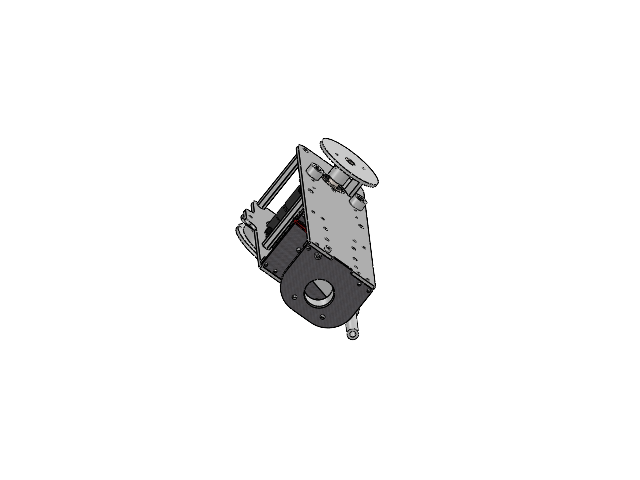
[picture p128: CAD file, 2026-11-10]
资料文件/2组期中考核/工程机器人总装/roll连接.SLDASM
爪部电机固定件
roll固定板材1
roll电机固定件
M3508直流无刷减速电机 x 2
roll传动杆1
杯头螺栓M3-14 x 2
防松螺母M3 x 2
roll固定板材2
C620无刷电机调速器 x 2
滚针轴承25-33-16
roll轴承固定件2
铝柱M5D10-60
C610无刷电机调速器
六角铜柱M5-60 x 4
杯头螺栓M8-12 x 2
防松螺母M8 x 2
小pitch连接件1
推力球轴承45-65-14
小pitch轴承固定件1
小pitch轴承固定件2
铝排2 x 6
杯头螺栓M5-25
