leike70/RoboSister_Group2/资料文件/2组期中考核/工程机器人总装/机械臂-手部.SLDASM

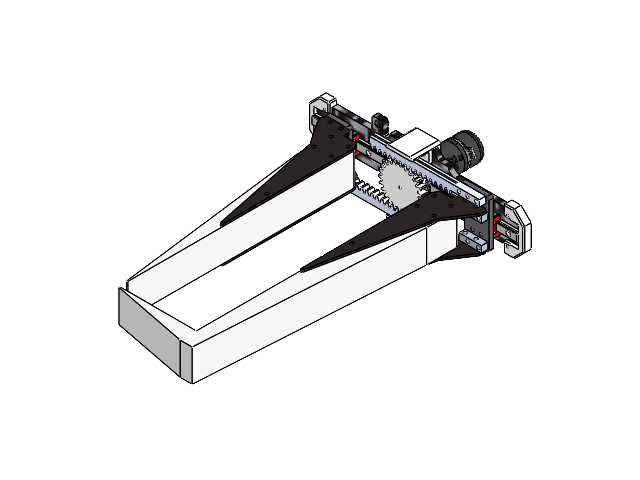
[picture p129: CAD file, 2026-11-10]
资料文件/2组期中考核/工程机器人总装/机械臂-手部.SLDASM
连接板
台湾上银MGN7C滑块 x 2
台湾上银MGN7C线性滑轨 x 2
爪固定 x 4
铝排 x 4
1.5齿条 x 2
滑轨保护件 x 2
圆柱齿轮25×1.5
滑块-爪连接件 x 2
齿条固定件 x 2
M2006 P36直流无刷减速电机
GB-杯头螺栓-SJTU x 9
加长爪2
加长爪1
