leike70/RoboSister_Group2/(list of files, cad)

Other CAD files:
资料文件/2组期中考核/工程机器人总装/轮组传动部分.SLDASM
资料文件/2组期中考核/工程机器人总装/轮组传动部分镜像.SLDASM
资料文件/2组期中考核/工程机器人总装/轮组传动2号.SLDASM
资料文件/2组期中考核/炮塔机器人总装/轮组传动2号镜像.SLDASM
资料文件/2组期中考核/炮塔机器人总装/轮组传动部分连接部分.SLDASM
资料文件/2组期中考核/工程机器人总装/轮组传动连接部分镜像.SLDASM
资料文件/2组期中考核/工程机器人总装/同步带连接臂_内.SLDPRT
资料文件/2组期中考核/工程机器人总装/同步带履带同步轮组合-主动轮盖片.SLDPRT
资料文件/2组期中考核/工程机器人总装/GB-防松螺母-SJTU.SLDPRT
资料文件/2组期中考核/工程机器人总装/履带方铝2.SLDPRT
资料文件/2组期中考核/炮塔机器人总装/GB-六角铜柱-双内螺纹-SJTU.SLDPRT
资料文件/2组期中考核/炮塔机器人总装/零件1.SLDPRT
资料文件/2组期中考核/工程机器人总装/主控底板.SLDPRT
资料文件/2组期中考核/工程机器人总装/M2006 P36直流无刷减速电机.SLDPRT
资料文件/2组期中考核/炮塔机器人总装/同步带连接臂_内.SLDPRT
资料文件/2组期中考核/工程机器人总装/1.5齿条.SLDPRT
资料文件/2组期中考核/工程机器人总装/C610无刷电机调速器.SLDPRT
资料文件/2组期中考核/工程机器人总装/C620无刷电机调速器.SLDPRT
资料文件/2组期中考核/工程机器人总装/roll固定板材2.SLDPRT
资料文件/2组期中考核/工程机器人总装/roll电机固定件.SLDPRT
资料文件/2组期中考核/工程机器人总装/roll轴承固定件2.SLDPRT
资料文件/2组期中考核/工程机器人总装/yaw底座固定4310直驱版 打印件.SLDPRT
资料文件/2组期中考核/工程机器人总装/yaw电机输入件.SLDPRT
资料文件/2组期中考核/工程机器人总装/yaw轴电机输出板.SLDPRT
资料文件/2组期中考核/工程机器人总装/加长爪2.SLDPRT
资料文件/2组期中考核/工程机器人总装/台湾上银MGN7C滑块.SLDPRT
资料文件/2组期中考核/工程机器人总装/同步带履带同步轮组合-从动轮.SLDPRT
资料文件/2组期中考核/工程机器人总装/塞打螺栓10-M8-90.SLDPRT
资料文件/2组期中考核/工程机器人总装/大板.SLDPRT
资料文件/2组期中考核/工程机器人总装/天轮打印1号 - 副本.SLDPRT
资料文件/2组期中考核/工程机器人总装/天轮打印2号 - 副本.SLDPRT
资料文件/2组期中考核/工程机器人总装/天轮打印3号 - 副本.SLDPRT
资料文件/2组期中考核/工程机器人总装/天轮打印4号 - 副本.SLDPRT
资料文件/2组期中考核/工程机器人总装/小pitch轴承固定件1.SLDPRT
资料文件/2组期中考核/工程机器人总装/小pitch轴承固定件2.SLDPRT
资料文件/2组期中考核/工程机器人总装/尼龙垫柱10-16-4 - 副本 - 副本.SLDPRT
资料文件/2组期中考核/工程机器人总装/尼龙垫柱10-16-4 - 副本.SLDPRT
资料文件/2组期中考核/工程机器人总装/打印件-齿条.SLDPRT
资料文件/2组期中考核/工程机器人总装/机械臂大pitch连接件1.SLDPRT
资料文件/2组期中考核/工程机器人总装/机械臂大小臂连接限位垫块.SLDPRT
资料文件/2组期中考核/工程机器人总装/杯头螺栓M3-14.SLDPRT
资料文件/2组期中考核/工程机器人总装/杯头螺栓M5-25.SLDPRT
资料文件/2组期中考核/工程机器人总装/滑块-爪连接件.SLDPRT
资料文件/2组期中考核/工程机器人总装/滚针轴承25-33-16.SLDPRT
资料文件/2组期中考核/工程机器人总装/爪固定.SLDPRT
资料文件/2组期中考核/工程机器人总装/电池架底板.SLDPRT
资料文件/2组期中考核/工程机器人总装/联轴件.SLDPRT
资料文件/2组期中考核/工程机器人总装/铝柱M5D10-100.SLDPRT
资料文件/2组期中考核/工程机器人总装/防松螺母M3.SLDPRT
资料文件/2组期中考核/工程机器人总装/零件1.SLDPRT
资料文件/2组期中考核/炮塔机器人总装/GB-防松螺母-SJTU.SLDPRT
资料文件/2组期中考核/炮塔机器人总装/RoboMaster 测速模块（17mm） SM01 2020_奇点李想.SLDPRT
资料文件/2组期中考核/炮塔机器人总装/yaw轴承法兰.SLDPRT
资料文件/2组期中考核/炮塔机器人总装/主控支持打印件 小.SLDPRT
资料文件/2组期中考核/炮塔机器人总装/同步带履带同步轮组合-主动轮盖片.SLDPRT
资料文件/2组期中考核/炮塔机器人总装/同步带履带同步轮组合-从动轮.SLDPRT
资料文件/2组期中考核/炮塔机器人总装/塞打螺栓10-M8-90.SLDPRT
资料文件/2组期中考核/炮塔机器人总装/大板.SLDPRT
资料文件/2组期中考核/炮塔机器人总装/天轮打印1号 - 副本.SLDPRT
资料文件/2组期中考核/炮塔机器人总装/天轮打印2号 - 副本.SLDPRT
资料文件/2组期中考核/炮塔机器人总装/天轮打印3号 - 副本.SLDPRT
资料文件/2组期中考核/炮塔机器人总装/天轮打印4号 - 副本.SLDPRT
资料文件/2组期中考核/炮塔机器人总装/尼龙垫柱10-16-4 - 副本 - 副本.SLDPRT
资料文件/2组期中考核/炮塔机器人总装/尼龙垫柱10-16-4 - 副本.SLDPRT
资料文件/2组期中考核/炮塔机器人总装/打印件-齿条.SLDPRT
资料文件/2组期中考核/炮塔机器人总装/电池架底板.SLDPRT
资料文件/2组期中考核/炮塔机器人总装/联轴件.SLDPRT
资料文件/2组期中考核/炮塔机器人总装/轴铝方管 2.SLDPRT
资料文件/2组期中考核/炮塔机器人总装/铝排.SLDPRT
