leike70/RoboSister_Group2/资料文件/陀螺仪移植文件/README.pdf

# 惯导姿态解算项目

# 1 硬件平台说明

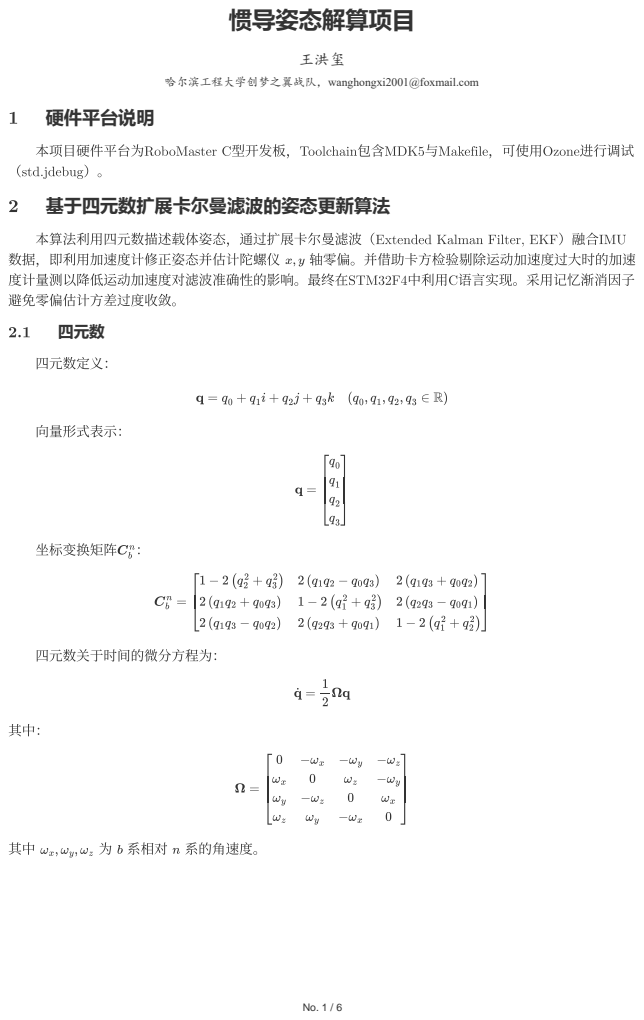
[picture p130: page 1]
王洪玺; （std.jdebug）。; 基于四元数扩展卡尔曼滤波的姿态更新算法; 数据，即利用加速度计修正姿态并估计陀螺仪; 轴零偏。并借助卡方检验剔除运动加速度过大时的加速; 四元数; 四元数定义：; 向量形式表示：; 坐标变换矩阵; 四元数关于时间的微分方程为：; 为 系相对; 系的角速度。

哈尔滨工程大学创梦之翼战队，wanghongxi2001@foxmail.com

本项目硬件平台为RoboMaster C型开发板，Toolchain包含MDK5与Makefile，可使用Ozone进行调试

本算法利用四元数描述载体姿态，通过扩展卡尔曼滤波（Extended Kalman Filter, EKF）融合IMU
度计量测以降低运动加速度对滤波准确性的影响。最终在STM32F4中利用C语言实现。采用记忆渐消因子
避免零偏估计方差过度收敛。

2.2 | 状态向量
2.3 | 过程模型

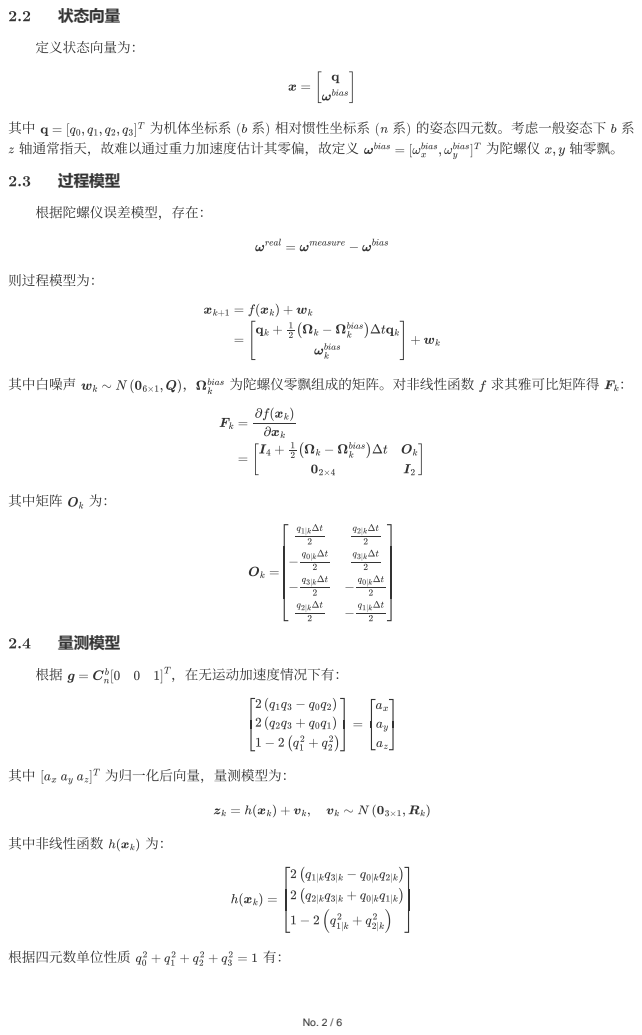
[picture p131: page 2]
定义状态向量为：; 为机体坐标系 ( 系) 相对惯性坐标系 ( 系) 的姿态四元数。考虑一般姿态下 系; 轴通常指天，故难以通过重力加速度估计其零偏，故定义; 为陀螺仪; 轴零飘。; 根据陀螺仪误差模型，存在：; 则过程模型为：; 其中白噪声; 为陀螺仪零飘组成的矩阵。对非线性函数; 求其雅可比矩阵得; 其中矩阵; 量测模型; ，在无运动加速度情况下有：; 为归一化后向量，量测模型为：; 其中非线性函数; 根据四元数单位性质

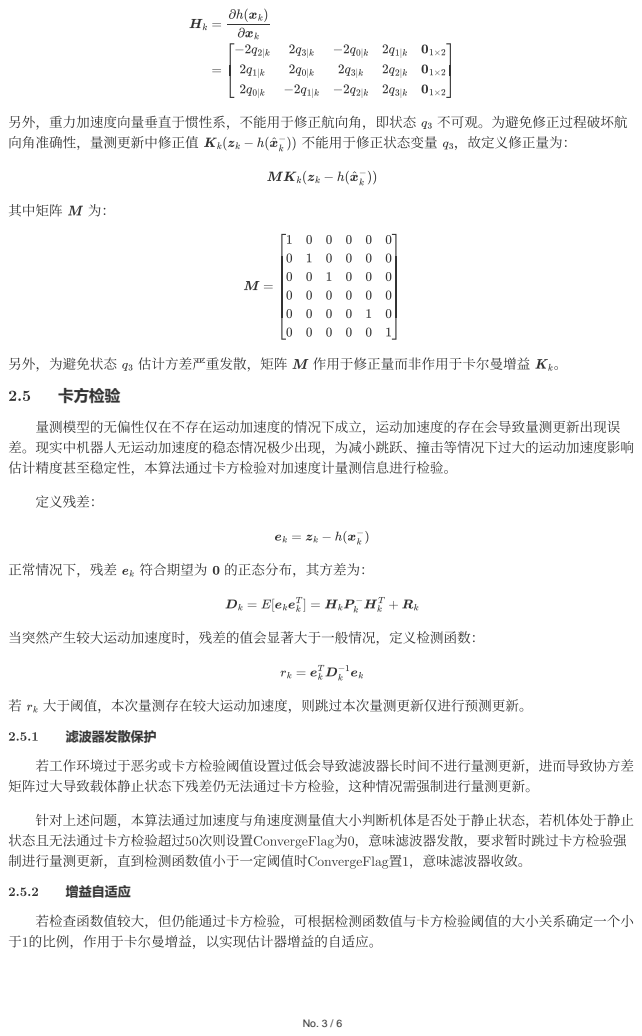
[picture p132: page 3]
另外，重力加速度向量垂直于惯性系，不能用于修正航向角，即状态; 不可观。为避免修正过程破坏航; 向角准确性，量测更新中修正值; 不能用于修正状态变量 ，故定义修正量为：; 其中矩阵; 另外，为避免状态; 估计方差严重发散，矩阵; 作用于修正量而非作用于卡尔曼增益; 卡方检验; 定义残差：; 正常情况下，残差; 符合期望为; 的正态分布，其方差为：; 大于阈值，本次量测存在较大运动加速度，则跳过本次量测更新仅进行预测更新。; 滤波器发散保护; 若工作环境过于恶劣或卡方检验阈值设置过低会导致滤波器长时间不进行量测更新，进而导致协方差 矩阵过大导致载体静止状态下残差仍无法通过卡方检验，这种情况需强制进行量测更新。; 增益自适应

量测模型的无偏性仅在不存在运动加速度的情况下成立，运动加速度的存在会导致量测更新出现误
差。现实中机器人无运动加速度的稳态情况极少出现，为减小跳跃、撞击等情况下过大的运动加速度影响
估计精度甚至稳定性，本算法通过卡方检验对加速度计量测信息进行检验。

当突然产生较大运动加速度时，残差的值会显著大于一般情况，定义检测函数：

针对上述问题，本算法通过加速度与角速度测量值大小判断机体是否处于静止状态，若机体处于静止
状态且无法通过卡方检验超过50次则设置ConvergeFlag为0，意味滤波器发散，要求暂时跳过卡方检验强
制进行量测更新，直到检测函数值小于一定阈值时ConvergeFlag置1，意味滤波器收敛。

若检查函数值较大，但仍能通过卡方检验，可根据检测函数值与卡方检验阈值的大小关系确定一个小
于1的比例，作用于卡尔曼增益，以实现估计器增益的自适应。

## 2.6 渐消因子

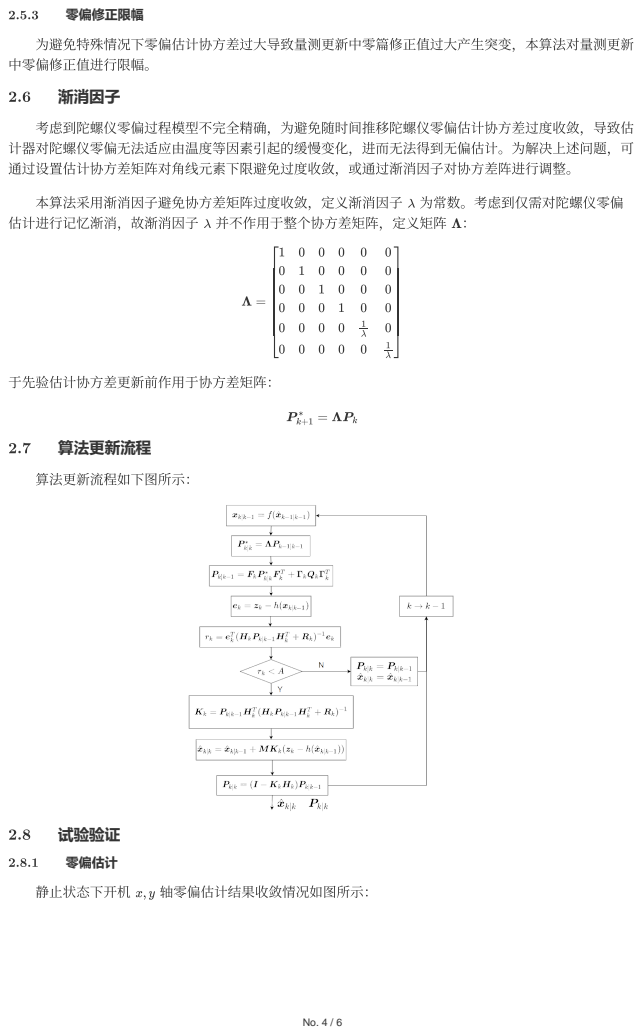
[picture p133: page 4]
零偏修正限幅; 为避免特殊情况下零偏估计协方差过大导致量测更新中零篇修正值过大产生突变，本算法对量测更新 中零偏修正值进行限幅。; 本算法采用渐消因子避免协方差矩阵过度收敛，定义渐消因子; 为常数。考虑到仅需对陀螺仪零偏; 估计进行记忆渐消，故渐消因子; 并不作用于整个协方差矩阵，定义矩阵 ：; 于先验估计协方差更新前作用于协方差矩阵：; 算法更新流程; 算法更新流程如下图所示：; 试验验证; 零偏估计; 静止状态下开机; 轴零偏估计结果收敛情况如图所示：

考虑到陀螺仪零偏过程模型不完全精确，为避免随时间推移陀螺仪零偏估计协方差过度收敛，导致估
计器对陀螺仪零偏无法适应由温度等因素引起的缓慢变化，进而无法得到无偏估计。为解决上述问题，可
通过设置估计协方差矩阵对角线元素下限避免过度收敛，或通过渐消因子对协方差阵进行调整。

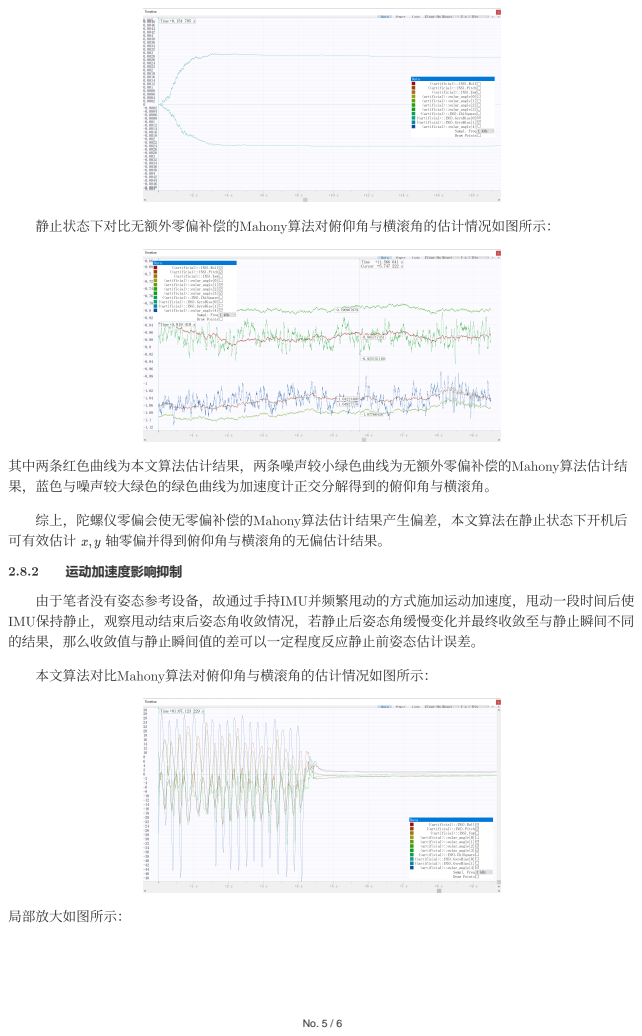
[picture p134: page 5]
静止状态下对比无额外零偏补偿的Mahony算法对俯仰角与横滚角的估计情况如图所示：; 其中两条红色曲线为本文算法估计结果，两条噪声较小绿色曲线为无额外零偏补偿的Mahony算法估计结 果，蓝色与噪声较大绿色的绿色曲线为加速度计正交分解得到的俯仰角与横滚角。; 可有效估计; 轴零偏并得到俯仰角与横滚角的无偏估计结果。; 运动加速度影响抑制; 本文算法对比Mahony算法对俯仰角与横滚角的估计情况如图所示：; 局部放大如图所示：

综上，陀螺仪零偏会使无零偏补偿的Mahony算法估计结果产生偏差，本文算法在静止状态下开机后

由于笔者没有姿态参考设备，故通过手持IMU并频繁甩动的方式施加运动加速度，甩动一段时间后使
IMU保持静止，观察甩动结束后姿态角收敛情况，若静止后姿态角缓慢变化并最终收敛至与静止瞬间不同
的结果，那么收敛值与静止瞬间值的差可以一定程度反应静止前姿态估计误差。

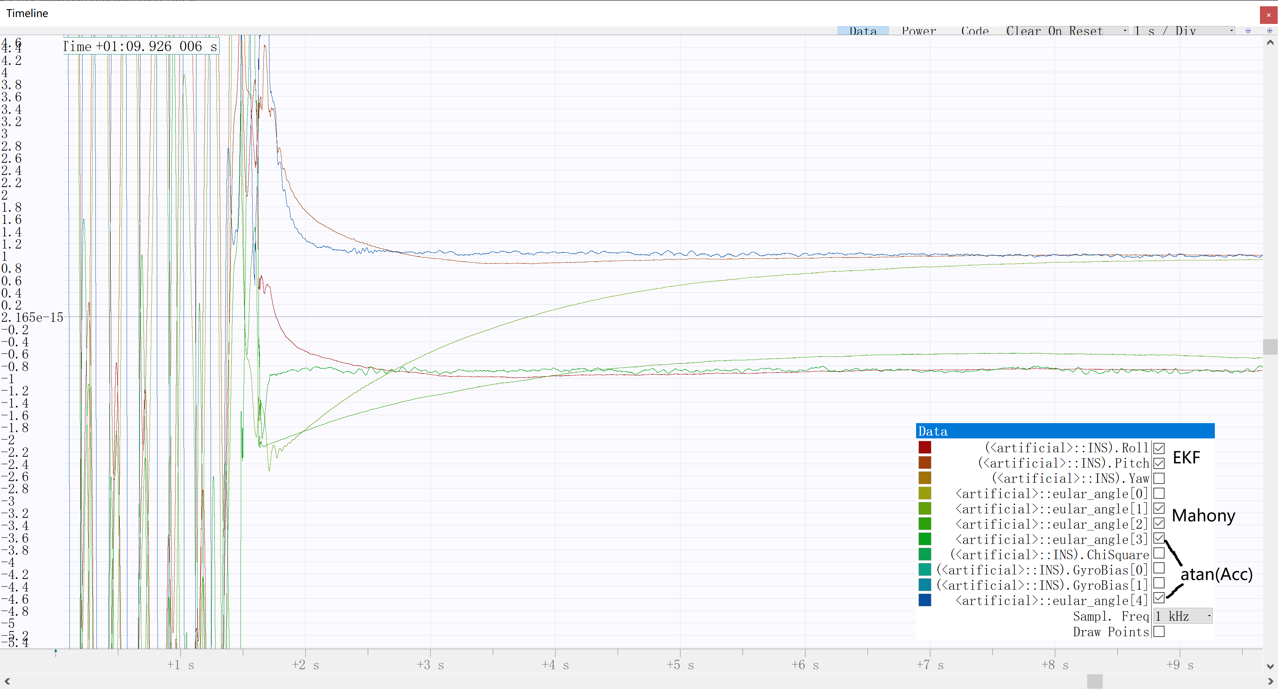
[picture p135: figure]

其中两条红色曲线为本文算法估计结果，两条噪声较小绿色曲线为无额外零偏补偿的Mahony算法估计结 果，蓝色与噪声较大绿色的绿色曲线为加速度计正交分解得到的俯仰角与横滚角（经过一定低通滤波）。

综上，得益于卡方检验，本算法对运动加速度对姿态估计的不良影响具有一定程度的抑制作用。
