leike70/RoboSister_Group2/project file/Engineering robots/Core/Inc/main.h

#define CS1_ACCEL_Pin GPIO_PIN_4
#define CS1_ACCEL_GPIO_Port GPIOA
#define CS1_GYRO_Pin GPIO_PIN_0
#define CS1_GYRO_GPIO_Port GPIOB
#define IMU_HEAT_Pin GPIO_PIN_6
#define IMU_HEAT_GPIO_Port GPIOF
