leike70/RoboSister_Group2/project file/Engineering robots/Core/Src/usart.c

/**
  ******************************************************************************
  * @file    usart.c
  * @brief   USART1 调试备用口 + USART3 遥控接收（DR16/DT7 DBUS）。
  *
  * USART3：PC11 RX、PC10 TX，100 kbps、8 数据位、偶校验、1 停止位；
  *         HAL 用 9B + EVEN 表示“8 数据位 + 偶校验”；接收 DMA 为
  *         DMA1 Stream1 Channel4，NORMAL 模式，由 IDLE 事件结束一帧。
  * USART1：PA9 TX、PB7 RX，115200、8N1，仅资源预留，不接遥控。
  ******************************************************************************
  */
#include "usart.h"

UART_HandleTypeDef huart1;
UART_HandleTypeDef huart3;
DMA_HandleTypeDef hdma_usart3_rx;

void MX_USART1_UART_Init(void)
{
    huart1.Instance = USART1;
    huart1.Init.BaudRate = 115200;
    huart1.Init.WordLength = UART_WORDLENGTH_8B;
    huart1.Init.StopBits = UART_STOPBITS_1;
    huart1.Init.Parity = UART_PARITY_NONE;
    huart1.Init.Mode = UART_MODE_TX_RX;
    huart1.Init.HwFlowCtl = UART_HWCONTROL_NONE;
    huart1.Init.OverSampling = UART_OVERSAMPLING_16;
    if (HAL_UART_Init(&huart1) != HAL_OK) {
        Error_Handler();
    }
}

void MX_USART3_UART_Init(void)
{
    huart3.Instance = USART3;
    huart3.Init.BaudRate = 100000;
    huart3.Init.WordLength = UART_WORDLENGTH_9B;
    huart3.Init.StopBits = UART_STOPBITS_1;
    huart3.Init.Parity = UART_PARITY_EVEN;
    huart3.Init.Mode = UART_MODE_TX_RX;
    huart3.Init.HwFlowCtl = UART_HWCONTROL_NONE;
    huart3.Init.OverSampling = UART_OVERSAMPLING_16;
    if (HAL_UART_Init(&huart3) != HAL_OK) {
        Error_Handler();
    }
}

void HAL_UART_MspInit(UART_HandleTypeDef *uart)
{
    GPIO_InitTypeDef gpio = {0};
    gpio.Mode = GPIO_MODE_AF_PP;
    gpio.Pull = GPIO_NOPULL;
    gpio.Speed = GPIO_SPEED_FREQ_VERY_HIGH;

    if (uart->Instance == USART3) {
        __HAL_RCC_USART3_CLK_ENABLE();
        __HAL_RCC_GPIOC_CLK_ENABLE();
        gpio.Alternate = GPIO_AF7_USART3;
        gpio.Pin = GPIO_PIN_10 | GPIO_PIN_11;
        HAL_GPIO_Init(GPIOC, &gpio);

        hdma_usart3_rx.Instance = DMA1_Stream1;
        hdma_usart3_rx.Init.Channel = DMA_CHANNEL_4;
        hdma_usart3_rx.Init.Direction = DMA_PERIPH_TO_MEMORY;
        hdma_usart3_rx.Init.PeriphInc = DMA_PINC_DISABLE;
        hdma_usart3_rx.Init.MemInc = DMA_MINC_ENABLE;
        hdma_usart3_rx.Init.PeriphDataAlignment = DMA_PDATAALIGN_BYTE;
        hdma_usart3_rx.Init.MemDataAlignment = DMA_MDATAALIGN_BYTE;
        hdma_usart3_rx.Init.Mode = DMA_NORMAL;
        hdma_usart3_rx.Init.Priority = DMA_PRIORITY_HIGH;
        hdma_usart3_rx.Init.FIFOMode = DMA_FIFOMODE_DISABLE;
        if (HAL_DMA_Init(&hdma_usart3_rx) != HAL_OK) {
            Error_Handler();
        }
        __HAL_LINKDMA(uart, hdmarx, hdma_usart3_rx);
        HAL_NVIC_SetPriority(USART3_IRQn, 5, 0);
        HAL_NVIC_EnableIRQ(USART3_IRQn);
    } else if (uart->Instance == USART1) {
        __HAL_RCC_USART1_CLK_ENABLE();
        __HAL_RCC_GPIOA_CLK_ENABLE();
        __HAL_RCC_GPIOB_CLK_ENABLE();
        gpio.Alternate = GPIO_AF7_USART1;
        gpio.Pin = GPIO_PIN_9;
        HAL_GPIO_Init(GPIOA, &gpio);
        gpio.Pin = GPIO_PIN_7;
        HAL_GPIO_Init(GPIOB, &gpio);
    }
}

void HAL_UART_MspDeInit(UART_HandleTypeDef *uart)
{
    if (uart->Instance == USART3) {
        HAL_NVIC_DisableIRQ(USART3_IRQn);
        HAL_NVIC_DisableIRQ(DMA1_Stream1_IRQn);
        if (uart->hdmarx != NULL) {
            (void)HAL_DMA_DeInit(uart->hdmarx);
        }
        HAL_GPIO_DeInit(GPIOC, GPIO_PIN_10 | GPIO_PIN_11);
        __HAL_RCC_USART3_CLK_DISABLE();
    } else if (uart->Instance == USART1) {
        HAL_GPIO_DeInit(GPIOA, GPIO_PIN_9);
        HAL_GPIO_DeInit(GPIOB, GPIO_PIN_7);
        __HAL_RCC_USART1_CLK_DISABLE();
    }
}
