leike70/RoboSister_Group2/project file/Engineering robots/User_Driver/IMU/kalman_filter.h

/**
 ******************************************************************************
 * @file    kalman filter.h
 * @author  Wang Hongxi
 * @version V1.2.2
 * @date    2022/1/8
 * @brief
 ******************************************************************************
 * @attention
 *
 ******************************************************************************
 */
#ifndef __KALMAN_FILTER_H
#define __KALMAN_FILTER_H

/* Port: portable scalar backend; fixed storage for the six-state IMU filter. */
#include "imu_matrix.h"
#define mat imu_matrix_t
#define Matrix_Init imu_matrix_init
#define Matrix_Add imu_matrix_add
#define Matrix_Subtract imu_matrix_sub
#define Matrix_Multiply imu_matrix_mult
#define Matrix_Transpose imu_matrix_trans
#define Matrix_Inverse imu_matrix_inverse

typedef struct kf_t
{
    float storage[512];
    uint8_t byte_storage[12];
    float *FilteredValue;
    float *MeasuredVector;
    float *ControlVector;

    uint8_t xhatSize;
    uint8_t uSize;
    uint8_t zSize;

    uint8_t UseAutoAdjustment;
    uint8_t MeasurementValidNum;

    uint8_t *MeasurementMap;      // 量测与状态的关系 how measurement relates to the state
    float *MeasurementDegree;     // 测量值对应H矩阵元素值 elements of each measurement in H
    float *MatR_DiagonalElements; // 量测方差 variance for each measurement
    float *StateMinVariance;      // 最小方差 避免方差过度收敛 suppress filter excessive convergence
    uint8_t *temp;

    // 配合用户定义函数使用,作为标志位用于判断是否要跳过标准KF中五个环节中的任意一个
    uint8_t SkipEq1, SkipEq2, SkipEq3, SkipEq4, SkipEq5;

    // definiion of struct mat: rows & cols & pointer to vars
    mat xhat;      // x(k|k)
    mat xhatminus; // x(k|k-1)
    mat u;         // control vector u
    mat z;         // measurement vector z
    mat P;         // covariance matrix P(k|k)
    mat Pminus;    // covariance matrix P(k|k-1)
    mat F, FT;     // state transition matrix F FT
    mat B;         // control matrix B
    mat H, HT;     // measurement matrix H
    mat Q;         // process noise covariance matrix Q
    mat R;         // measurement noise covariance matrix R
    mat K;         // kalman gain  K
    mat S, temp_matrix, temp_matrix1, temp_vector, temp_vector1;

    int8_t MatStatus;

    // 用户定义函数,可以替换或扩展基准KF的功能
    void (*User_Func0_f)(struct kf_t *kf);
    void (*User_Func1_f)(struct kf_t *kf);
    void (*User_Func2_f)(struct kf_t *kf);
    void (*User_Func3_f)(struct kf_t *kf);
    void (*User_Func4_f)(struct kf_t *kf);
    void (*User_Func5_f)(struct kf_t *kf);
    void (*User_Func6_f)(struct kf_t *kf);
    
    // 矩阵存储空间指针
    float *xhat_data, *xhatminus_data;
    float *u_data;
    float *z_data;
    float *P_data, *Pminus_data;
    float *F_data, *FT_data;
    float *B_data;
    float *H_data, *HT_data;
    float *Q_data;
    float *R_data;
    float *K_data;
    float *S_data, *temp_matrix_data, *temp_matrix_data1, *temp_vector_data, *temp_vector_data1;
} KalmanFilter_t;

extern uint16_t sizeof_float, sizeof_double;

void Kalman_Filter_Init(KalmanFilter_t *kf, uint8_t xhatSize, uint8_t uSize, uint8_t zSize);
void Kalman_Filter_Measure(KalmanFilter_t *kf);
void Kalman_Filter_xhatMinusUpdate(KalmanFilter_t *kf);
void Kalman_Filter_PminusUpdate(KalmanFilter_t *kf);
void Kalman_Filter_SetK(KalmanFilter_t *kf);
void Kalman_Filter_xhatUpdate(KalmanFilter_t *kf);
void Kalman_Filter_P_Update(KalmanFilter_t *kf);
float *Kalman_Filter_Update(KalmanFilter_t *kf);

#endif //__KALMAN_FILTER_H
