leike70/RoboSister_Group2/(notices)

Notices in the files:
project file/Turret Robot/Core/Inc/main.h:
Copyright (c) 2026 STMicroelectronics.
All rights reserved.
This software is licensed under terms that can be found in the LICENSE file
